68mschmitt/cleavboard/assets/README.md

# Shared assets

- [layout/](layout/README.md): original keyboard layout and plate inputs.
- [artwork/taviana/](artwork/taviana/README.md): supplied logo, board placement
  previews and recorded artwork checks.

Design-specific reference images, models and manufacturing outputs belong to
their design under [`designs/`](../designs/README.md).
