68mschmitt/cleavboard/assets/layout/README.md

# Original layout inputs

These supplied files retain their original contents with descriptive filenames:

| File | Original filename |
| --- | --- |
| [keyboard-layout.json](keyboard-layout.json) | `keyboard-layout(1).json` |
| [keyboard-layout.svg](keyboard-layout.svg) | `keyboard-layout(1).svg` |
| [original-plate.dxf](original-plate.dxf) | `plate-2026-11-07T22_24_25.197Z.dxf` |
| [original-plate.svg](original-plate.svg) | `plate-2026-11-07T22_24_27.294Z.svg` |

Originally supplied in `plate-2026-11-07T22_24_25.197Z/`.
The module design's generator reads `keyboard-layout.json`. Its generated plate,
stabilizer coupons and mounting references are in
[`designs/module-rp2040/mechanical/`](../../designs/module-rp2040/mechanical/README.md).
