68mschmitt/cleavboard/designs/module-rp2040/mechanical/mounting-holes.csv

reference | x_mm | y_mm | drill_mm | reserved_diameter_mm
H1 | 4 | 4 | 2.2 | 6
H2 | 110 | 23.8 | 2.2 | 6
H3 | 220 | 23.8 | 2.2 | 6
H4 | 330 | 23.8 | 2.2 | 6
H5 | 395 | 26 | 2.2 | 6
H6 | 313 | 70 | 2.2 | 6
H7 | 4 | 143 | 2.2 | 6
H8 | 90 | 138 | 2.2 | 6
H9 | 220 | 138 | 2.2 | 6
H10 | 365 | 138 | 2.2 | 6
H11 | 448 | 138 | 2.2 | 6
