68mschmitt/cleavboard/assets/artwork/taviana/embedded-top.png

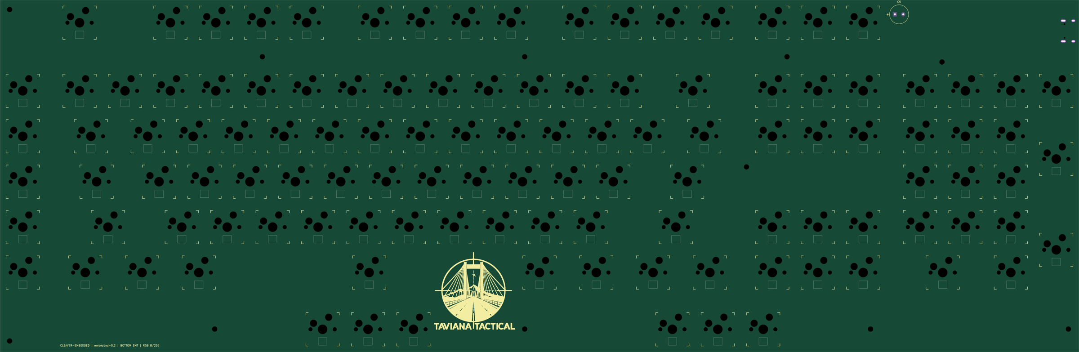
assets/artwork/taviana/embedded-top.png
