68mschmitt/cleavboard/assets/artwork/taviana/module-top.png

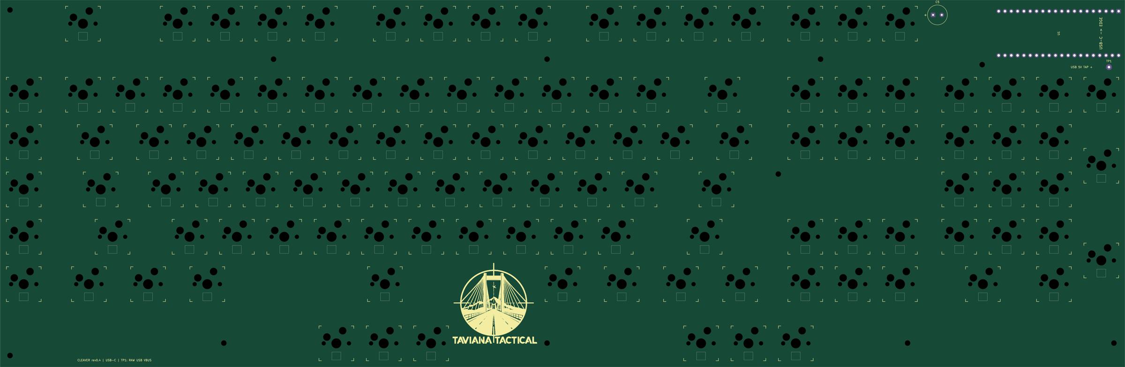
assets/artwork/taviana/module-top.png
