68mschmitt/cleavboard/assets/artwork/taviana/tavi-tac.png

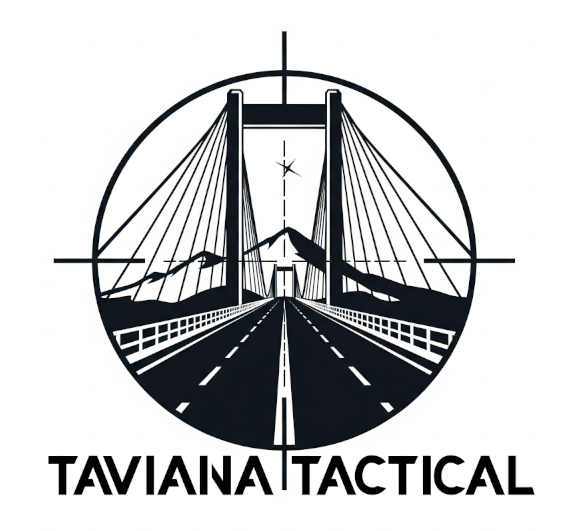
assets/artwork/taviana/tavi-tac.png
