68mschmitt/cleavboard/designs/embedded-rp2040/review/current-review/B.Cu-controller.png

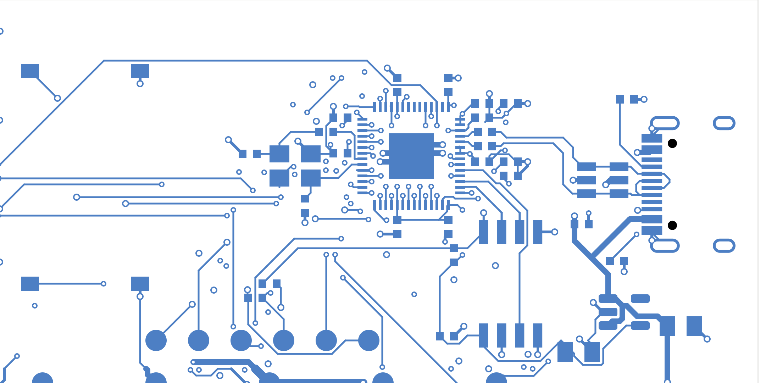
designs/embedded-rp2040/review/current-review/B.Cu-controller.png
