68mschmitt/cleavboard/designs/embedded-rp2040/review/current-review/B.Cu.png

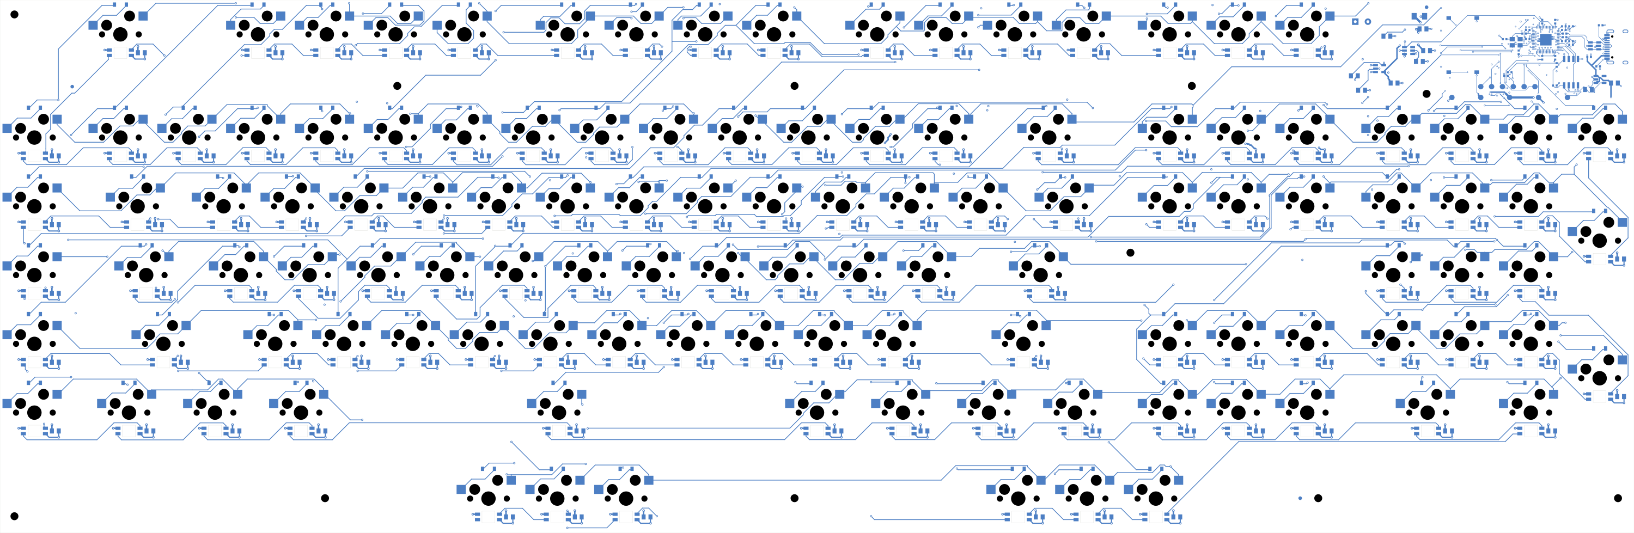
designs/embedded-rp2040/review/current-review/B.Cu.png
