68mschmitt/cleavboard/designs/embedded-rp2040/review/current-review/F.Cu-fan-in.png

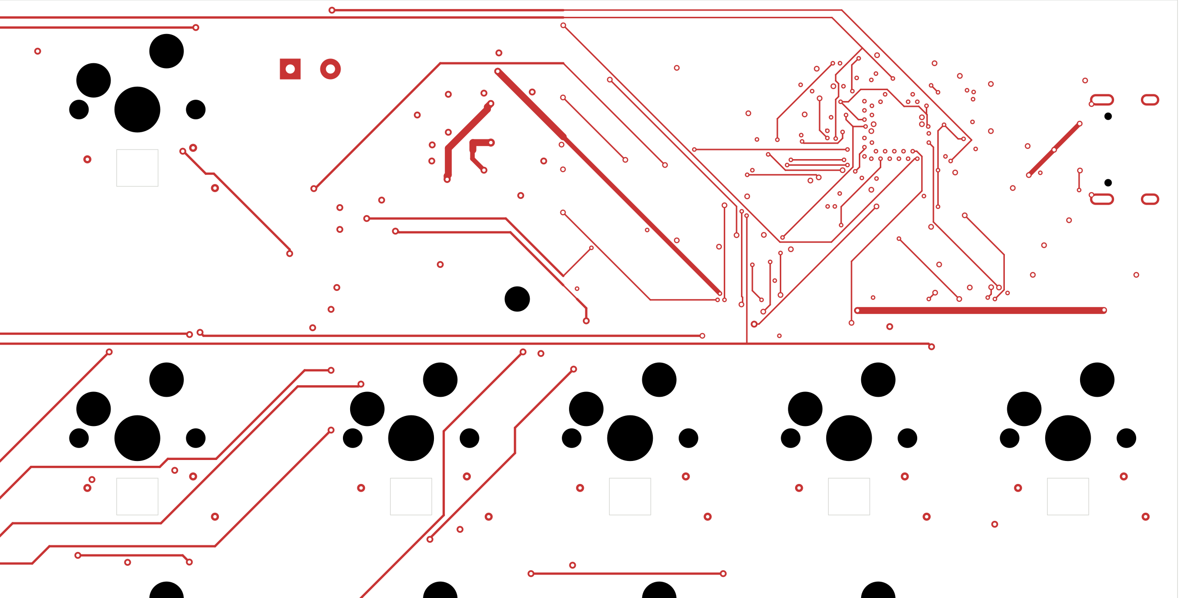
designs/embedded-rp2040/review/current-review/F.Cu-fan-in.png
