68mschmitt/cleavboard/designs/embedded-rp2040/review/current-review/F.Cu.png

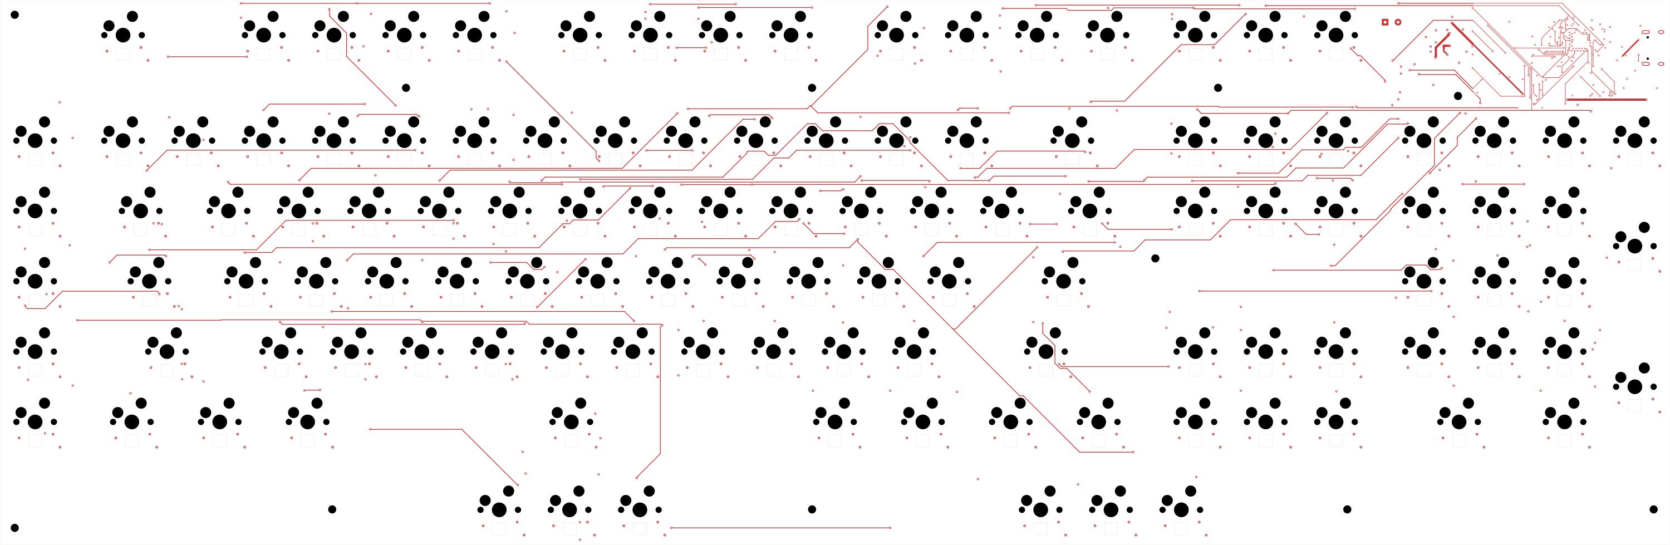
designs/embedded-rp2040/review/current-review/F.Cu.png
