68mschmitt/cleavboard/designs/embedded-rp2040/review/current-review/In1.Cu-fan-in.png

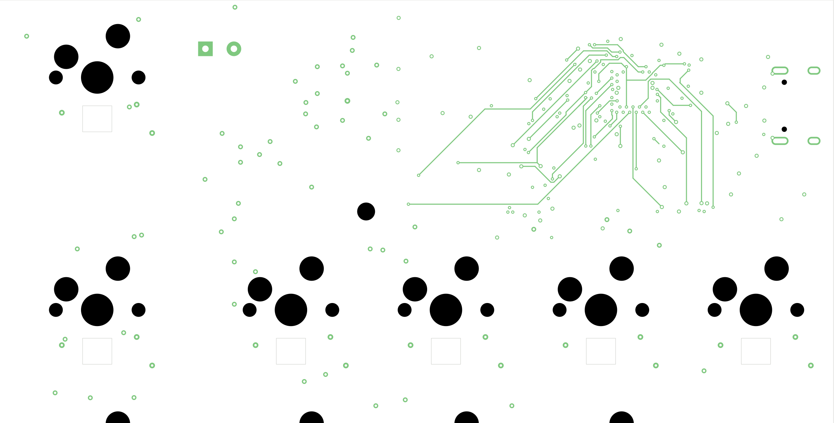
designs/embedded-rp2040/review/current-review/In1.Cu-fan-in.png
