68mschmitt/cleavboard/designs/embedded-rp2040/review/current-review/In1.Cu.png

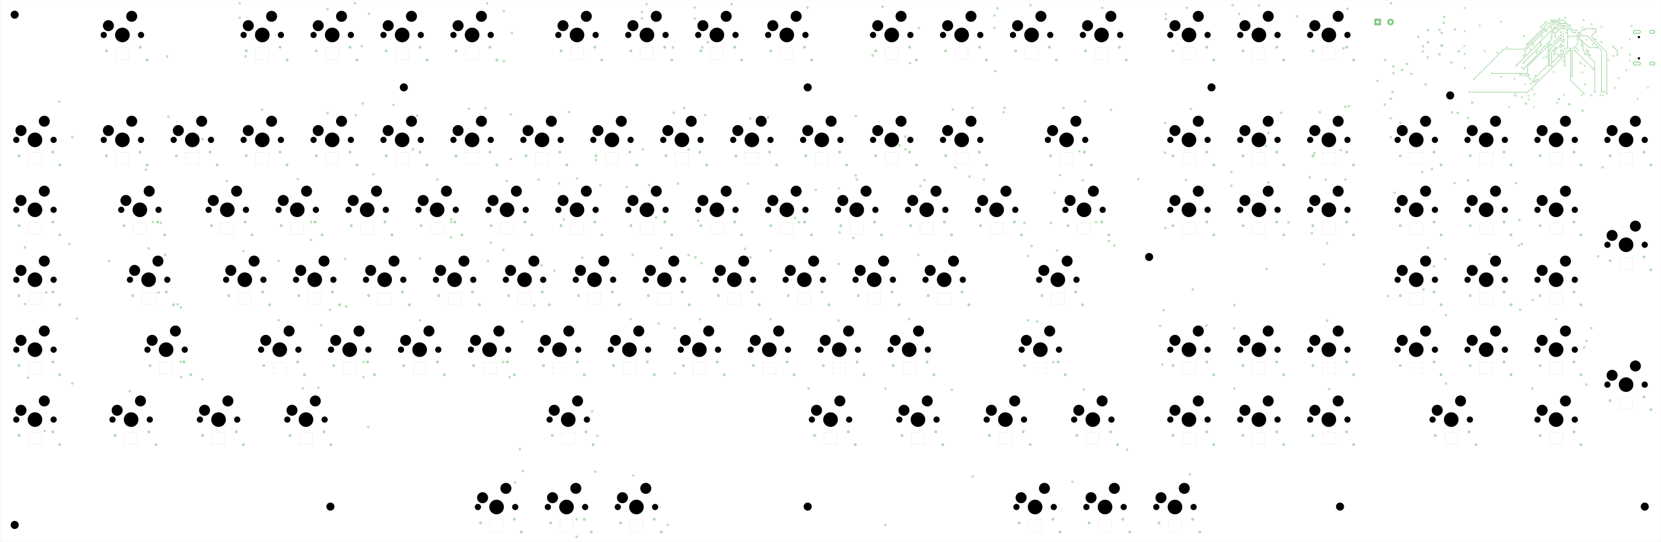
designs/embedded-rp2040/review/current-review/In1.Cu.png
