68mschmitt/cleavboard/designs/embedded-rp2040/review/current-review/In2.Cu-controller.png

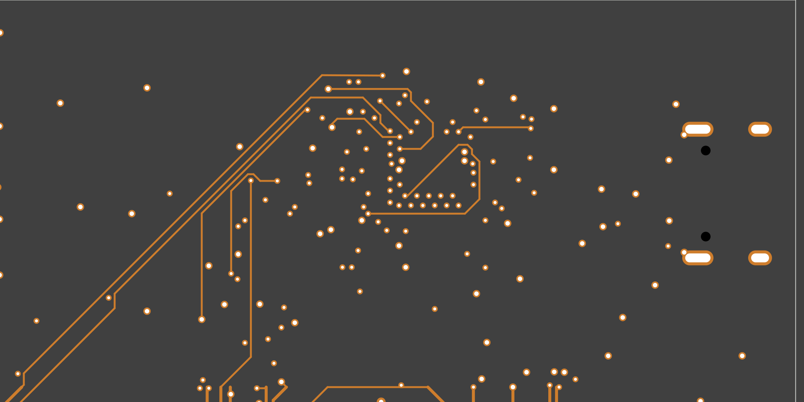
designs/embedded-rp2040/review/current-review/In2.Cu-controller.png
