68mschmitt/cleavboard/designs/embedded-rp2040/review/current-review/In2.Cu-fan-in.png

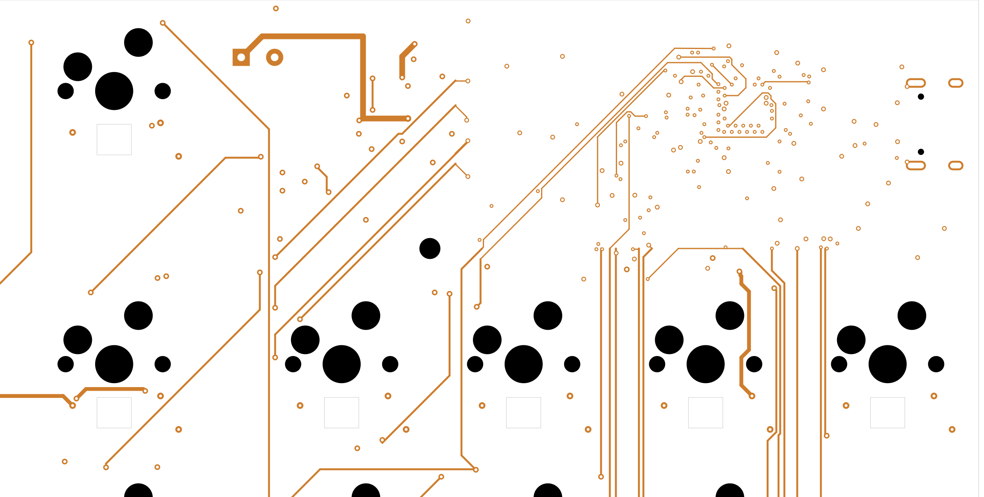
designs/embedded-rp2040/review/current-review/In2.Cu-fan-in.png
