68mschmitt/cleavboard/designs/module-rp2040/previews/Cleaver-bottom.png

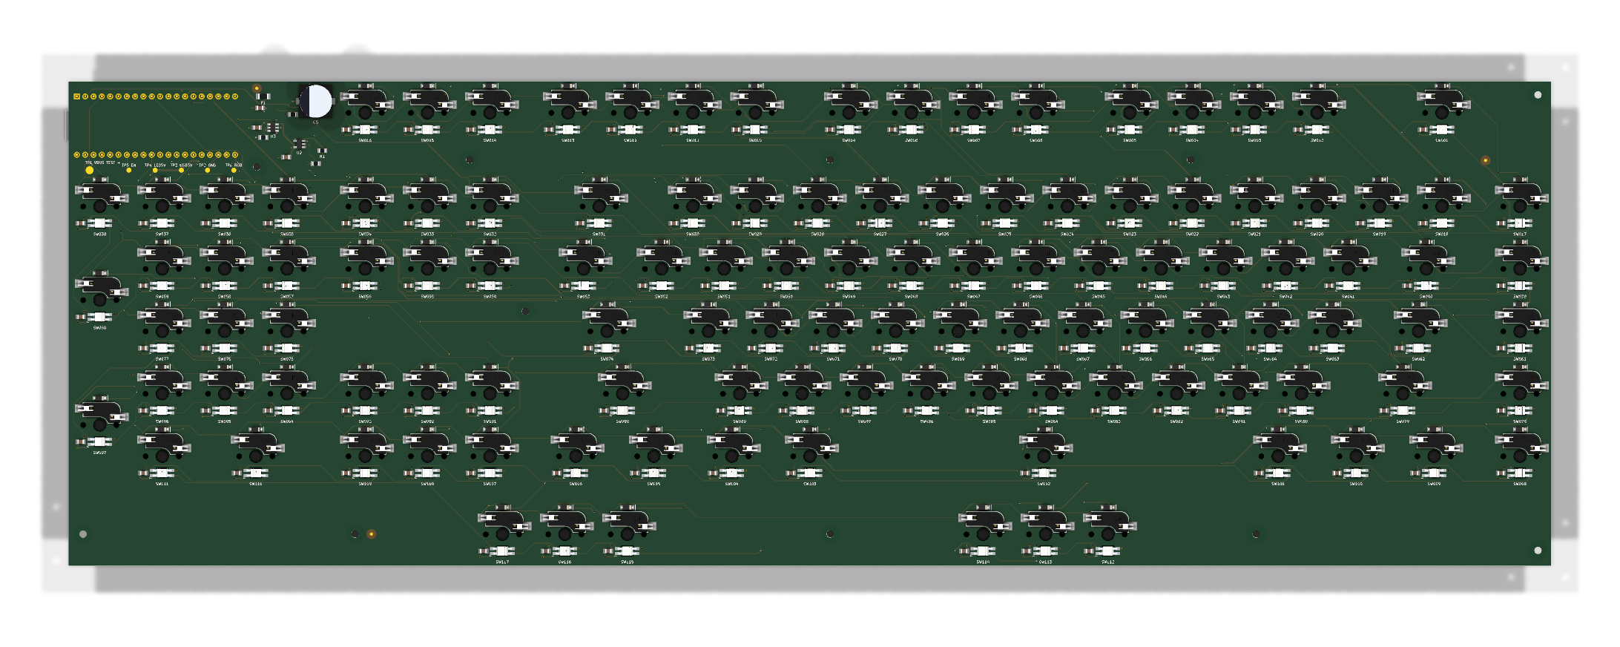
designs/module-rp2040/previews/Cleaver-bottom.png
