68mschmitt/cleavboard/designs/module-rp2040/previews/Cleaver-rev0.7-top.png

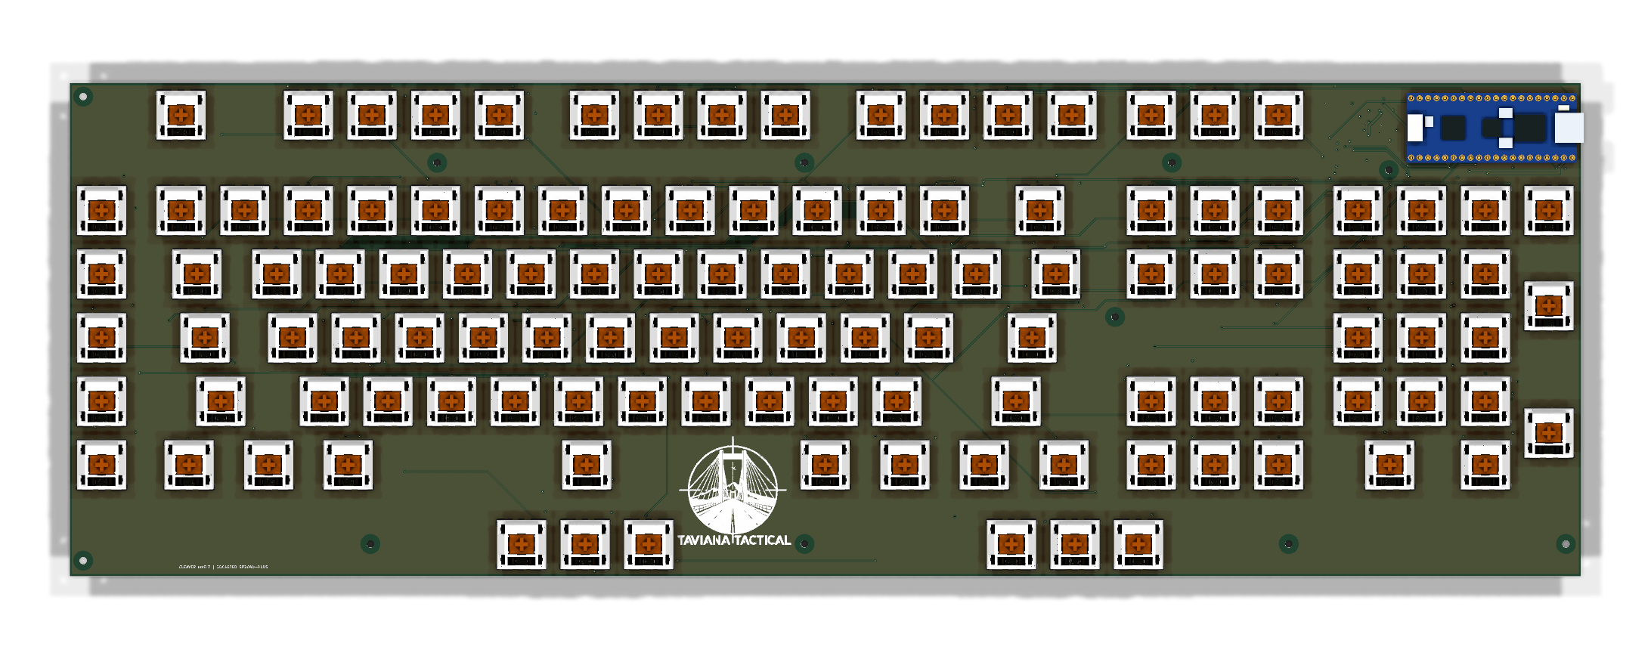
designs/module-rp2040/previews/Cleaver-rev0.7-top.png
