68mschmitt/cleavboard/designs/module-rp2040/references/usb-vbus-ref-pic.jpg

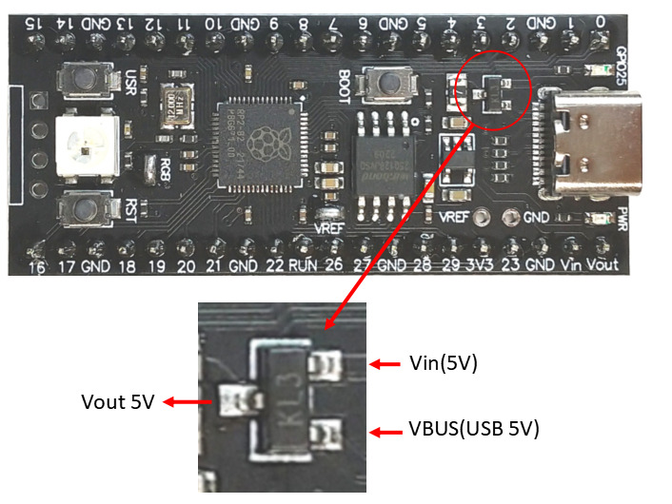
designs/module-rp2040/references/usb-vbus-ref-pic.jpg
