68mschmitt/cleavboard/designs/single-color-devboard/review/3d-bottom.png

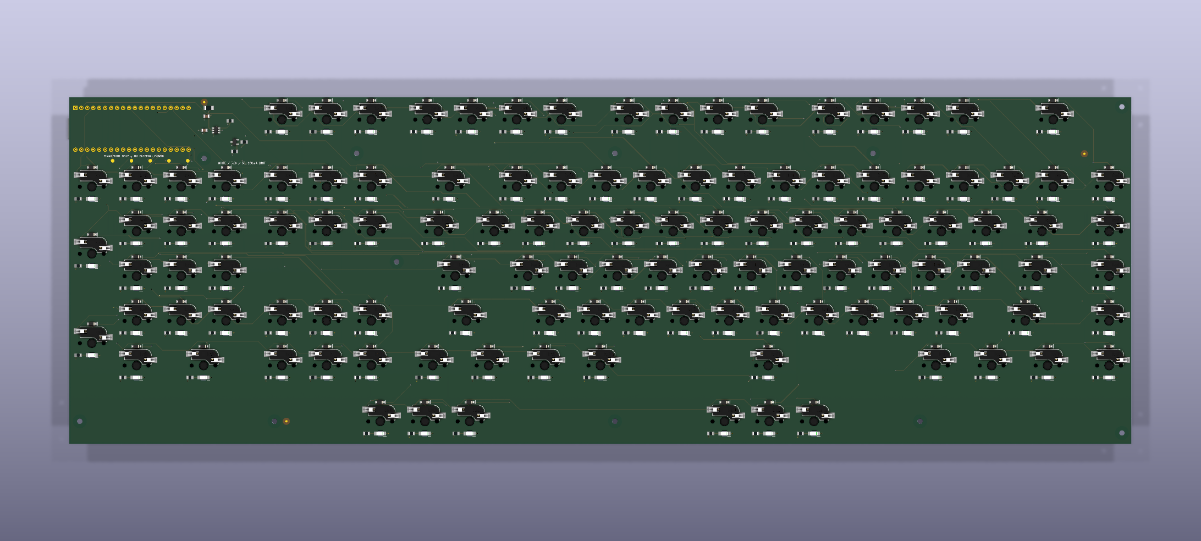
designs/single-color-devboard/review/3d-bottom.png
