68mschmitt/cleavboard/designs/single-color-devboard/review/3d-top.png

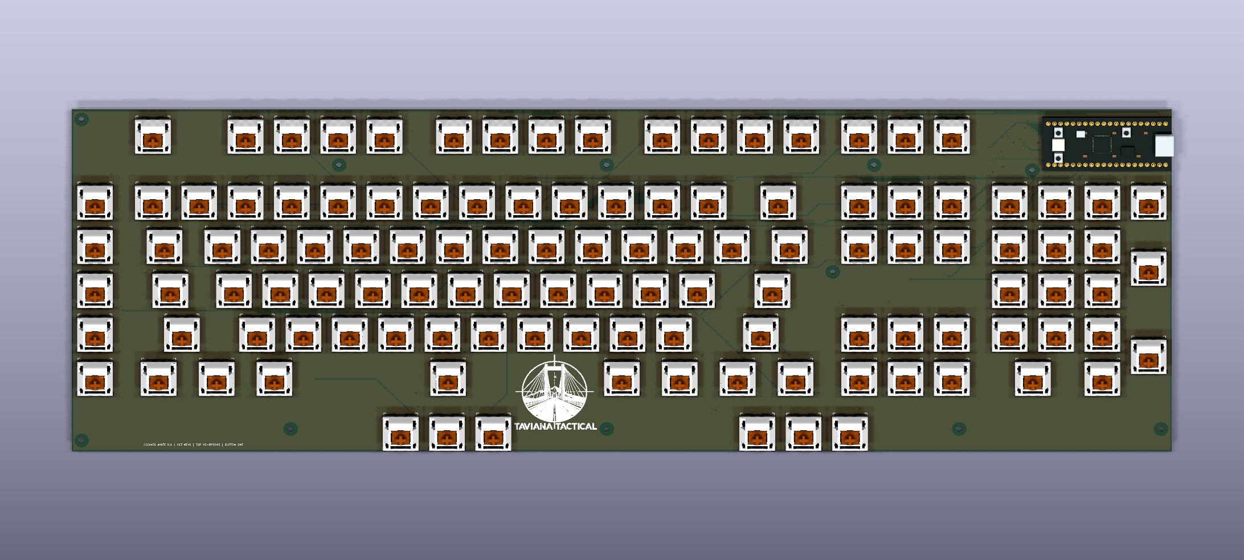
designs/single-color-devboard/review/3d-top.png
