68mschmitt/cleavboard/designs/single-color-devboard/review/bottom-copper.png

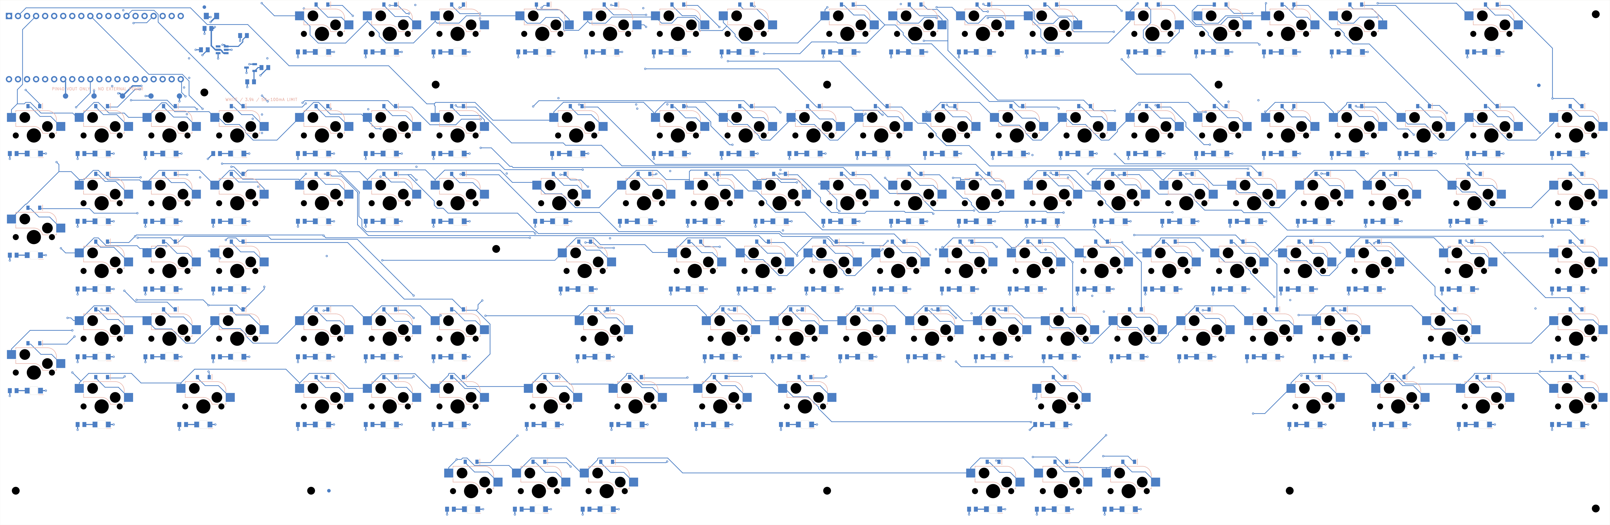
designs/single-color-devboard/review/bottom-copper.png
