68mschmitt/cleavboard/designs/single-color-devboard/review/controller-bottom-detail.png

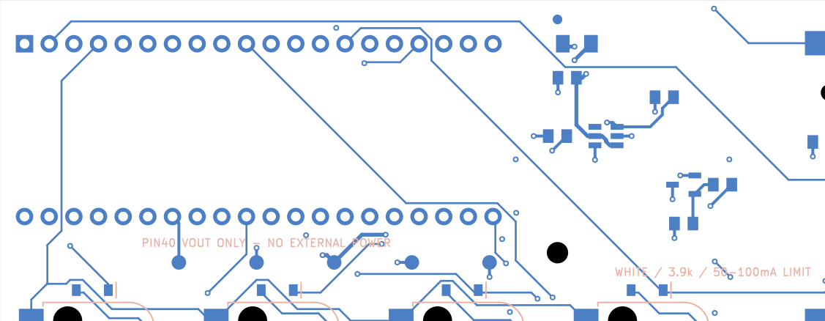
designs/single-color-devboard/review/controller-bottom-detail.png
