68mschmitt/cleavboard/designs/single-color-devboard/review/ground-plane.png

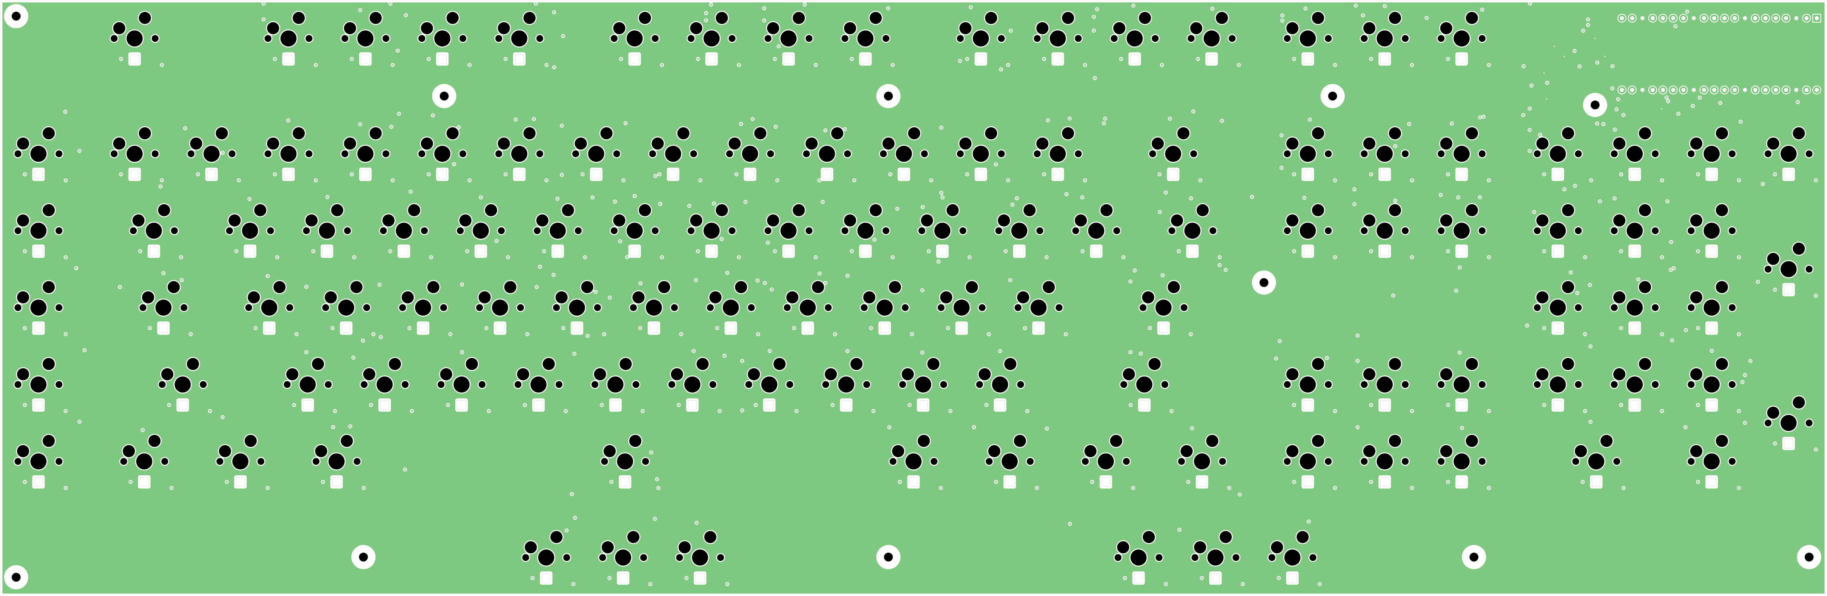
designs/single-color-devboard/review/ground-plane.png
