68mschmitt/cleavboard/designs/single-color-devboard/review/key-cells-bottom-detail.png

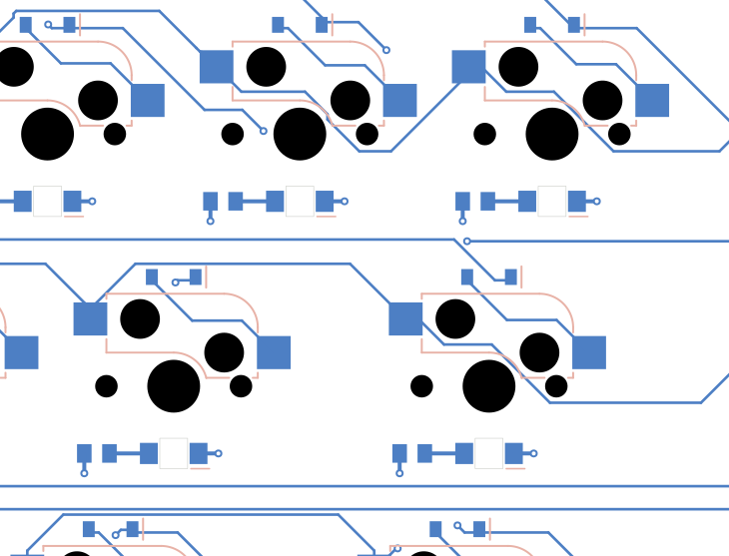
designs/single-color-devboard/review/key-cells-bottom-detail.png
