68mschmitt/cleavboard/designs/single-color-devboard/review/return-plane.png

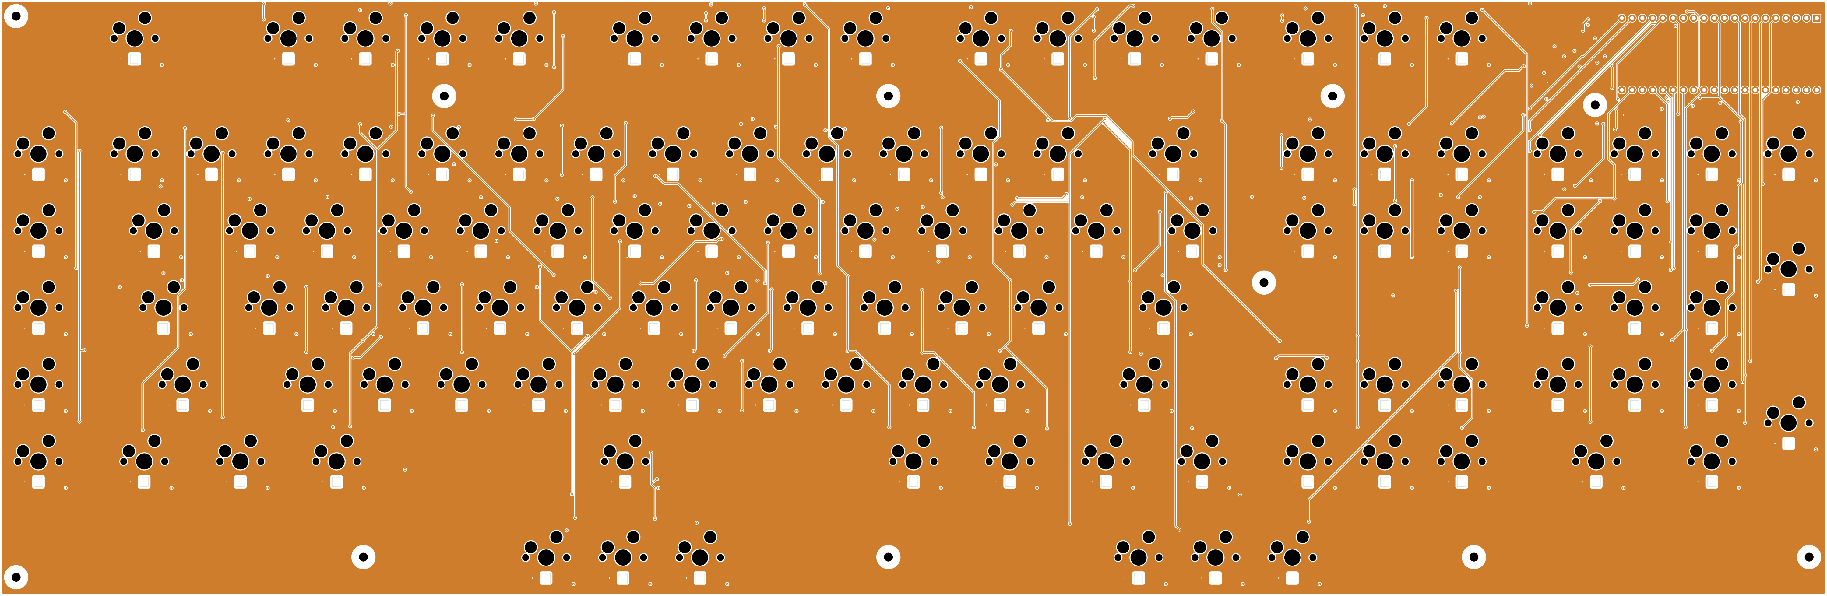
designs/single-color-devboard/review/return-plane.png
