68mschmitt/cleavboard/designs/single-color-devboard/review/top-copper.png

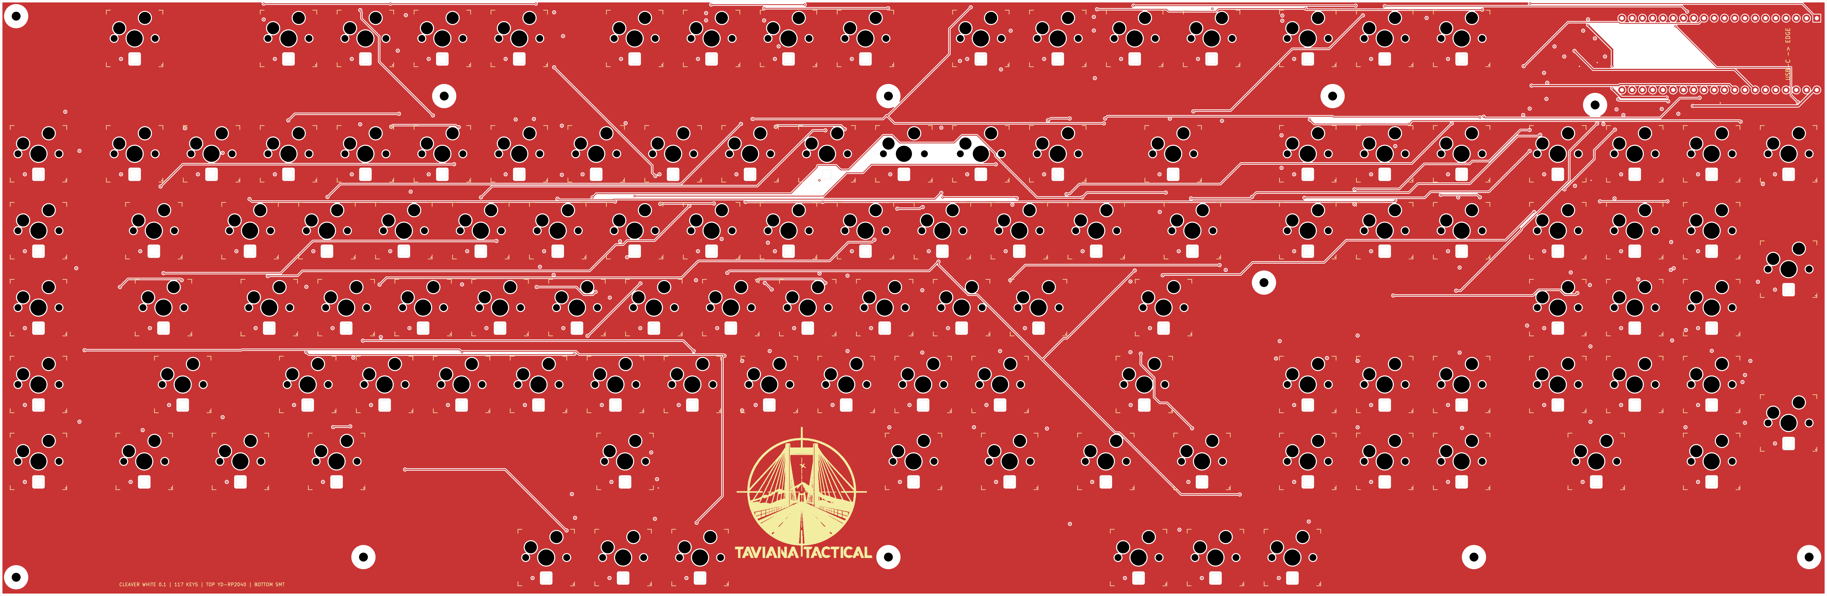
designs/single-color-devboard/review/top-copper.png
