68mschmitt/cleavboard/designs/module-rp2040/manufacturing/BOM.csv

reference | value | footprint | x_mm | y_mm | side | Manufacturer | MPN | LCSC | Key
U1 | Waveshare RP2040-Plus 4MB | Waveshare_RP2040_Plus | 425.7675 | 13.39 | F
J1 | M20-7862042 | Harwin_M20_7862042 | 425.7675 | 4.5 | B | Harwin | M20-7862042 | C5379059
J2 | M20-7862042 | Harwin_M20_7862042 | 425.7675 | 22.28 | B | Harwin | M20-7862042 | C5379059
SW001 | CPG151101S11-16 | HanElectricity_CPG151101S11-16 | 33.3375 | 9.525 | B | HanElectricity | CPG151101S11-16 | C41430893 | Esc
D001 | 1N4148W | D_SOD123 | 33.3375 | 1.2750000000000004 | B | Semtech | 1N4148W | C81598
LED001 | SK6812MINI-E C5149201 | MINI_E | 33.3375 | 14.605 | B | OPSCO Optoelectronics | SK6812MINI-E | C5149201
C101 | 100nF 50V X7R | C_0805 | 39.137499999999996 | 14.605 | B | YAGEO | CC0805KRX7R9BB104 | C49678
SW002 | CPG151101S11-16 | HanElectricity_CPG151101S11-16 | 71.4375 | 9.525 | B | HanElectricity | CPG151101S11-16 | C41430893 | F1
D002 | 1N4148W | D_SOD123 | 71.4375 | 1.2750000000000004 | B | Semtech | 1N4148W | C81598
LED002 | SK6812MINI-E C5149201 | MINI_E | 71.4375 | 14.605 | B | OPSCO Optoelectronics | SK6812MINI-E | C5149201
C102 | 100nF 50V X7R | C_0805 | 77.2375 | 14.605 | B | YAGEO | CC0805KRX7R9BB104 | C49678
SW003 | CPG151101S11-16 | HanElectricity_CPG151101S11-16 | 90.4875 | 9.525 | B | HanElectricity | CPG151101S11-16 | C41430893 | F2
D003 | 1N4148W | D_SOD123 | 90.4875 | 1.2750000000000004 | B | Semtech | 1N4148W | C81598
LED003 | SK6812MINI-E C5149201 | MINI_E | 90.4875 | 14.605 | B | OPSCO Optoelectronics | SK6812MINI-E | C5149201
C103 | 100nF 50V X7R | C_0805 | 96.2875 | 14.605 | B | YAGEO | CC0805KRX7R9BB104 | C49678
SW004 | CPG151101S11-16 | HanElectricity_CPG151101S11-16 | 109.53750000000001 | 9.525 | B | HanElectricity | CPG151101S11-16 | C41430893 | F3
D004 | 1N4148W | D_SOD123 | 109.53750000000001 | 1.2750000000000004 | B | Semtech | 1N4148W | C81598
LED004 | SK6812MINI-E C5149201 | MINI_E | 109.53750000000001 | 14.605 | B | OPSCO Optoelectronics | SK6812MINI-E | C5149201
C104 | 100nF 50V X7R | C_0805 | 115.3375 | 14.605 | B | YAGEO | CC0805KRX7R9BB104 | C49678
SW005 | CPG151101S11-16 | HanElectricity_CPG151101S11-16 | 128.5875 | 9.525 | B | HanElectricity | CPG151101S11-16 | C41430893 | F4
D005 | 1N4148W | D_SOD123 | 128.5875 | 1.2750000000000004 | B | Semtech | 1N4148W | C81598
LED005 | SK6812MINI-E C5149201 | MINI_E | 128.5875 | 14.605 | B | OPSCO Optoelectronics | SK6812MINI-E | C5149201
C105 | 100nF 50V X7R | C_0805 | 134.38750000000002 | 14.605 | B | YAGEO | CC0805KRX7R9BB104 | C49678
SW006 | CPG151101S11-16 | HanElectricity_CPG151101S11-16 | 157.1625 | 9.525 | B | HanElectricity | CPG151101S11-16 | C41430893 | F5
D006 | 1N4148W | D_SOD123 | 157.1625 | 1.2750000000000004 | B | Semtech | 1N4148W | C81598
LED006 | SK6812MINI-E C5149201 | MINI_E | 157.1625 | 14.605 | B | OPSCO Optoelectronics | SK6812MINI-E | C5149201
C106 | 100nF 50V X7R | C_0805 | 162.9625 | 14.605 | B | YAGEO | CC0805KRX7R9BB104 | C49678
SW007 | CPG151101S11-16 | HanElectricity_CPG151101S11-16 | 176.2125 | 9.525 | B | HanElectricity | CPG151101S11-16 | C41430893 | F6
D007 | 1N4148W | D_SOD123 | 176.2125 | 1.2750000000000004 | B | Semtech | 1N4148W | C81598
LED007 | SK6812MINI-E C5149201 | MINI_E | 176.2125 | 14.605 | B | OPSCO Optoelectronics | SK6812MINI-E | C5149201
C107 | 100nF 50V X7R | C_0805 | 182.01250000000002 | 14.605 | B | YAGEO | CC0805KRX7R9BB104 | C49678
SW008 | CPG151101S11-16 | HanElectricity_CPG151101S11-16 | 195.26250000000002 | 9.525 | B | HanElectricity | CPG151101S11-16 | C41430893 | F7
D008 | 1N4148W | D_SOD123 | 195.26250000000002 | 1.2750000000000004 | B | Semtech | 1N4148W | C81598
LED008 | SK6812MINI-E C5149201 | MINI_E | 195.26250000000002 | 14.605 | B | OPSCO Optoelectronics | SK6812MINI-E | C5149201
C108 | 100nF 50V X7R | C_0805 | 201.06250000000003 | 14.605 | B | YAGEO | CC0805KRX7R9BB104 | C49678
SW009 | CPG151101S11-16 | HanElectricity_CPG151101S11-16 | 214.3125 | 9.525 | B | HanElectricity | CPG151101S11-16 | C41430893 | F8
D009 | 1N4148W | D_SOD123 | 214.3125 | 1.2750000000000004 | B | Semtech | 1N4148W | C81598
LED009 | SK6812MINI-E C5149201 | MINI_E | 214.3125 | 14.605 | B | OPSCO Optoelectronics | SK6812MINI-E | C5149201
C109 | 100nF 50V X7R | C_0805 | 220.1125 | 14.605 | B | YAGEO | CC0805KRX7R9BB104 | C49678
SW010 | CPG151101S11-16 | HanElectricity_CPG151101S11-16 | 242.88750000000002 | 9.525 | B | HanElectricity | CPG151101S11-16 | C41430893 | F9
D010 | 1N4148W | D_SOD123 | 242.88750000000002 | 1.2750000000000004 | B | Semtech | 1N4148W | C81598
LED010 | SK6812MINI-E C5149201 | MINI_E | 242.88750000000002 | 14.605 | B | OPSCO Optoelectronics | SK6812MINI-E | C5149201
C110 | 100nF 50V X7R | C_0805 | 248.68750000000003 | 14.605 | B | YAGEO | CC0805KRX7R9BB104 | C49678
SW011 | CPG151101S11-16 | HanElectricity_CPG151101S11-16 | 261.9375 | 9.525 | B | HanElectricity | CPG151101S11-16 | C41430893 | F10
D011 | 1N4148W | D_SOD123 | 261.9375 | 1.2750000000000004 | B | Semtech | 1N4148W | C81598
LED011 | SK6812MINI-E C5149201 | MINI_E | 261.9375 | 14.605 | B | OPSCO Optoelectronics | SK6812MINI-E | C5149201
C111 | 100nF 50V X7R | C_0805 | 267.7375 | 14.605 | B | YAGEO | CC0805KRX7R9BB104 | C49678
SW012 | CPG151101S11-16 | HanElectricity_CPG151101S11-16 | 280.9875 | 9.525 | B | HanElectricity | CPG151101S11-16 | C41430893 | F11
D012 | 1N4148W | D_SOD123 | 280.9875 | 1.2750000000000004 | B | Semtech | 1N4148W | C81598
LED012 | SK6812MINI-E C5149201 | MINI_E | 280.9875 | 14.605 | B | OPSCO Optoelectronics | SK6812MINI-E | C5149201
C112 | 100nF 50V X7R | C_0805 | 286.7875 | 14.605 | B | YAGEO | CC0805KRX7R9BB104 | C49678
SW013 | CPG151101S11-16 | HanElectricity_CPG151101S11-16 | 300.0375 | 9.525 | B | HanElectricity | CPG151101S11-16 | C41430893 | F12
D013 | 1N4148W | D_SOD123 | 300.0375 | 1.2750000000000004 | B | Semtech | 1N4148W | C81598
LED013 | SK6812MINI-E C5149201 | MINI_E | 300.0375 | 14.605 | B | OPSCO Optoelectronics | SK6812MINI-E | C5149201
C113 | 100nF 50V X7R | C_0805 | 305.83750000000003 | 14.605 | B | YAGEO | CC0805KRX7R9BB104 | C49678
SW014 | CPG151101S11-16 | HanElectricity_CPG151101S11-16 | 323.85 | 9.525 | B | HanElectricity | CPG151101S11-16 | C41430893 | PrtSc
D014 | 1N4148W | D_SOD123 | 323.85 | 1.2750000000000004 | B | Semtech | 1N4148W | C81598
LED014 | SK6812MINI-E C5149201 | MINI_E | 323.85 | 14.605 | B | OPSCO Optoelectronics | SK6812MINI-E | C5149201
C114 | 100nF 50V X7R | C_0805 | 329.65000000000003 | 14.605 | B | YAGEO | CC0805KRX7R9BB104 | C49678
SW015 | CPG151101S11-16 | HanElectricity_CPG151101S11-16 | 342.90000000000003 | 9.525 | B | HanElectricity | CPG151101S11-16 | C41430893 | Scroll Lock
D015 | 1N4148W | D_SOD123 | 342.90000000000003 | 1.2750000000000004 | B | Semtech | 1N4148W | C81598
LED015 | SK6812MINI-E C5149201 | MINI_E | 342.90000000000003 | 14.605 | B | OPSCO Optoelectronics | SK6812MINI-E | C5149201
C115 | 100nF 50V X7R | C_0805 | 348.70000000000005 | 14.605 | B | YAGEO | CC0805KRX7R9BB104 | C49678
SW016 | CPG151101S11-16 | HanElectricity_CPG151101S11-16 | 361.95 | 9.525 | B | HanElectricity | CPG151101S11-16 | C41430893 | Pause/Break
D016 | 1N4148W | D_SOD123 | 361.95 | 1.2750000000000004 | B | Semtech | 1N4148W | C81598
LED016 | SK6812MINI-E C5149201 | MINI_E | 361.95 | 14.605 | B | OPSCO Optoelectronics | SK6812MINI-E | C5149201
C116 | 100nF 50V X7R | C_0805 | 367.75 | 14.605 | B | YAGEO | CC0805KRX7R9BB104 | C49678
SW017 | CPG151101S11-16 | HanElectricity_CPG151101S11-16 | 9.525 | 38.1 | B | HanElectricity | CPG151101S11-16 | C41430893 | M1
D017 | 1N4148W | D_SOD123 | 9.525 | 29.85 | B | Semtech | 1N4148W | C81598
LED017 | SK6812MINI-E C5149201 | MINI_E | 9.525 | 43.18 | B | OPSCO Optoelectronics | SK6812MINI-E | C5149201
C117 | 100nF 50V X7R | C_0805 | 15.325 | 43.18 | B | YAGEO | CC0805KRX7R9BB104 | C49678
SW018 | CPG151101S11-16 | HanElectricity_CPG151101S11-16 | 33.3375 | 38.1 | B | HanElectricity | CPG151101S11-16 | C41430893 | ~/`
D018 | 1N4148W | D_SOD123 | 33.3375 | 29.85 | B | Semtech | 1N4148W | C81598
LED018 | SK6812MINI-E C5149201 | MINI_E | 33.3375 | 43.18 | B | OPSCO Optoelectronics | SK6812MINI-E | C5149201
C118 | 100nF 50V X7R | C_0805 | 39.137499999999996 | 43.18 | B | YAGEO | CC0805KRX7R9BB104 | C49678
SW019 | CPG151101S11-16 | HanElectricity_CPG151101S11-16 | 52.3875 | 38.1 | B | HanElectricity | CPG151101S11-16 | C41430893 | !/1
D019 | 1N4148W | D_SOD123 | 52.3875 | 29.85 | B | Semtech | 1N4148W | C81598
LED019 | SK6812MINI-E C5149201 | MINI_E | 52.3875 | 43.18 | B | OPSCO Optoelectronics | SK6812MINI-E | C5149201
C119 | 100nF 50V X7R | C_0805 | 58.1875 | 43.18 | B | YAGEO | CC0805KRX7R9BB104 | C49678
SW020 | CPG151101S11-16 | HanElectricity_CPG151101S11-16 | 71.4375 | 38.1 | B | HanElectricity | CPG151101S11-16 | C41430893 | @/2
D020 | 1N4148W | D_SOD123 | 71.4375 | 29.85 | B | Semtech | 1N4148W | C81598
LED020 | SK6812MINI-E C5149201 | MINI_E | 71.4375 | 43.18 | B | OPSCO Optoelectronics | SK6812MINI-E | C5149201
C120 | 100nF 50V X7R | C_0805 | 77.2375 | 43.18 | B | YAGEO | CC0805KRX7R9BB104 | C49678
SW021 | CPG151101S11-16 | HanElectricity_CPG151101S11-16 | 90.4875 | 38.1 | B | HanElectricity | CPG151101S11-16 | C41430893 | #/3
D021 | 1N4148W | D_SOD123 | 90.4875 | 29.85 | B | Semtech | 1N4148W | C81598
LED021 | SK6812MINI-E C5149201 | MINI_E | 90.4875 | 43.18 | B | OPSCO Optoelectronics | SK6812MINI-E | C5149201
C121 | 100nF 50V X7R | C_0805 | 96.2875 | 43.18 | B | YAGEO | CC0805KRX7R9BB104 | C49678
SW022 | CPG151101S11-16 | HanElectricity_CPG151101S11-16 | 109.53750000000001 | 38.1 | B | HanElectricity | CPG151101S11-16 | C41430893 | $/4
D022 | 1N4148W | D_SOD123 | 109.53750000000001 | 29.85 | B | Semtech | 1N4148W | C81598
LED022 | SK6812MINI-E C5149201 | MINI_E | 109.53750000000001 | 43.18 | B | OPSCO Optoelectronics | SK6812MINI-E | C5149201
C122 | 100nF 50V X7R | C_0805 | 115.3375 | 43.18 | B | YAGEO | CC0805KRX7R9BB104 | C49678
SW023 | CPG151101S11-16 | HanElectricity_CPG151101S11-16 | 128.5875 | 38.1 | B | HanElectricity | CPG151101S11-16 | C41430893 | %/5
D023 | 1N4148W | D_SOD123 | 128.5875 | 29.85 | B | Semtech | 1N4148W | C81598
LED023 | SK6812MINI-E C5149201 | MINI_E | 128.5875 | 43.18 | B | OPSCO Optoelectronics | SK6812MINI-E | C5149201
C123 | 100nF 50V X7R | C_0805 | 134.38750000000002 | 43.18 | B | YAGEO | CC0805KRX7R9BB104 | C49678
SW024 | CPG151101S11-16 | HanElectricity_CPG151101S11-16 | 147.63750000000002 | 38.1 | B | HanElectricity | CPG151101S11-16 | C41430893 | ^/6
D024 | 1N4148W | D_SOD123 | 147.63750000000002 | 29.85 | B | Semtech | 1N4148W | C81598
LED024 | SK6812MINI-E C5149201 | MINI_E | 147.63750000000002 | 43.18 | B | OPSCO Optoelectronics | SK6812MINI-E | C5149201
C124 | 100nF 50V X7R | C_0805 | 153.43750000000003 | 43.18 | B | YAGEO | CC0805KRX7R9BB104 | C49678
SW025 | CPG151101S11-16 | HanElectricity_CPG151101S11-16 | 166.6875 | 38.1 | B | HanElectricity | CPG151101S11-16 | C41430893 | &/7
D025 | 1N4148W | D_SOD123 | 166.6875 | 29.85 | B | Semtech | 1N4148W | C81598
LED025 | SK6812MINI-E C5149201 | MINI_E | 166.6875 | 43.18 | B | OPSCO Optoelectronics | SK6812MINI-E | C5149201
C125 | 100nF 50V X7R | C_0805 | 172.4875 | 43.18 | B | YAGEO | CC0805KRX7R9BB104 | C49678
SW026 | CPG151101S11-16 | HanElectricity_CPG151101S11-16 | 185.7375 | 38.1 | B | HanElectricity | CPG151101S11-16 | C41430893 | */8
D026 | 1N4148W | D_SOD123 | 185.7375 | 29.85 | B | Semtech | 1N4148W | C81598
LED026 | SK6812MINI-E C5149201 | MINI_E | 185.7375 | 43.18 | B | OPSCO Optoelectronics | SK6812MINI-E | C5149201
C126 | 100nF 50V X7R | C_0805 | 191.53750000000002 | 43.18 | B | YAGEO | CC0805KRX7R9BB104 | C49678
SW027 | CPG151101S11-16 | HanElectricity_CPG151101S11-16 | 204.7875 | 38.1 | B | HanElectricity | CPG151101S11-16 | C41430893 | (/9
D027 | 1N4148W | D_SOD123 | 204.7875 | 29.85 | B | Semtech | 1N4148W | C81598
LED027 | SK6812MINI-E C5149201 | MINI_E | 204.7875 | 43.18 | B | OPSCO Optoelectronics | SK6812MINI-E | C5149201
C127 | 100nF 50V X7R | C_0805 | 210.5875 | 43.18 | B | YAGEO | CC0805KRX7R9BB104 | C49678
SW028 | CPG151101S11-16 | HanElectricity_CPG151101S11-16 | 223.8375 | 38.1 | B | HanElectricity | CPG151101S11-16 | C41430893 | )/0
D028 | 1N4148W | D_SOD123 | 223.8375 | 29.85 | B | Semtech | 1N4148W | C81598
LED028 | SK6812MINI-E C5149201 | MINI_E | 223.8375 | 43.18 | B | OPSCO Optoelectronics | SK6812MINI-E | C5149201
C128 | 100nF 50V X7R | C_0805 | 229.63750000000002 | 43.18 | B | YAGEO | CC0805KRX7R9BB104 | C49678
SW029 | CPG151101S11-16 | HanElectricity_CPG151101S11-16 | 242.88750000000002 | 38.1 | B | HanElectricity | CPG151101S11-16 | C41430893 | _/-
D029 | 1N4148W | D_SOD123 | 242.88750000000002 | 29.85 | B | Semtech | 1N4148W | C81598
LED029 | SK6812MINI-E C5149201 | MINI_E | 242.88750000000002 | 43.18 | B | OPSCO Optoelectronics | SK6812MINI-E | C5149201
C129 | 100nF 50V X7R | C_0805 | 248.68750000000003 | 43.18 | B | YAGEO | CC0805KRX7R9BB104 | C49678
SW030 | CPG151101S11-16 | HanElectricity_CPG151101S11-16 | 261.9375 | 38.1 | B | HanElectricity | CPG151101S11-16 | C41430893 | +/=
D030 | 1N4148W | D_SOD123 | 261.9375 | 29.85 | B | Semtech | 1N4148W | C81598
LED030 | SK6812MINI-E C5149201 | MINI_E | 261.9375 | 43.18 | B | OPSCO Optoelectronics | SK6812MINI-E | C5149201
C130 | 100nF 50V X7R | C_0805 | 267.7375 | 43.18 | B | YAGEO | CC0805KRX7R9BB104 | C49678
SW031 | CPG151101S11-16 | HanElectricity_CPG151101S11-16 | 290.5125 | 38.1 | B | HanElectricity | CPG151101S11-16 | C41430893 | Backspace
D031 | 1N4148W | D_SOD123 | 290.5125 | 29.85 | B | Semtech | 1N4148W | C81598
LED031 | SK6812MINI-E C5149201 | MINI_E | 290.5125 | 43.18 | B | OPSCO Optoelectronics | SK6812MINI-E | C5149201
C131 | 100nF 50V X7R | C_0805 | 296.3125 | 43.18 | B | YAGEO | CC0805KRX7R9BB104 | C49678
SW032 | CPG151101S11-16 | HanElectricity_CPG151101S11-16 | 323.85 | 38.1 | B | HanElectricity | CPG151101S11-16 | C41430893 | Insert
D032 | 1N4148W | D_SOD123 | 323.85 | 29.85 | B | Semtech | 1N4148W | C81598
LED032 | SK6812MINI-E C5149201 | MINI_E | 323.85 | 43.18 | B | OPSCO Optoelectronics | SK6812MINI-E | C5149201
C132 | 100nF 50V X7R | C_0805 | 329.65000000000003 | 43.18 | B | YAGEO | CC0805KRX7R9BB104 | C49678
SW033 | CPG151101S11-16 | HanElectricity_CPG151101S11-16 | 342.90000000000003 | 38.1 | B | HanElectricity | CPG151101S11-16 | C41430893 | Home
D033 | 1N4148W | D_SOD123 | 342.90000000000003 | 29.85 | B | Semtech | 1N4148W | C81598
LED033 | SK6812MINI-E C5149201 | MINI_E | 342.90000000000003 | 43.18 | B | OPSCO Optoelectronics | SK6812MINI-E | C5149201
C133 | 100nF 50V X7R | C_0805 | 348.70000000000005 | 43.18 | B | YAGEO | CC0805KRX7R9BB104 | C49678
SW034 | CPG151101S11-16 | HanElectricity_CPG151101S11-16 | 361.95 | 38.1 | B | HanElectricity | CPG151101S11-16 | C41430893 | PgUp
D034 | 1N4148W | D_SOD123 | 361.95 | 29.85 | B | Semtech | 1N4148W | C81598
LED034 | SK6812MINI-E C5149201 | MINI_E | 361.95 | 43.18 | B | OPSCO Optoelectronics | SK6812MINI-E | C5149201
C134 | 100nF 50V X7R | C_0805 | 367.75 | 43.18 | B | YAGEO | CC0805KRX7R9BB104 | C49678
SW035 | CPG151101S11-16 | HanElectricity_CPG151101S11-16 | 385.7625 | 38.1 | B | HanElectricity | CPG151101S11-16 | C41430893 | Num Lock
D035 | 1N4148W | D_SOD123 | 385.7625 | 29.85 | B | Semtech | 1N4148W | C81598
LED035 | SK6812MINI-E C5149201 | MINI_E | 385.7625 | 43.18 | B | OPSCO Optoelectronics | SK6812MINI-E | C5149201
C135 | 100nF 50V X7R | C_0805 | 391.5625 | 43.18 | B | YAGEO | CC0805KRX7R9BB104 | C49678
SW036 | CPG151101S11-16 | HanElectricity_CPG151101S11-16 | 404.8125 | 38.1 | B | HanElectricity | CPG151101S11-16 | C41430893 | /
D036 | 1N4148W | D_SOD123 | 404.8125 | 29.85 | B | Semtech | 1N4148W | C81598
LED036 | SK6812MINI-E C5149201 | MINI_E | 404.8125 | 43.18 | B | OPSCO Optoelectronics | SK6812MINI-E | C5149201
C136 | 100nF 50V X7R | C_0805 | 410.6125 | 43.18 | B | YAGEO | CC0805KRX7R9BB104 | C49678
SW037 | CPG151101S11-16 | HanElectricity_CPG151101S11-16 | 423.8625 | 38.1 | B | HanElectricity | CPG151101S11-16 | C41430893 | *
D037 | 1N4148W | D_SOD123 | 423.8625 | 29.85 | B | Semtech | 1N4148W | C81598
LED037 | SK6812MINI-E C5149201 | MINI_E | 423.8625 | 43.18 | B | OPSCO Optoelectronics | SK6812MINI-E | C5149201
C137 | 100nF 50V X7R | C_0805 | 429.6625 | 43.18 | B | YAGEO | CC0805KRX7R9BB104 | C49678
SW038 | CPG151101S11-16 | HanElectricity_CPG151101S11-16 | 442.9125 | 38.1 | B | HanElectricity | CPG151101S11-16 | C41430893 | -
D038 | 1N4148W | D_SOD123 | 442.9125 | 29.85 | B | Semtech | 1N4148W | C81598
LED038 | SK6812MINI-E C5149201 | MINI_E | 442.9125 | 43.18 | B | OPSCO Optoelectronics | SK6812MINI-E | C5149201
C138 | 100nF 50V X7R | C_0805 | 448.71250000000003 | 43.18 | B | YAGEO | CC0805KRX7R9BB104 | C49678
SW039 | CPG151101S11-16 | HanElectricity_CPG151101S11-16 | 9.525 | 57.150000000000006 | B | HanElectricity | CPG151101S11-16 | C41430893 | M2
D039 | 1N4148W | D_SOD123 | 9.525 | 48.900000000000006 | B | Semtech | 1N4148W | C81598
LED039 | SK6812MINI-E C5149201 | MINI_E | 9.525 | 62.230000000000004 | B | OPSCO Optoelectronics | SK6812MINI-E | C5149201
C139 | 100nF 50V X7R | C_0805 | 15.325 | 62.230000000000004 | B | YAGEO | CC0805KRX7R9BB104 | C49678
SW040 | CPG151101S11-16 | HanElectricity_CPG151101S11-16 | 38.1 | 57.150000000000006 | B | HanElectricity | CPG151101S11-16 | C41430893 | Tab
D040 | 1N4148W | D_SOD123 | 38.1 | 48.900000000000006 | B | Semtech | 1N4148W | C81598
LED040 | SK6812MINI-E C5149201 | MINI_E | 38.1 | 62.230000000000004 | B | OPSCO Optoelectronics | SK6812MINI-E | C5149201
C140 | 100nF 50V X7R | C_0805 | 43.9 | 62.230000000000004 | B | YAGEO | CC0805KRX7R9BB104 | C49678
SW041 | CPG151101S11-16 | HanElectricity_CPG151101S11-16 | 61.9125 | 57.150000000000006 | B | HanElectricity | CPG151101S11-16 | C41430893 | Q
D041 | 1N4148W | D_SOD123 | 61.9125 | 48.900000000000006 | B | Semtech | 1N4148W | C81598
LED041 | SK6812MINI-E C5149201 | MINI_E | 61.9125 | 62.230000000000004 | B | OPSCO Optoelectronics | SK6812MINI-E | C5149201
C141 | 100nF 50V X7R | C_0805 | 67.7125 | 62.230000000000004 | B | YAGEO | CC0805KRX7R9BB104 | C49678
SW042 | CPG151101S11-16 | HanElectricity_CPG151101S11-16 | 80.9625 | 57.150000000000006 | B | HanElectricity | CPG151101S11-16 | C41430893 | W
D042 | 1N4148W | D_SOD123 | 80.9625 | 48.900000000000006 | B | Semtech | 1N4148W | C81598
LED042 | SK6812MINI-E C5149201 | MINI_E | 80.9625 | 62.230000000000004 | B | OPSCO Optoelectronics | SK6812MINI-E | C5149201
C142 | 100nF 50V X7R | C_0805 | 86.7625 | 62.230000000000004 | B | YAGEO | CC0805KRX7R9BB104 | C49678
SW043 | CPG151101S11-16 | HanElectricity_CPG151101S11-16 | 100.0125 | 57.150000000000006 | B | HanElectricity | CPG151101S11-16 | C41430893 | E
D043 | 1N4148W | D_SOD123 | 100.0125 | 48.900000000000006 | B | Semtech | 1N4148W | C81598
LED043 | SK6812MINI-E C5149201 | MINI_E | 100.0125 | 62.230000000000004 | B | OPSCO Optoelectronics | SK6812MINI-E | C5149201
C143 | 100nF 50V X7R | C_0805 | 105.8125 | 62.230000000000004 | B | YAGEO | CC0805KRX7R9BB104 | C49678
SW044 | CPG151101S11-16 | HanElectricity_CPG151101S11-16 | 119.0625 | 57.150000000000006 | B | HanElectricity | CPG151101S11-16 | C41430893 | R
D044 | 1N4148W | D_SOD123 | 119.0625 | 48.900000000000006 | B | Semtech | 1N4148W | C81598
LED044 | SK6812MINI-E C5149201 | MINI_E | 119.0625 | 62.230000000000004 | B | OPSCO Optoelectronics | SK6812MINI-E | C5149201
C144 | 100nF 50V X7R | C_0805 | 124.8625 | 62.230000000000004 | B | YAGEO | CC0805KRX7R9BB104 | C49678
SW045 | CPG151101S11-16 | HanElectricity_CPG151101S11-16 | 138.1125 | 57.150000000000006 | B | HanElectricity | CPG151101S11-16 | C41430893 | T
D045 | 1N4148W | D_SOD123 | 138.1125 | 48.900000000000006 | B | Semtech | 1N4148W | C81598
LED045 | SK6812MINI-E C5149201 | MINI_E | 138.1125 | 62.230000000000004 | B | OPSCO Optoelectronics | SK6812MINI-E | C5149201
C145 | 100nF 50V X7R | C_0805 | 143.91250000000002 | 62.230000000000004 | B | YAGEO | CC0805KRX7R9BB104 | C49678
SW046 | CPG151101S11-16 | HanElectricity_CPG151101S11-16 | 157.1625 | 57.150000000000006 | B | HanElectricity | CPG151101S11-16 | C41430893 | Y
D046 | 1N4148W | D_SOD123 | 157.1625 | 48.900000000000006 | B | Semtech | 1N4148W | C81598
LED046 | SK6812MINI-E C5149201 | MINI_E | 157.1625 | 62.230000000000004 | B | OPSCO Optoelectronics | SK6812MINI-E | C5149201
C146 | 100nF 50V X7R | C_0805 | 162.9625 | 62.230000000000004 | B | YAGEO | CC0805KRX7R9BB104 | C49678
SW047 | CPG151101S11-16 | HanElectricity_CPG151101S11-16 | 176.2125 | 57.150000000000006 | B | HanElectricity | CPG151101S11-16 | C41430893 | U
D047 | 1N4148W | D_SOD123 | 176.2125 | 48.900000000000006 | B | Semtech | 1N4148W | C81598
LED047 | SK6812MINI-E C5149201 | MINI_E | 176.2125 | 62.230000000000004 | B | OPSCO Optoelectronics | SK6812MINI-E | C5149201
C147 | 100nF 50V X7R | C_0805 | 182.01250000000002 | 62.230000000000004 | B | YAGEO | CC0805KRX7R9BB104 | C49678
SW048 | CPG151101S11-16 | HanElectricity_CPG151101S11-16 | 195.26250000000002 | 57.150000000000006 | B | HanElectricity | CPG151101S11-16 | C41430893 | I
D048 | 1N4148W | D_SOD123 | 195.26250000000002 | 48.900000000000006 | B | Semtech | 1N4148W | C81598
LED048 | SK6812MINI-E C5149201 | MINI_E | 195.26250000000002 | 62.230000000000004 | B | OPSCO Optoelectronics | SK6812MINI-E | C5149201
C148 | 100nF 50V X7R | C_0805 | 201.06250000000003 | 62.230000000000004 | B | YAGEO | CC0805KRX7R9BB104 | C49678
SW049 | CPG151101S11-16 | HanElectricity_CPG151101S11-16 | 214.3125 | 57.150000000000006 | B | HanElectricity | CPG151101S11-16 | C41430893 | O
D049 | 1N4148W | D_SOD123 | 214.3125 | 48.900000000000006 | B | Semtech | 1N4148W | C81598
LED049 | SK6812MINI-E C5149201 | MINI_E | 214.3125 | 62.230000000000004 | B | OPSCO Optoelectronics | SK6812MINI-E | C5149201
C149 | 100nF 50V X7R | C_0805 | 220.1125 | 62.230000000000004 | B | YAGEO | CC0805KRX7R9BB104 | C49678
SW050 | CPG151101S11-16 | HanElectricity_CPG151101S11-16 | 233.3625 | 57.150000000000006 | B | HanElectricity | CPG151101S11-16 | C41430893 | P
D050 | 1N4148W | D_SOD123 | 233.3625 | 48.900000000000006 | B | Semtech | 1N4148W | C81598
LED050 | SK6812MINI-E C5149201 | MINI_E | 233.3625 | 62.230000000000004 | B | OPSCO Optoelectronics | SK6812MINI-E | C5149201
C150 | 100nF 50V X7R | C_0805 | 239.16250000000002 | 62.230000000000004 | B | YAGEO | CC0805KRX7R9BB104 | C49678
SW051 | CPG151101S11-16 | HanElectricity_CPG151101S11-16 | 252.41250000000002 | 57.150000000000006 | B | HanElectricity | CPG151101S11-16 | C41430893 | {/[
D051 | 1N4148W | D_SOD123 | 252.41250000000002 | 48.900000000000006 | B | Semtech | 1N4148W | C81598
LED051 | SK6812MINI-E C5149201 | MINI_E | 252.41250000000002 | 62.230000000000004 | B | OPSCO Optoelectronics | SK6812MINI-E | C5149201
C151 | 100nF 50V X7R | C_0805 | 258.21250000000003 | 62.230000000000004 | B | YAGEO | CC0805KRX7R9BB104 | C49678
SW052 | CPG151101S11-16 | HanElectricity_CPG151101S11-16 | 271.46250000000003 | 57.150000000000006 | B | HanElectricity | CPG151101S11-16 | C41430893 | }/]
D052 | 1N4148W | D_SOD123 | 271.46250000000003 | 48.900000000000006 | B | Semtech | 1N4148W | C81598
LED052 | SK6812MINI-E C5149201 | MINI_E | 271.46250000000003 | 62.230000000000004 | B | OPSCO Optoelectronics | SK6812MINI-E | C5149201
C152 | 100nF 50V X7R | C_0805 | 277.26250000000005 | 62.230000000000004 | B | YAGEO | CC0805KRX7R9BB104 | C49678
SW053 | CPG151101S11-16 | HanElectricity_CPG151101S11-16 | 295.27500000000003 | 57.150000000000006 | B | HanElectricity | CPG151101S11-16 | C41430893 | |/\
D053 | 1N4148W | D_SOD123 | 295.27500000000003 | 48.900000000000006 | B | Semtech | 1N4148W | C81598
LED053 | SK6812MINI-E C5149201 | MINI_E | 295.27500000000003 | 62.230000000000004 | B | OPSCO Optoelectronics | SK6812MINI-E | C5149201
C153 | 100nF 50V X7R | C_0805 | 301.07500000000005 | 62.230000000000004 | B | YAGEO | CC0805KRX7R9BB104 | C49678
SW054 | CPG151101S11-16 | HanElectricity_CPG151101S11-16 | 323.85 | 57.150000000000006 | B | HanElectricity | CPG151101S11-16 | C41430893 | Delete
D054 | 1N4148W | D_SOD123 | 323.85 | 48.900000000000006 | B | Semtech | 1N4148W | C81598
LED054 | SK6812MINI-E C5149201 | MINI_E | 323.85 | 62.230000000000004 | B | OPSCO Optoelectronics | SK6812MINI-E | C5149201
C154 | 100nF 50V X7R | C_0805 | 329.65000000000003 | 62.230000000000004 | B | YAGEO | CC0805KRX7R9BB104 | C49678
SW055 | CPG151101S11-16 | HanElectricity_CPG151101S11-16 | 342.90000000000003 | 57.150000000000006 | B | HanElectricity | CPG151101S11-16 | C41430893 | End
D055 | 1N4148W | D_SOD123 | 342.90000000000003 | 48.900000000000006 | B | Semtech | 1N4148W | C81598
LED055 | SK6812MINI-E C5149201 | MINI_E | 342.90000000000003 | 62.230000000000004 | B | OPSCO Optoelectronics | SK6812MINI-E | C5149201
C155 | 100nF 50V X7R | C_0805 | 348.70000000000005 | 62.230000000000004 | B | YAGEO | CC0805KRX7R9BB104 | C49678
SW056 | CPG151101S11-16 | HanElectricity_CPG151101S11-16 | 361.95 | 57.150000000000006 | B | HanElectricity | CPG151101S11-16 | C41430893 | PgDn
D056 | 1N4148W | D_SOD123 | 361.95 | 48.900000000000006 | B | Semtech | 1N4148W | C81598
LED056 | SK6812MINI-E C5149201 | MINI_E | 361.95 | 62.230000000000004 | B | OPSCO Optoelectronics | SK6812MINI-E | C5149201
C156 | 100nF 50V X7R | C_0805 | 367.75 | 62.230000000000004 | B | YAGEO | CC0805KRX7R9BB104 | C49678
SW057 | CPG151101S11-16 | HanElectricity_CPG151101S11-16 | 385.7625 | 57.150000000000006 | B | HanElectricity | CPG151101S11-16 | C41430893 | 7/Home
D057 | 1N4148W | D_SOD123 | 385.7625 | 48.900000000000006 | B | Semtech | 1N4148W | C81598
LED057 | SK6812MINI-E C5149201 | MINI_E | 385.7625 | 62.230000000000004 | B | OPSCO Optoelectronics | SK6812MINI-E | C5149201
C157 | 100nF 50V X7R | C_0805 | 391.5625 | 62.230000000000004 | B | YAGEO | CC0805KRX7R9BB104 | C49678
SW058 | CPG151101S11-16 | HanElectricity_CPG151101S11-16 | 404.8125 | 57.150000000000006 | B | HanElectricity | CPG151101S11-16 | C41430893 | 8/↑
D058 | 1N4148W | D_SOD123 | 404.8125 | 48.900000000000006 | B | Semtech | 1N4148W | C81598
LED058 | SK6812MINI-E C5149201 | MINI_E | 404.8125 | 62.230000000000004 | B | OPSCO Optoelectronics | SK6812MINI-E | C5149201
C158 | 100nF 50V X7R | C_0805 | 410.6125 | 62.230000000000004 | B | YAGEO | CC0805KRX7R9BB104 | C49678
SW059 | CPG151101S11-16 | HanElectricity_CPG151101S11-16 | 423.8625 | 57.150000000000006 | B | HanElectricity | CPG151101S11-16 | C41430893 | 9/PgUp
D059 | 1N4148W | D_SOD123 | 423.8625 | 48.900000000000006 | B | Semtech | 1N4148W | C81598
LED059 | SK6812MINI-E C5149201 | MINI_E | 423.8625 | 62.230000000000004 | B | OPSCO Optoelectronics | SK6812MINI-E | C5149201
C159 | 100nF 50V X7R | C_0805 | 429.6625 | 62.230000000000004 | B | YAGEO | CC0805KRX7R9BB104 | C49678
SW060 | CPG151101S11-16 | HanElectricity_CPG151101S11-16 | 442.9125 | 66.675 | B | HanElectricity | CPG151101S11-16 | C41430893 | +
D060 | 1N4148W | D_SOD123 | 442.9125 | 58.425 | B | Semtech | 1N4148W | C81598
LED060 | SK6812MINI-E C5149201 | MINI_E | 442.9125 | 71.755 | B | OPSCO Optoelectronics | SK6812MINI-E | C5149201
C160 | 100nF 50V X7R | C_0805 | 448.71250000000003 | 71.755 | B | YAGEO | CC0805KRX7R9BB104 | C49678
SW061 | CPG151101S11-16 | HanElectricity_CPG151101S11-16 | 9.525 | 76.2 | B | HanElectricity | CPG151101S11-16 | C41430893 | M3
D061 | 1N4148W | D_SOD123 | 9.525 | 67.95 | B | Semtech | 1N4148W | C81598
LED061 | SK6812MINI-E C5149201 | MINI_E | 9.525 | 81.28 | B | OPSCO Optoelectronics | SK6812MINI-E | C5149201
C161 | 100nF 50V X7R | C_0805 | 15.325 | 81.28 | B | YAGEO | CC0805KRX7R9BB104 | C49678
SW062 | CPG151101S11-16 | HanElectricity_CPG151101S11-16 | 40.48125 | 76.2 | B | HanElectricity | CPG151101S11-16 | C41430893 | Caps Lock
D062 | 1N4148W | D_SOD123 | 40.48125 | 67.95 | B | Semtech | 1N4148W | C81598
LED062 | SK6812MINI-E C5149201 | MINI_E | 40.48125 | 81.28 | B | OPSCO Optoelectronics | SK6812MINI-E | C5149201
C162 | 100nF 50V X7R | C_0805 | 46.28125 | 81.28 | B | YAGEO | CC0805KRX7R9BB104 | C49678
SW063 | CPG151101S11-16 | HanElectricity_CPG151101S11-16 | 66.675 | 76.2 | B | HanElectricity | CPG151101S11-16 | C41430893 | A
D063 | 1N4148W | D_SOD123 | 66.675 | 67.95 | B | Semtech | 1N4148W | C81598
LED063 | SK6812MINI-E C5149201 | MINI_E | 66.675 | 81.28 | B | OPSCO Optoelectronics | SK6812MINI-E | C5149201
C163 | 100nF 50V X7R | C_0805 | 72.475 | 81.28 | B | YAGEO | CC0805KRX7R9BB104 | C49678
SW064 | CPG151101S11-16 | HanElectricity_CPG151101S11-16 | 85.72500000000001 | 76.2 | B | HanElectricity | CPG151101S11-16 | C41430893 | S
D064 | 1N4148W | D_SOD123 | 85.72500000000001 | 67.95 | B | Semtech | 1N4148W | C81598
LED064 | SK6812MINI-E C5149201 | MINI_E | 85.72500000000001 | 81.28 | B | OPSCO Optoelectronics | SK6812MINI-E | C5149201
C164 | 100nF 50V X7R | C_0805 | 91.525 | 81.28 | B | YAGEO | CC0805KRX7R9BB104 | C49678
SW065 | CPG151101S11-16 | HanElectricity_CPG151101S11-16 | 104.775 | 76.2 | B | HanElectricity | CPG151101S11-16 | C41430893 | D
D065 | 1N4148W | D_SOD123 | 104.775 | 67.95 | B | Semtech | 1N4148W | C81598
LED065 | SK6812MINI-E C5149201 | MINI_E | 104.775 | 81.28 | B | OPSCO Optoelectronics | SK6812MINI-E | C5149201
C165 | 100nF 50V X7R | C_0805 | 110.575 | 81.28 | B | YAGEO | CC0805KRX7R9BB104 | C49678
SW066 | CPG151101S11-16 | HanElectricity_CPG151101S11-16 | 123.825 | 76.2 | B | HanElectricity | CPG151101S11-16 | C41430893 | F
D066 | 1N4148W | D_SOD123 | 123.825 | 67.95 | B | Semtech | 1N4148W | C81598
LED066 | SK6812MINI-E C5149201 | MINI_E | 123.825 | 81.28 | B | OPSCO Optoelectronics | SK6812MINI-E | C5149201
C166 | 100nF 50V X7R | C_0805 | 129.625 | 81.28 | B | YAGEO | CC0805KRX7R9BB104 | C49678
SW067 | CPG151101S11-16 | HanElectricity_CPG151101S11-16 | 142.875 | 76.2 | B | HanElectricity | CPG151101S11-16 | C41430893 | G
D067 | 1N4148W | D_SOD123 | 142.875 | 67.95 | B | Semtech | 1N4148W | C81598
LED067 | SK6812MINI-E C5149201 | MINI_E | 142.875 | 81.28 | B | OPSCO Optoelectronics | SK6812MINI-E | C5149201
C167 | 100nF 50V X7R | C_0805 | 148.675 | 81.28 | B | YAGEO | CC0805KRX7R9BB104 | C49678
SW068 | CPG151101S11-16 | HanElectricity_CPG151101S11-16 | 161.925 | 76.2 | B | HanElectricity | CPG151101S11-16 | C41430893 | H
D068 | 1N4148W | D_SOD123 | 161.925 | 67.95 | B | Semtech | 1N4148W | C81598
LED068 | SK6812MINI-E C5149201 | MINI_E | 161.925 | 81.28 | B | OPSCO Optoelectronics | SK6812MINI-E | C5149201
C168 | 100nF 50V X7R | C_0805 | 167.72500000000002 | 81.28 | B | YAGEO | CC0805KRX7R9BB104 | C49678
SW069 | CPG151101S11-16 | HanElectricity_CPG151101S11-16 | 180.975 | 76.2 | B | HanElectricity | CPG151101S11-16 | C41430893 | J
D069 | 1N4148W | D_SOD123 | 180.975 | 67.95 | B | Semtech | 1N4148W | C81598
LED069 | SK6812MINI-E C5149201 | MINI_E | 180.975 | 81.28 | B | OPSCO Optoelectronics | SK6812MINI-E | C5149201
C169 | 100nF 50V X7R | C_0805 | 186.775 | 81.28 | B | YAGEO | CC0805KRX7R9BB104 | C49678
SW070 | CPG151101S11-16 | HanElectricity_CPG151101S11-16 | 200.025 | 76.2 | B | HanElectricity | CPG151101S11-16 | C41430893 | K
D070 | 1N4148W | D_SOD123 | 200.025 | 67.95 | B | Semtech | 1N4148W | C81598
LED070 | SK6812MINI-E C5149201 | MINI_E | 200.025 | 81.28 | B | OPSCO Optoelectronics | SK6812MINI-E | C5149201
C170 | 100nF 50V X7R | C_0805 | 205.82500000000002 | 81.28 | B | YAGEO | CC0805KRX7R9BB104 | C49678
SW071 | CPG151101S11-16 | HanElectricity_CPG151101S11-16 | 219.07500000000002 | 76.2 | B | HanElectricity | CPG151101S11-16 | C41430893 | L
D071 | 1N4148W | D_SOD123 | 219.07500000000002 | 67.95 | B | Semtech | 1N4148W | C81598
LED071 | SK6812MINI-E C5149201 | MINI_E | 219.07500000000002 | 81.28 | B | OPSCO Optoelectronics | SK6812MINI-E | C5149201
C171 | 100nF 50V X7R | C_0805 | 224.87500000000003 | 81.28 | B | YAGEO | CC0805KRX7R9BB104 | C49678
SW072 | CPG151101S11-16 | HanElectricity_CPG151101S11-16 | 238.125 | 76.2 | B | HanElectricity | CPG151101S11-16 | C41430893 | :/;
D072 | 1N4148W | D_SOD123 | 238.125 | 67.95 | B | Semtech | 1N4148W | C81598
LED072 | SK6812MINI-E C5149201 | MINI_E | 238.125 | 81.28 | B | OPSCO Optoelectronics | SK6812MINI-E | C5149201
C172 | 100nF 50V X7R | C_0805 | 243.925 | 81.28 | B | YAGEO | CC0805KRX7R9BB104 | C49678
SW073 | CPG151101S11-16 | HanElectricity_CPG151101S11-16 | 257.175 | 76.2 | B | HanElectricity | CPG151101S11-16 | C41430893 | "/'
D073 | 1N4148W | D_SOD123 | 257.175 | 67.95 | B | Semtech | 1N4148W | C81598
LED073 | SK6812MINI-E C5149201 | MINI_E | 257.175 | 81.28 | B | OPSCO Optoelectronics | SK6812MINI-E | C5149201
C173 | 100nF 50V X7R | C_0805 | 262.975 | 81.28 | B | YAGEO | CC0805KRX7R9BB104 | C49678
SW074 | CPG151101S11-16 | HanElectricity_CPG151101S11-16 | 288.13125 | 76.2 | B | HanElectricity | CPG151101S11-16 | C41430893 | Enter
D074 | 1N4148W | D_SOD123 | 288.13125 | 67.95 | B | Semtech | 1N4148W | C81598
LED074 | SK6812MINI-E C5149201 | MINI_E | 288.13125 | 81.28 | B | OPSCO Optoelectronics | SK6812MINI-E | C5149201
C174 | 100nF 50V X7R | C_0805 | 293.93125000000003 | 81.28 | B | YAGEO | CC0805KRX7R9BB104 | C49678
SW075 | CPG151101S11-16 | HanElectricity_CPG151101S11-16 | 385.7625 | 76.2 | B | HanElectricity | CPG151101S11-16 | C41430893 | 4/←
D075 | 1N4148W | D_SOD123 | 385.7625 | 67.95 | B | Semtech | 1N4148W | C81598
LED075 | SK6812MINI-E C5149201 | MINI_E | 385.7625 | 81.28 | B | OPSCO Optoelectronics | SK6812MINI-E | C5149201
C175 | 100nF 50V X7R | C_0805 | 391.5625 | 81.28 | B | YAGEO | CC0805KRX7R9BB104 | C49678
SW076 | CPG151101S11-16 | HanElectricity_CPG151101S11-16 | 404.8125 | 76.2 | B | HanElectricity | CPG151101S11-16 | C41430893 | 5
D076 | 1N4148W | D_SOD123 | 404.8125 | 67.95 | B | Semtech | 1N4148W | C81598
LED076 | SK6812MINI-E C5149201 | MINI_E | 404.8125 | 81.28 | B | OPSCO Optoelectronics | SK6812MINI-E | C5149201
C176 | 100nF 50V X7R | C_0805 | 410.6125 | 81.28 | B | YAGEO | CC0805KRX7R9BB104 | C49678
SW077 | CPG151101S11-16 | HanElectricity_CPG151101S11-16 | 423.8625 | 76.2 | B | HanElectricity | CPG151101S11-16 | C41430893 | 6/→
D077 | 1N4148W | D_SOD123 | 423.8625 | 67.95 | B | Semtech | 1N4148W | C81598
LED077 | SK6812MINI-E C5149201 | MINI_E | 423.8625 | 81.28 | B | OPSCO Optoelectronics | SK6812MINI-E | C5149201
C177 | 100nF 50V X7R | C_0805 | 429.6625 | 81.28 | B | YAGEO | CC0805KRX7R9BB104 | C49678
SW078 | CPG151101S11-16 | HanElectricity_CPG151101S11-16 | 9.525 | 95.25 | B | HanElectricity | CPG151101S11-16 | C41430893 | M4
D078 | 1N4148W | D_SOD123 | 9.525 | 87.0 | B | Semtech | 1N4148W | C81598
LED078 | SK6812MINI-E C5149201 | MINI_E | 9.525 | 100.33 | B | OPSCO Optoelectronics | SK6812MINI-E | C5149201
C178 | 100nF 50V X7R | C_0805 | 15.325 | 100.33 | B | YAGEO | CC0805KRX7R9BB104 | C49678
SW079 | CPG151101S11-16 | HanElectricity_CPG151101S11-16 | 45.24375 | 95.25 | B | HanElectricity | CPG151101S11-16 | C41430893 | Shift
D079 | 1N4148W | D_SOD123 | 45.24375 | 87.0 | B | Semtech | 1N4148W | C81598
LED079 | SK6812MINI-E C5149201 | MINI_E | 45.24375 | 100.33 | B | OPSCO Optoelectronics | SK6812MINI-E | C5149201
C179 | 100nF 50V X7R | C_0805 | 51.043749999999996 | 100.33 | B | YAGEO | CC0805KRX7R9BB104 | C49678
SW080 | CPG151101S11-16 | HanElectricity_CPG151101S11-16 | 76.2 | 95.25 | B | HanElectricity | CPG151101S11-16 | C41430893 | Z
D080 | 1N4148W | D_SOD123 | 76.2 | 87.0 | B | Semtech | 1N4148W | C81598
LED080 | SK6812MINI-E C5149201 | MINI_E | 76.2 | 100.33 | B | OPSCO Optoelectronics | SK6812MINI-E | C5149201
C180 | 100nF 50V X7R | C_0805 | 82.0 | 100.33 | B | YAGEO | CC0805KRX7R9BB104 | C49678
SW081 | CPG151101S11-16 | HanElectricity_CPG151101S11-16 | 95.25 | 95.25 | B | HanElectricity | CPG151101S11-16 | C41430893 | X
D081 | 1N4148W | D_SOD123 | 95.25 | 87.0 | B | Semtech | 1N4148W | C81598
LED081 | SK6812MINI-E C5149201 | MINI_E | 95.25 | 100.33 | B | OPSCO Optoelectronics | SK6812MINI-E | C5149201
C181 | 100nF 50V X7R | C_0805 | 101.05 | 100.33 | B | YAGEO | CC0805KRX7R9BB104 | C49678
SW082 | CPG151101S11-16 | HanElectricity_CPG151101S11-16 | 114.30000000000001 | 95.25 | B | HanElectricity | CPG151101S11-16 | C41430893 | C
D082 | 1N4148W | D_SOD123 | 114.30000000000001 | 87.0 | B | Semtech | 1N4148W | C81598
LED082 | SK6812MINI-E C5149201 | MINI_E | 114.30000000000001 | 100.33 | B | OPSCO Optoelectronics | SK6812MINI-E | C5149201
C182 | 100nF 50V X7R | C_0805 | 120.10000000000001 | 100.33 | B | YAGEO | CC0805KRX7R9BB104 | C49678
SW083 | CPG151101S11-16 | HanElectricity_CPG151101S11-16 | 133.35 | 95.25 | B | HanElectricity | CPG151101S11-16 | C41430893 | V
D083 | 1N4148W | D_SOD123 | 133.35 | 87.0 | B | Semtech | 1N4148W | C81598
LED083 | SK6812MINI-E C5149201 | MINI_E | 133.35 | 100.33 | B | OPSCO Optoelectronics | SK6812MINI-E | C5149201
C183 | 100nF 50V X7R | C_0805 | 139.15 | 100.33 | B | YAGEO | CC0805KRX7R9BB104 | C49678
SW084 | CPG151101S11-16 | HanElectricity_CPG151101S11-16 | 152.4 | 95.25 | B | HanElectricity | CPG151101S11-16 | C41430893 | B
D084 | 1N4148W | D_SOD123 | 152.4 | 87.0 | B | Semtech | 1N4148W | C81598
LED084 | SK6812MINI-E C5149201 | MINI_E | 152.4 | 100.33 | B | OPSCO Optoelectronics | SK6812MINI-E | C5149201
C184 | 100nF 50V X7R | C_0805 | 158.20000000000002 | 100.33 | B | YAGEO | CC0805KRX7R9BB104 | C49678
SW085 | CPG151101S11-16 | HanElectricity_CPG151101S11-16 | 171.45000000000002 | 95.25 | B | HanElectricity | CPG151101S11-16 | C41430893 | N
D085 | 1N4148W | D_SOD123 | 171.45000000000002 | 87.0 | B | Semtech | 1N4148W | C81598
LED085 | SK6812MINI-E C5149201 | MINI_E | 171.45000000000002 | 100.33 | B | OPSCO Optoelectronics | SK6812MINI-E | C5149201
C185 | 100nF 50V X7R | C_0805 | 177.25000000000003 | 100.33 | B | YAGEO | CC0805KRX7R9BB104 | C49678
SW086 | CPG151101S11-16 | HanElectricity_CPG151101S11-16 | 190.5 | 95.25 | B | HanElectricity | CPG151101S11-16 | C41430893 | M
D086 | 1N4148W | D_SOD123 | 190.5 | 87.0 | B | Semtech | 1N4148W | C81598
LED086 | SK6812MINI-E C5149201 | MINI_E | 190.5 | 100.33 | B | OPSCO Optoelectronics | SK6812MINI-E | C5149201
C186 | 100nF 50V X7R | C_0805 | 196.3 | 100.33 | B | YAGEO | CC0805KRX7R9BB104 | C49678
SW087 | CPG151101S11-16 | HanElectricity_CPG151101S11-16 | 209.55 | 95.25 | B | HanElectricity | CPG151101S11-16 | C41430893 | </,
D087 | 1N4148W | D_SOD123 | 209.55 | 87.0 | B | Semtech | 1N4148W | C81598
LED087 | SK6812MINI-E C5149201 | MINI_E | 209.55 | 100.33 | B | OPSCO Optoelectronics | SK6812MINI-E | C5149201
C187 | 100nF 50V X7R | C_0805 | 215.35000000000002 | 100.33 | B | YAGEO | CC0805KRX7R9BB104 | C49678
SW088 | CPG151101S11-16 | HanElectricity_CPG151101S11-16 | 228.60000000000002 | 95.25 | B | HanElectricity | CPG151101S11-16 | C41430893 | >/.
D088 | 1N4148W | D_SOD123 | 228.60000000000002 | 87.0 | B | Semtech | 1N4148W | C81598
LED088 | SK6812MINI-E C5149201 | MINI_E | 228.60000000000002 | 100.33 | B | OPSCO Optoelectronics | SK6812MINI-E | C5149201
C188 | 100nF 50V X7R | C_0805 | 234.40000000000003 | 100.33 | B | YAGEO | CC0805KRX7R9BB104 | C49678
SW089 | CPG151101S11-16 | HanElectricity_CPG151101S11-16 | 247.65 | 95.25 | B | HanElectricity | CPG151101S11-16 | C41430893 | ?//
D089 | 1N4148W | D_SOD123 | 247.65 | 87.0 | B | Semtech | 1N4148W | C81598
LED089 | SK6812MINI-E C5149201 | MINI_E | 247.65 | 100.33 | B | OPSCO Optoelectronics | SK6812MINI-E | C5149201
C189 | 100nF 50V X7R | C_0805 | 253.45000000000002 | 100.33 | B | YAGEO | CC0805KRX7R9BB104 | C49678
SW090 | CPG151101S11-16 | HanElectricity_CPG151101S11-16 | 283.36875000000003 | 95.25 | B | HanElectricity | CPG151101S11-16 | C41430893 | Shift
D090 | 1N4148W | D_SOD123 | 283.36875000000003 | 87.0 | B | Semtech | 1N4148W | C81598
LED090 | SK6812MINI-E C5149201 | MINI_E | 283.36875000000003 | 100.33 | B | OPSCO Optoelectronics | SK6812MINI-E | C5149201
C190 | 100nF 50V X7R | C_0805 | 289.16875000000005 | 100.33 | B | YAGEO | CC0805KRX7R9BB104 | C49678
SW091 | CPG151101S11-16 | HanElectricity_CPG151101S11-16 | 323.85 | 95.25 | B | HanElectricity | CPG151101S11-16 | C41430893 | M12
D091 | 1N4148W | D_SOD123 | 323.85 | 87.0 | B | Semtech | 1N4148W | C81598
LED091 | SK6812MINI-E C5149201 | MINI_E | 323.85 | 100.33 | B | OPSCO Optoelectronics | SK6812MINI-E | C5149201
C191 | 100nF 50V X7R | C_0805 | 329.65000000000003 | 100.33 | B | YAGEO | CC0805KRX7R9BB104 | C49678
SW092 | CPG151101S11-16 | HanElectricity_CPG151101S11-16 | 342.90000000000003 | 95.25 | B | HanElectricity | CPG151101S11-16 | C41430893 | ↑
D092 | 1N4148W | D_SOD123 | 342.90000000000003 | 87.0 | B | Semtech | 1N4148W | C81598
LED092 | SK6812MINI-E C5149201 | MINI_E | 342.90000000000003 | 100.33 | B | OPSCO Optoelectronics | SK6812MINI-E | C5149201
C192 | 100nF 50V X7R | C_0805 | 348.70000000000005 | 100.33 | B | YAGEO | CC0805KRX7R9BB104 | C49678
SW093 | CPG151101S11-16 | HanElectricity_CPG151101S11-16 | 361.95 | 95.25 | B | HanElectricity | CPG151101S11-16 | C41430893 | M13
D093 | 1N4148W | D_SOD123 | 361.95 | 87.0 | B | Semtech | 1N4148W | C81598
LED093 | SK6812MINI-E C5149201 | MINI_E | 361.95 | 100.33 | B | OPSCO Optoelectronics | SK6812MINI-E | C5149201
C193 | 100nF 50V X7R | C_0805 | 367.75 | 100.33 | B | YAGEO | CC0805KRX7R9BB104 | C49678
SW094 | CPG151101S11-16 | HanElectricity_CPG151101S11-16 | 385.7625 | 95.25 | B | HanElectricity | CPG151101S11-16 | C41430893 | 1/End
D094 | 1N4148W | D_SOD123 | 385.7625 | 87.0 | B | Semtech | 1N4148W | C81598
LED094 | SK6812MINI-E C5149201 | MINI_E | 385.7625 | 100.33 | B | OPSCO Optoelectronics | SK6812MINI-E | C5149201
C194 | 100nF 50V X7R | C_0805 | 391.5625 | 100.33 | B | YAGEO | CC0805KRX7R9BB104 | C49678
SW095 | CPG151101S11-16 | HanElectricity_CPG151101S11-16 | 404.8125 | 95.25 | B | HanElectricity | CPG151101S11-16 | C41430893 | 2/↓
D095 | 1N4148W | D_SOD123 | 404.8125 | 87.0 | B | Semtech | 1N4148W | C81598
LED095 | SK6812MINI-E C5149201 | MINI_E | 404.8125 | 100.33 | B | OPSCO Optoelectronics | SK6812MINI-E | C5149201
C195 | 100nF 50V X7R | C_0805 | 410.6125 | 100.33 | B | YAGEO | CC0805KRX7R9BB104 | C49678
SW096 | CPG151101S11-16 | HanElectricity_CPG151101S11-16 | 423.8625 | 95.25 | B | HanElectricity | CPG151101S11-16 | C41430893 | 3/PgDn
D096 | 1N4148W | D_SOD123 | 423.8625 | 87.0 | B | Semtech | 1N4148W | C81598
LED096 | SK6812MINI-E C5149201 | MINI_E | 423.8625 | 100.33 | B | OPSCO Optoelectronics | SK6812MINI-E | C5149201
C196 | 100nF 50V X7R | C_0805 | 429.6625 | 100.33 | B | YAGEO | CC0805KRX7R9BB104 | C49678
SW097 | CPG151101S11-16 | HanElectricity_CPG151101S11-16 | 442.9125 | 104.775 | B | HanElectricity | CPG151101S11-16 | C41430893 | Enter
D097 | 1N4148W | D_SOD123 | 442.9125 | 96.525 | B | Semtech | 1N4148W | C81598
LED097 | SK6812MINI-E C5149201 | MINI_E | 442.9125 | 109.855 | B | OPSCO Optoelectronics | SK6812MINI-E | C5149201
C197 | 100nF 50V X7R | C_0805 | 448.71250000000003 | 109.855 | B | YAGEO | CC0805KRX7R9BB104 | C49678
SW098 | CPG151101S11-16 | HanElectricity_CPG151101S11-16 | 9.525 | 114.30000000000001 | B | HanElectricity | CPG151101S11-16 | C41430893 | M5
D098 | 1N4148W | D_SOD123 | 9.525 | 106.05000000000001 | B | Semtech | 1N4148W | C81598
LED098 | SK6812MINI-E C5149201 | MINI_E | 9.525 | 119.38000000000001 | B | OPSCO Optoelectronics | SK6812MINI-E | C5149201
C198 | 100nF 50V X7R | C_0805 | 15.325 | 119.38000000000001 | B | YAGEO | CC0805KRX7R9BB104 | C49678
SW099 | CPG151101S11-16 | HanElectricity_CPG151101S11-16 | 35.71875 | 114.30000000000001 | B | HanElectricity | CPG151101S11-16 | C41430893 | Ctrl
D099 | 1N4148W | D_SOD123 | 35.71875 | 106.05000000000001 | B | Semtech | 1N4148W | C81598
LED099 | SK6812MINI-E C5149201 | MINI_E | 35.71875 | 119.38000000000001 | B | OPSCO Optoelectronics | SK6812MINI-E | C5149201
C199 | 100nF 50V X7R | C_0805 | 41.51875 | 119.38000000000001 | B | YAGEO | CC0805KRX7R9BB104 | C49678
SW100 | CPG151101S11-16 | HanElectricity_CPG151101S11-16 | 59.53125 | 114.30000000000001 | B | HanElectricity | CPG151101S11-16 | C41430893 | Win
D100 | 1N4148W | D_SOD123 | 59.53125 | 106.05000000000001 | B | Semtech | 1N4148W | C81598
LED100 | SK6812MINI-E C5149201 | MINI_E | 59.53125 | 119.38000000000001 | B | OPSCO Optoelectronics | SK6812MINI-E | C5149201
C200 | 100nF 50V X7R | C_0805 | 65.33125 | 119.38000000000001 | B | YAGEO | CC0805KRX7R9BB104 | C49678
SW101 | CPG151101S11-16 | HanElectricity_CPG151101S11-16 | 83.34375 | 114.30000000000001 | B | HanElectricity | CPG151101S11-16 | C41430893 | Alt
D101 | 1N4148W | D_SOD123 | 83.34375 | 106.05000000000001 | B | Semtech | 1N4148W | C81598
LED101 | SK6812MINI-E C5149201 | MINI_E | 83.34375 | 119.38000000000001 | B | OPSCO Optoelectronics | SK6812MINI-E | C5149201
C201 | 100nF 50V X7R | C_0805 | 89.14375 | 119.38000000000001 | B | YAGEO | CC0805KRX7R9BB104 | C49678
SW102 | CPG151101S11-16 | HanElectricity_CPG151101S11-16 | 154.78125 | 114.30000000000001 | B | HanElectricity | CPG151101S11-16 | C41430893 | Space
D102 | 1N4148W | D_SOD123 | 154.78125 | 106.05000000000001 | B | Semtech | 1N4148W | C81598
LED102 | SK6812MINI-E C5149201 | MINI_E | 154.78125 | 119.38000000000001 | B | OPSCO Optoelectronics | SK6812MINI-E | C5149201
C202 | 100nF 50V X7R | C_0805 | 160.58125 | 119.38000000000001 | B | YAGEO | CC0805KRX7R9BB104 | C49678
SW103 | CPG151101S11-16 | HanElectricity_CPG151101S11-16 | 226.21875 | 114.30000000000001 | B | HanElectricity | CPG151101S11-16 | C41430893 | Alt
D103 | 1N4148W | D_SOD123 | 226.21875 | 106.05000000000001 | B | Semtech | 1N4148W | C81598
LED103 | SK6812MINI-E C5149201 | MINI_E | 226.21875 | 119.38000000000001 | B | OPSCO Optoelectronics | SK6812MINI-E | C5149201
C203 | 100nF 50V X7R | C_0805 | 232.01875 | 119.38000000000001 | B | YAGEO | CC0805KRX7R9BB104 | C49678
SW104 | CPG151101S11-16 | HanElectricity_CPG151101S11-16 | 250.03125 | 114.30000000000001 | B | HanElectricity | CPG151101S11-16 | C41430893 | Win
D104 | 1N4148W | D_SOD123 | 250.03125 | 106.05000000000001 | B | Semtech | 1N4148W | C81598
LED104 | SK6812MINI-E C5149201 | MINI_E | 250.03125 | 119.38000000000001 | B | OPSCO Optoelectronics | SK6812MINI-E | C5149201
C204 | 100nF 50V X7R | C_0805 | 255.83125 | 119.38000000000001 | B | YAGEO | CC0805KRX7R9BB104 | C49678
SW105 | CPG151101S11-16 | HanElectricity_CPG151101S11-16 | 273.84375 | 114.30000000000001 | B | HanElectricity | CPG151101S11-16 | C41430893 | Menu
D105 | 1N4148W | D_SOD123 | 273.84375 | 106.05000000000001 | B | Semtech | 1N4148W | C81598
LED105 | SK6812MINI-E C5149201 | MINI_E | 273.84375 | 119.38000000000001 | B | OPSCO Optoelectronics | SK6812MINI-E | C5149201
C205 | 100nF 50V X7R | C_0805 | 279.64375 | 119.38000000000001 | B | YAGEO | CC0805KRX7R9BB104 | C49678
SW106 | CPG151101S11-16 | HanElectricity_CPG151101S11-16 | 297.65625 | 114.30000000000001 | B | HanElectricity | CPG151101S11-16 | C41430893 | Ctrl
D106 | 1N4148W | D_SOD123 | 297.65625 | 106.05000000000001 | B | Semtech | 1N4148W | C81598
LED106 | SK6812MINI-E C5149201 | MINI_E | 297.65625 | 119.38000000000001 | B | OPSCO Optoelectronics | SK6812MINI-E | C5149201
C206 | 100nF 50V X7R | C_0805 | 303.45625 | 119.38000000000001 | B | YAGEO | CC0805KRX7R9BB104 | C49678
SW107 | CPG151101S11-16 | HanElectricity_CPG151101S11-16 | 323.85 | 114.30000000000001 | B | HanElectricity | CPG151101S11-16 | C41430893 | ←
D107 | 1N4148W | D_SOD123 | 323.85 | 106.05000000000001 | B | Semtech | 1N4148W | C81598
LED107 | SK6812MINI-E C5149201 | MINI_E | 323.85 | 119.38000000000001 | B | OPSCO Optoelectronics | SK6812MINI-E | C5149201
C207 | 100nF 50V X7R | C_0805 | 329.65000000000003 | 119.38000000000001 | B | YAGEO | CC0805KRX7R9BB104 | C49678
SW108 | CPG151101S11-16 | HanElectricity_CPG151101S11-16 | 342.90000000000003 | 114.30000000000001 | B | HanElectricity | CPG151101S11-16 | C41430893 | ↓
D108 | 1N4148W | D_SOD123 | 342.90000000000003 | 106.05000000000001 | B | Semtech | 1N4148W | C81598
LED108 | SK6812MINI-E C5149201 | MINI_E | 342.90000000000003 | 119.38000000000001 | B | OPSCO Optoelectronics | SK6812MINI-E | C5149201
C208 | 100nF 50V X7R | C_0805 | 348.70000000000005 | 119.38000000000001 | B | YAGEO | CC0805KRX7R9BB104 | C49678
SW109 | CPG151101S11-16 | HanElectricity_CPG151101S11-16 | 361.95 | 114.30000000000001 | B | HanElectricity | CPG151101S11-16 | C41430893 | →
D109 | 1N4148W | D_SOD123 | 361.95 | 106.05000000000001 | B | Semtech | 1N4148W | C81598
LED109 | SK6812MINI-E C5149201 | MINI_E | 361.95 | 119.38000000000001 | B | OPSCO Optoelectronics | SK6812MINI-E | C5149201
C209 | 100nF 50V X7R | C_0805 | 367.75 | 119.38000000000001 | B | YAGEO | CC0805KRX7R9BB104 | C49678
SW110 | CPG151101S11-16 | HanElectricity_CPG151101S11-16 | 395.2875 | 114.30000000000001 | B | HanElectricity | CPG151101S11-16 | C41430893 | 0/Ins
D110 | 1N4148W | D_SOD123 | 395.2875 | 106.05000000000001 | B | Semtech | 1N4148W | C81598
LED110 | SK6812MINI-E C5149201 | MINI_E | 395.2875 | 119.38000000000001 | B | OPSCO Optoelectronics | SK6812MINI-E | C5149201
C210 | 100nF 50V X7R | C_0805 | 401.08750000000003 | 119.38000000000001 | B | YAGEO | CC0805KRX7R9BB104 | C49678
SW111 | CPG151101S11-16 | HanElectricity_CPG151101S11-16 | 423.8625 | 114.30000000000001 | B | HanElectricity | CPG151101S11-16 | C41430893 | ./Del
D111 | 1N4148W | D_SOD123 | 423.8625 | 106.05000000000001 | B | Semtech | 1N4148W | C81598
LED111 | SK6812MINI-E C5149201 | MINI_E | 423.8625 | 119.38000000000001 | B | OPSCO Optoelectronics | SK6812MINI-E | C5149201
C211 | 100nF 50V X7R | C_0805 | 429.6625 | 119.38000000000001 | B | YAGEO | CC0805KRX7R9BB104 | C49678
SW112 | CPG151101S11-16 | HanElectricity_CPG151101S11-16 | 135.255 | 138.1125 | B | HanElectricity | CPG151101S11-16 | C41430893 | M6
D112 | 1N4148W | D_SOD123 | 135.255 | 129.8625 | B | Semtech | 1N4148W | C81598
LED112 | SK6812MINI-E C5149201 | MINI_E | 135.255 | 143.19250000000002 | B | OPSCO Optoelectronics | SK6812MINI-E | C5149201
C212 | 100nF 50V X7R | C_0805 | 141.055 | 143.19250000000002 | B | YAGEO | CC0805KRX7R9BB104 | C49678
SW113 | CPG151101S11-16 | HanElectricity_CPG151101S11-16 | 154.305 | 138.1125 | B | HanElectricity | CPG151101S11-16 | C41430893 | M7
D113 | 1N4148W | D_SOD123 | 154.305 | 129.8625 | B | Semtech | 1N4148W | C81598
LED113 | SK6812MINI-E C5149201 | MINI_E | 154.305 | 143.19250000000002 | B | OPSCO Optoelectronics | SK6812MINI-E | C5149201
C213 | 100nF 50V X7R | C_0805 | 160.10500000000002 | 143.19250000000002 | B | YAGEO | CC0805KRX7R9BB104 | C49678
SW114 | CPG151101S11-16 | HanElectricity_CPG151101S11-16 | 173.355 | 138.1125 | B | HanElectricity | CPG151101S11-16 | C41430893 | M8
D114 | 1N4148W | D_SOD123 | 173.355 | 129.8625 | B | Semtech | 1N4148W | C81598
LED114 | SK6812MINI-E C5149201 | MINI_E | 173.355 | 143.19250000000002 | B | OPSCO Optoelectronics | SK6812MINI-E | C5149201
C214 | 100nF 50V X7R | C_0805 | 179.155 | 143.19250000000002 | B | YAGEO | CC0805KRX7R9BB104 | C49678
SW115 | CPG151101S11-16 | HanElectricity_CPG151101S11-16 | 281.94 | 138.1125 | B | HanElectricity | CPG151101S11-16 | C41430893 | M9
D115 | 1N4148W | D_SOD123 | 281.94 | 129.8625 | B | Semtech | 1N4148W | C81598
LED115 | SK6812MINI-E C5149201 | MINI_E | 281.94 | 143.19250000000002 | B | OPSCO Optoelectronics | SK6812MINI-E | C5149201
C215 | 100nF 50V X7R | C_0805 | 287.74 | 143.19250000000002 | B | YAGEO | CC0805KRX7R9BB104 | C49678
SW116 | CPG151101S11-16 | HanElectricity_CPG151101S11-16 | 300.99 | 138.1125 | B | HanElectricity | CPG151101S11-16 | C41430893 | M10
D116 | 1N4148W | D_SOD123 | 300.99 | 129.8625 | B | Semtech | 1N4148W | C81598
LED116 | SK6812MINI-E C5149201 | MINI_E | 300.99 | 143.19250000000002 | B | OPSCO Optoelectronics | SK6812MINI-E | C5149201
C216 | 100nF 50V X7R | C_0805 | 306.79 | 143.19250000000002 | B | YAGEO | CC0805KRX7R9BB104 | C49678
SW117 | CPG151101S11-16 | HanElectricity_CPG151101S11-16 | 320.04 | 138.1125 | B | HanElectricity | CPG151101S11-16 | C41430893 | M11
D117 | 1N4148W | D_SOD123 | 320.04 | 129.8625 | B | Semtech | 1N4148W | C81598
LED117 | SK6812MINI-E C5149201 | MINI_E | 320.04 | 143.19250000000002 | B | OPSCO Optoelectronics | SK6812MINI-E | C5149201
C217 | 100nF 50V X7R | C_0805 | 325.84000000000003 | 143.19250000000002 | B | YAGEO | CC0805KRX7R9BB104 | C49678
LED118 | SK6812MINI-E C5149201 | MINI_E | 208.1475 | 140.6125 | B | OPSCO Optoelectronics | SK6812MINI-E | C5149201
C218 | 100nF 50V X7R | C_0805 | 208.1475 | 135.6125 | B | YAGEO | CC0805KRX7R9BB104 | C49678
LED119 | SK6812MINI-E C5149201 | MINI_E | 221.1475 | 140.6125 | B | OPSCO Optoelectronics | SK6812MINI-E | C5149201
C219 | 100nF 50V X7R | C_0805 | 221.1475 | 135.6125 | B | YAGEO | CC0805KRX7R9BB104 | C49678
LED120 | SK6812MINI-E C5149201 | MINI_E | 234.1475 | 140.6125 | B | OPSCO Optoelectronics | SK6812MINI-E | C5149201
C220 | 100nF 50V X7R | C_0805 | 234.1475 | 135.6125 | B | YAGEO | CC0805KRX7R9BB104 | C49678
LED121 | SK6812MINI-E C5149201 | MINI_E | 247.1475 | 140.6125 | B | OPSCO Optoelectronics | SK6812MINI-E | C5149201
C221 | 100nF 50V X7R | C_0805 | 247.1475 | 135.6125 | B | YAGEO | CC0805KRX7R9BB104 | C49678
TP1 | USB VBUS TEST +5V | WirePad | 446 | 27 | B
F1 | 1206L050YR 0.50A hold | PTC_1206 | 393 | 4.5 | B | Littelfuse | 1206L050YR | C163512
U3 | TPS2553DBVR | TPS2553 | 390 | 14 | B | Texas Instruments | TPS2553DBVR | C55266
U2 | SN74LV1T125DBVR | LV1T125 | 382 | 19 | B | Texas Instruments | SN74LV1T125DBVR | C473338
R1 | 330R | R_0805 | 375 | 21 | B | UNI-ROYAL | 0805W8F3300T5E | C17630
R2 | 100k | R_0805 | 384 | 10 | B | UNI-ROYAL | 0805W8F1003T5E | C149504
R3 | 100k | R_0805 | 377 | 25 | B | UNI-ROYAL | 0805W8F1003T5E | C149504
C1 | 1uF 50V X7R | C_0805 | 394 | 8 | B | Samsung Electro-Mechanics | CL21B105KBFNNNE | C28323
C2 | 22uF 10V X5R | C_0805 | 395 | 14 | B | Samsung Electro-Mechanics | CL21A226MPQNNNE | C29277
C3 | 100nF 50V X7R | C_0805 | 386 | 23 | B | YAGEO | CC0805KRX7R9BB104 | C49678
R4 | 75k 1% | R_0805 | 393 | 17 | B | UNI-ROYAL | 0805W8F7502T5E | C17819
C5 | 470uF 10V PCF1A471MCL1GS | C_PCF_D10 | 377 | 6 | B | Nichicon | PCF1A471MCL1GS | C3275369
TP2 | GND | TestPad | 410 | 27 | B
TP3 | RAW_USB_5V | TestPad | 418 | 27 | B
TP4 | LED_5V | TestPad | 426 | 27 | B
TP5 | LED_EN | TestPad | 434 | 27 | B
TP6 | RGB_BUFFERED | TestPad | 402 | 27 | B
