68mschmitt/cleavboard/designs/module-rp2040/mechanical/rev0.9/case/Cleaver-case-assembly-rev0.9.step

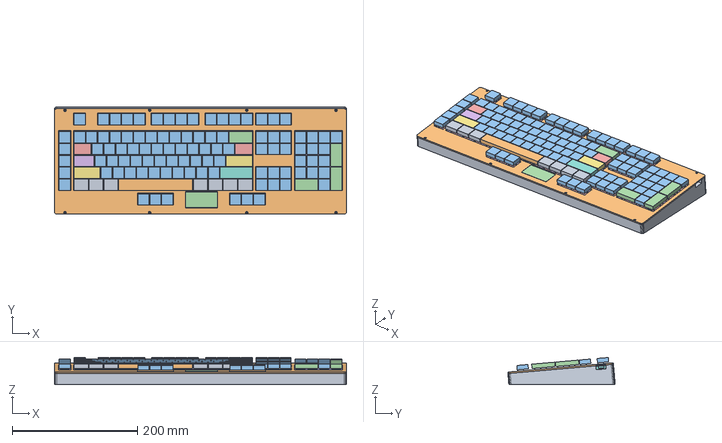
[picture p29: CAD file, 2026-11-13]
designs/module-rp2040/mechanical/rev0.9/case/Cleaver-case-assembly-rev0.9.step
465.9 x 171.5 x 43.1 mm
