68mschmitt/cleavboard/assets/layout/original-plate.dxf

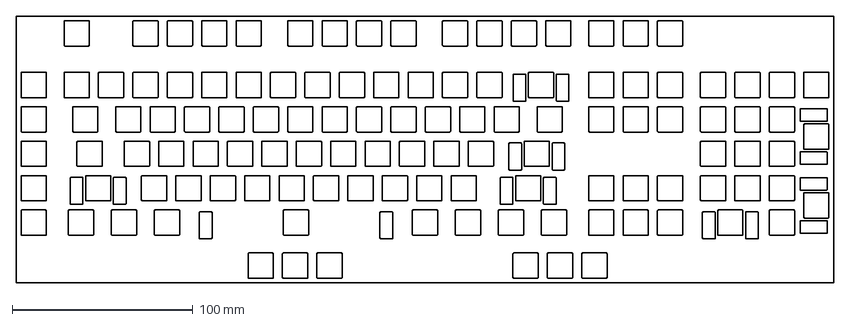
[picture p30: CAD file, 2026-11-08]
assets/layout/original-plate.dxf
452.4 x 147.6 mm
