68mschmitt/cleavboard/designs/module-rp2040/mechanical/Cleaver.stl

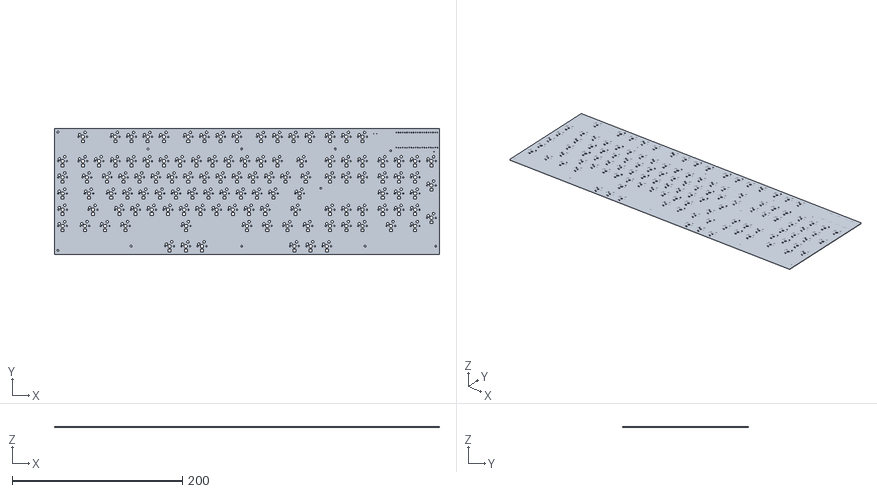
[picture p31: CAD file, 2026-11-09]
designs/module-rp2040/mechanical/Cleaver.stl
452.4 x 147.6 x 1.51
