68mschmitt/cleavboard/designs/module-rp2040/mechanical/pcb-fit-model/Cleaver-PCB-4-right.stl

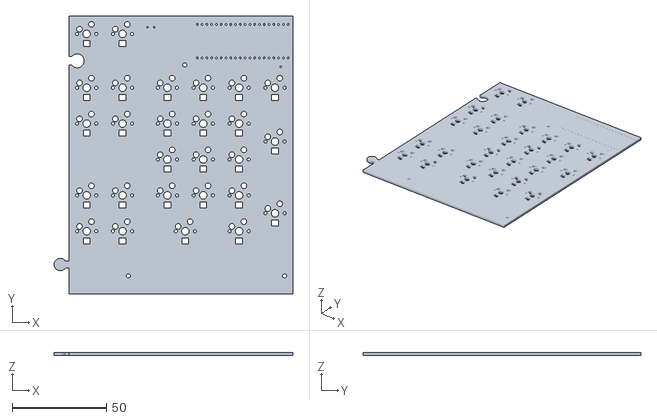
[picture p32: CAD file, 2026-11-09]
designs/module-rp2040/mechanical/pcb-fit-model/Cleaver-PCB-4-right.stl
126.9 x 147.6 x 1.60
