68mschmitt/cleavboard/designs/module-rp2040/mechanical/rev0.9/case/controller-socket-shim-0.4mm.step

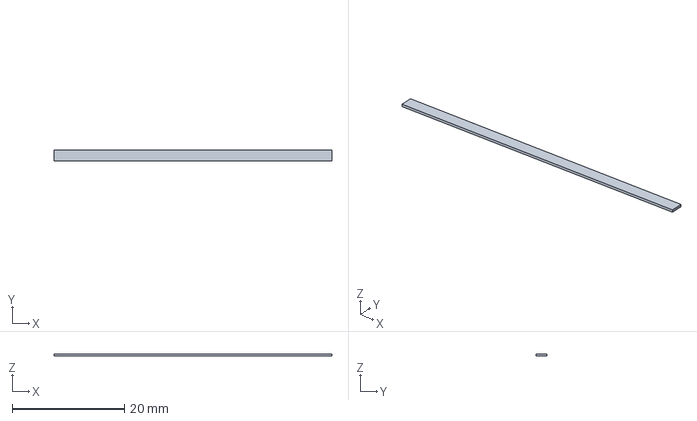
[picture p33: CAD file, 2026-11-13]
designs/module-rp2040/mechanical/rev0.9/case/controller-socket-shim-0.4mm.step
49.6 x 2.00 x 0.4 mm
