68mschmitt/cleavboard/designs/module-rp2040/mechanical/rev0.9/Cleaver-top-plate-rev0.9.stl

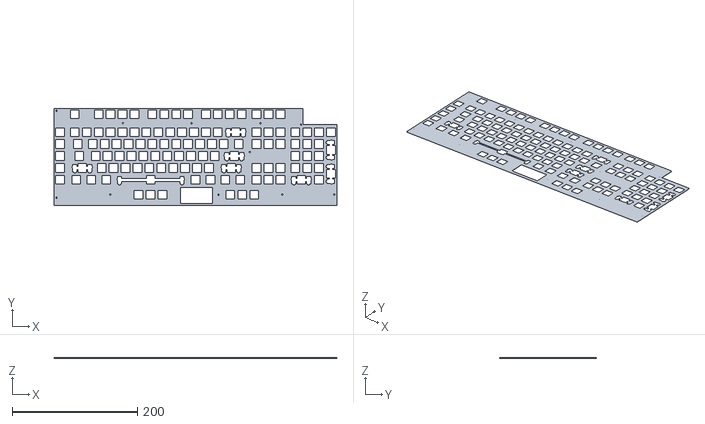
[picture p34: CAD file, 2026-11-13]
designs/module-rp2040/mechanical/rev0.9/Cleaver-top-plate-rev0.9.stl
452.4 x 155.6 x 1.50
