68mschmitt/cleavboard/designs/module-rp2040/mechanical/pcb-fit-model/Cleaver-PCB-3-middle-right.stl

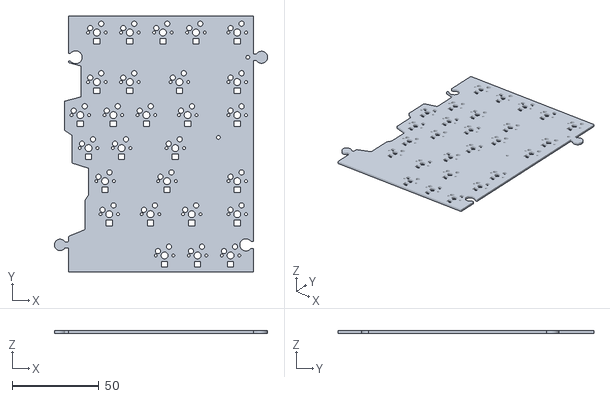
[picture p35: CAD file, 2026-11-09]
designs/module-rp2040/mechanical/pcb-fit-model/Cleaver-PCB-3-middle-right.stl
123.0 x 147.6 x 1.60
