68mschmitt/cleavboard/designs/module-rp2040/mechanical/rev0.9/case/controller-socket-shim-0.8mm.step

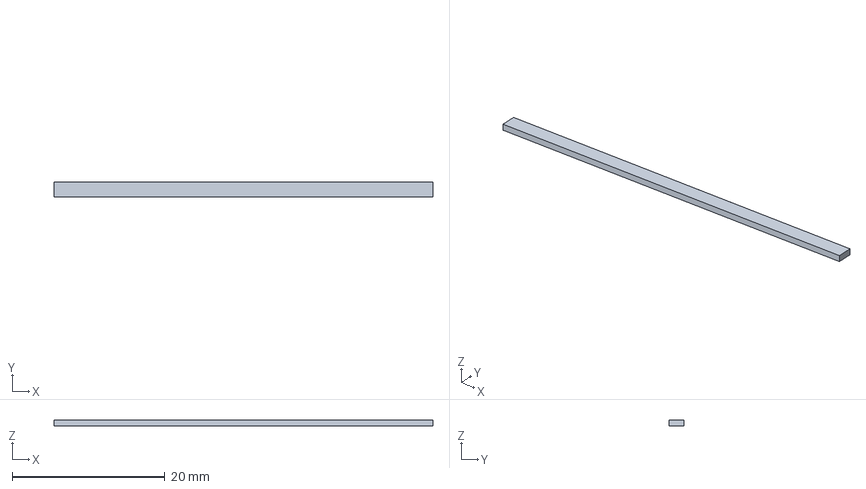
[picture p36: CAD file, 2026-11-13]
designs/module-rp2040/mechanical/rev0.9/case/controller-socket-shim-0.8mm.step
49.6 x 2.00 x 0.8 mm
