68mschmitt/cleavboard/designs/module-rp2040/mechanical/rev0.9/stabilizer-fit-coupon-2u.stl

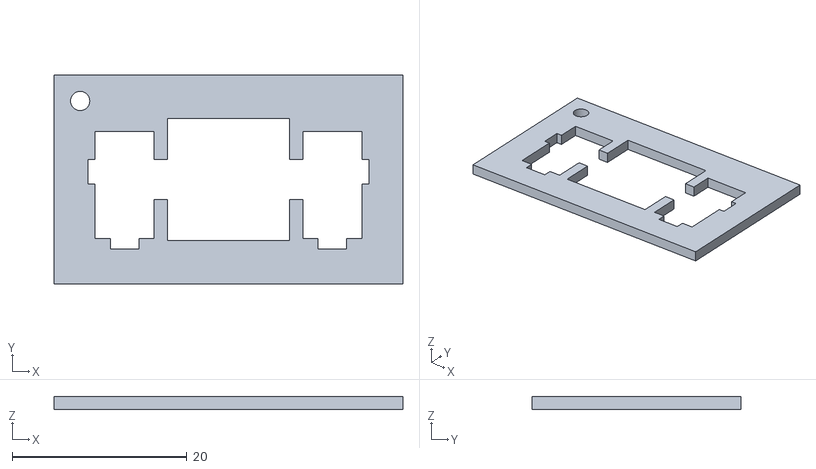
[picture p37: CAD file, 2026-11-12]
designs/module-rp2040/mechanical/rev0.9/stabilizer-fit-coupon-2u.stl
40.0 x 24.0 x 1.50
