68mschmitt/cleavboard/designs/module-rp2040/mechanical/stabilizer-fit-coupon.dxf

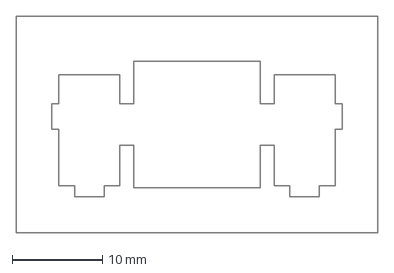
[picture p38: CAD file, 2026-11-09]
designs/module-rp2040/mechanical/stabilizer-fit-coupon.dxf
40.0 x 24.0 mm
