68mschmitt/cleavboard/designs/module-rp2040/mechanical/Cleaver-plate.dxf

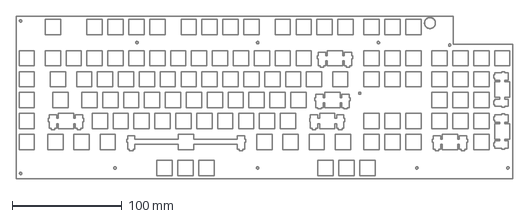
[picture p39: CAD file, 2026-11-09]
designs/module-rp2040/mechanical/Cleaver-plate.dxf
452.4 x 147.6 mm
