68mschmitt/cleavboard/designs/module-rp2040/mechanical/rev0.9/case/controller-socket-shim-1.0mm.step

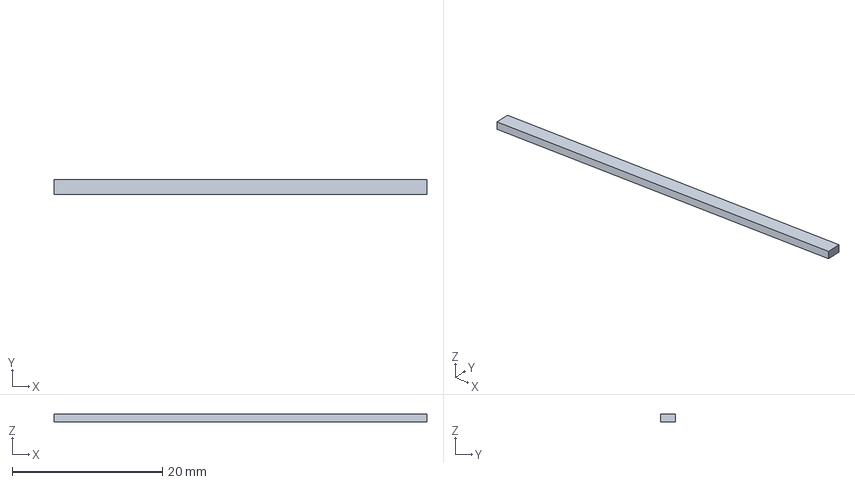
[picture p40: CAD file, 2026-11-13]
designs/module-rp2040/mechanical/rev0.9/case/controller-socket-shim-1.0mm.step
49.6 x 2.00 x 1.00 mm
