68mschmitt/cleavboard/designs/module-rp2040/mechanical/rev0.9/stabilizer-fit-coupon-6.25u.stl

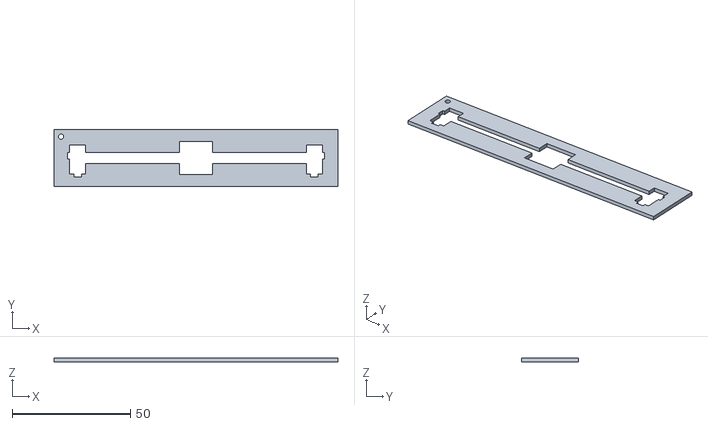
[picture p41: CAD file, 2026-11-12]
designs/module-rp2040/mechanical/rev0.9/stabilizer-fit-coupon-6.25u.stl
120.0 x 24.0 x 1.50
