68mschmitt/cleavboard/designs/module-rp2040/mechanical/pcb-fit-model/Cleaver-PCB-2-middle-left.stl

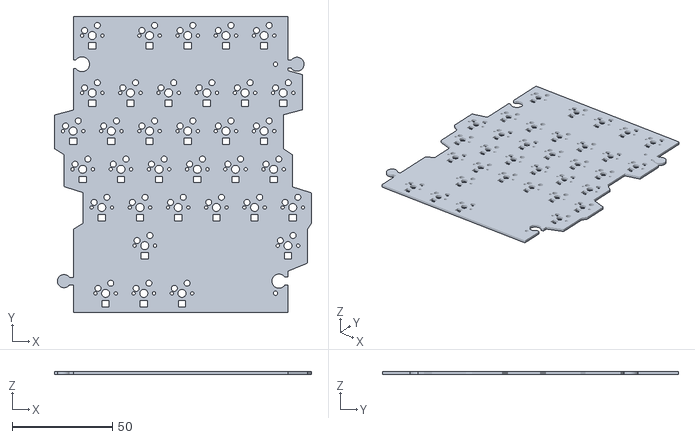
[picture p42: CAD file, 2026-11-09]
designs/module-rp2040/mechanical/pcb-fit-model/Cleaver-PCB-2-middle-left.stl
128.3 x 147.6 x 1.60
