68mschmitt/cleavboard/designs/module-rp2040/mechanical/rev0.9/case/PCB-to-plate-spacer-3.5mm.step

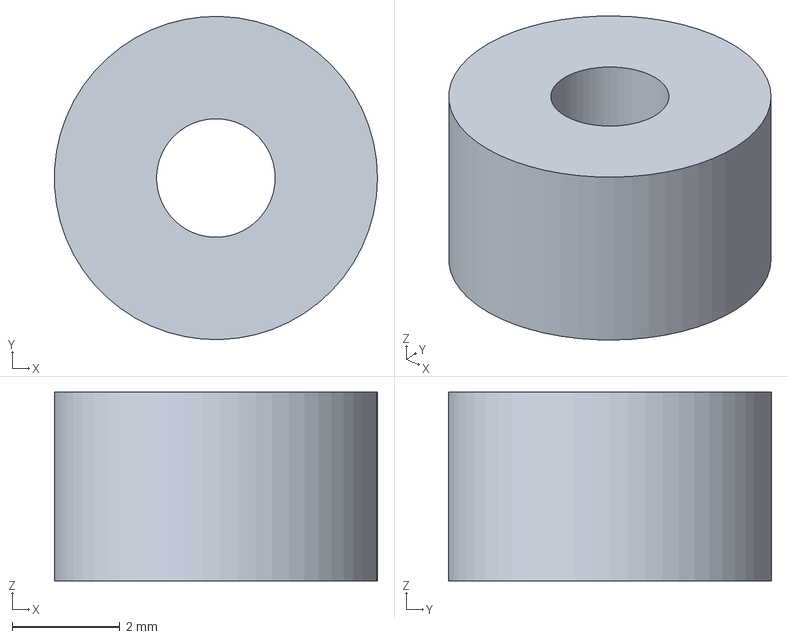
[picture p43: CAD file, 2026-11-13]
designs/module-rp2040/mechanical/rev0.9/case/PCB-to-plate-spacer-3.5mm.step
6.00 x 6.00 x 3.50 mm
