68mschmitt/cleavboard/designs/module-rp2040/mechanical/rev0.9/case/controller-socket-shim-0.6mm.step

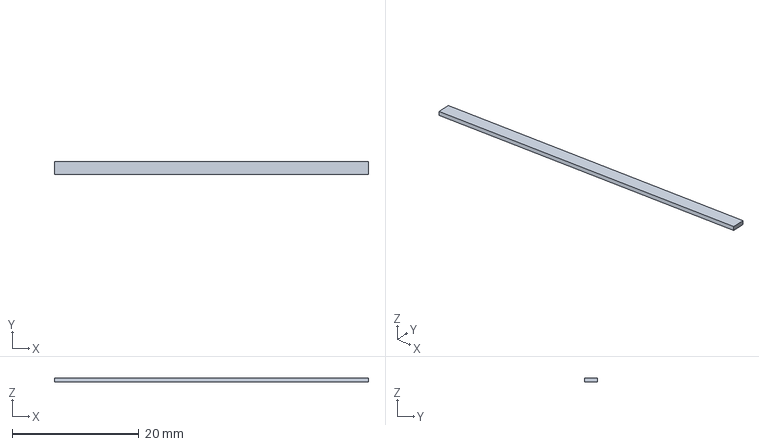
[picture p44: CAD file, 2026-11-13]
designs/module-rp2040/mechanical/rev0.9/case/controller-socket-shim-0.6mm.step
49.6 x 2.00 x 0.6 mm
