68mschmitt/cleavboard/designs/module-rp2040/mechanical/rev0.9/case/Logo-light-well.step

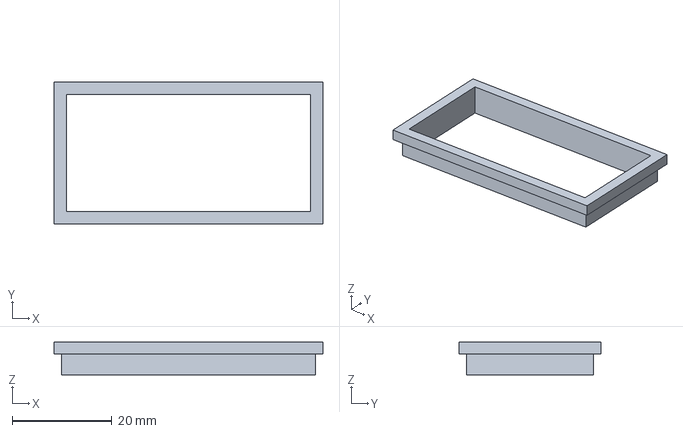
[picture p45: CAD file, 2026-11-13]
designs/module-rp2040/mechanical/rev0.9/case/Logo-light-well.step
53.8 x 28.4 x 6.60 mm
