68mschmitt/cleavboard/designs/module-rp2040/mechanical/rev0.9/case/Cleaver-case-top-cover-rev0.9.step

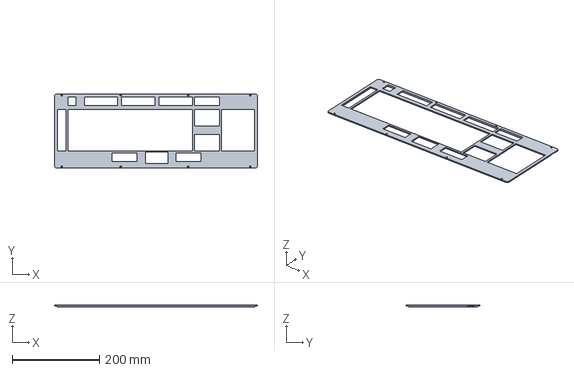
[picture p46: CAD file, 2026-11-13]
designs/module-rp2040/mechanical/rev0.9/case/Cleaver-case-top-cover-rev0.9.step
465.9 x 169.1 x 4.40 mm
