68mschmitt/cleavboard/designs/module-rp2040/mechanical/rev0.9/case/USB-and-seat-fit-coupon-base.step

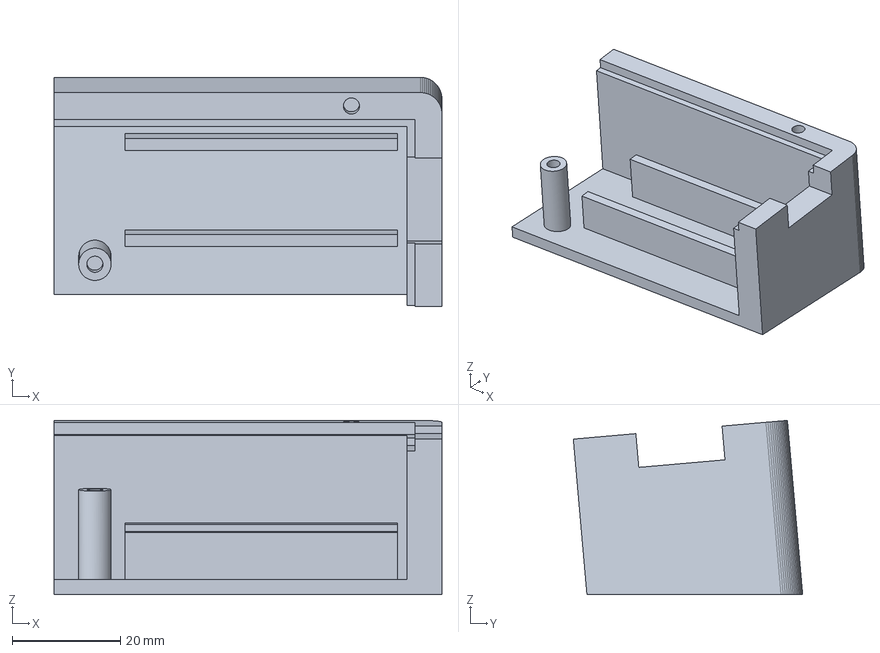
[picture p47: CAD file, 2026-11-13]
designs/module-rp2040/mechanical/rev0.9/case/USB-and-seat-fit-coupon-base.step
71.8 x 42.4 x 32.2 mm
