68mschmitt/cleavboard/designs/module-rp2040/mechanical/rev0.9/case/Logo-insert-blank.step

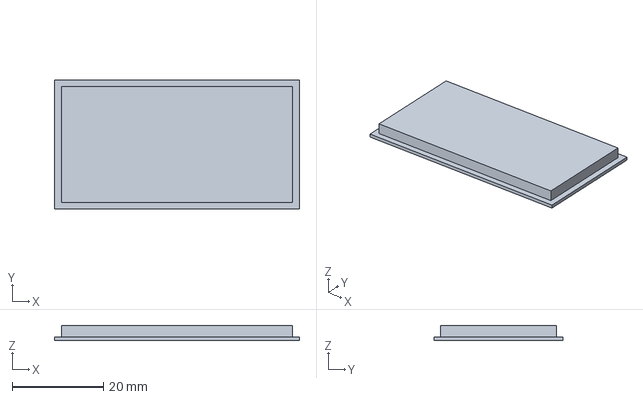
[picture p48: CAD file, 2026-11-13]
designs/module-rp2040/mechanical/rev0.9/case/Logo-insert-blank.step
53.8 x 28.4 x 3.40 mm
