68mschmitt/cleavboard/designs/module-rp2040/mechanical/rev0.9/case/controller-socket-shim-0.2mm.step

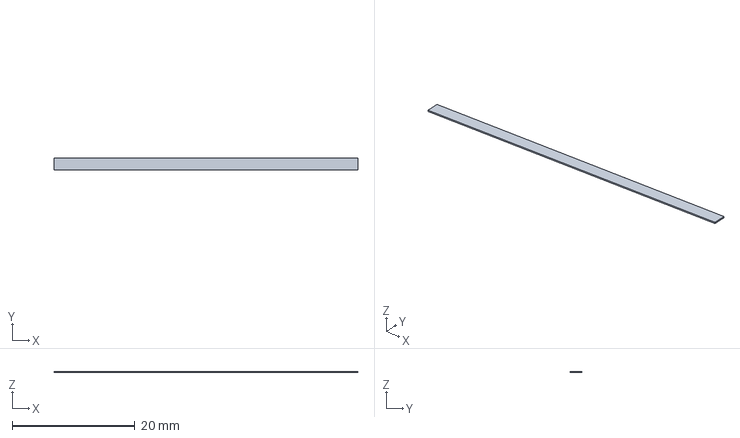
[picture p49: CAD file, 2026-11-13]
designs/module-rp2040/mechanical/rev0.9/case/controller-socket-shim-0.2mm.step
49.6 x 2.00 x 0.2 mm
