68mschmitt/cleavboard/designs/module-rp2040/mechanical/rev0.9/case/Logo-fit-coupon-cover.step

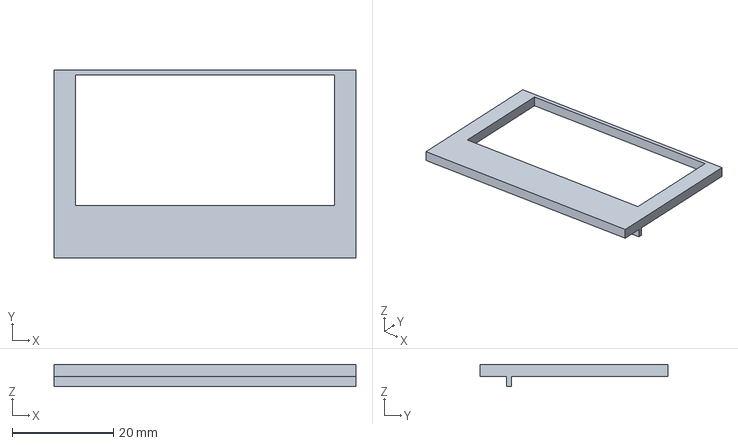
[picture p50: CAD file, 2026-11-13]
designs/module-rp2040/mechanical/rev0.9/case/Logo-fit-coupon-cover.step
59.8 x 37.2 x 4.40 mm
