68mschmitt/cleavboard/designs/module-rp2040/mechanical/rev0.9/case/Logo-fit-coupon-plate.step

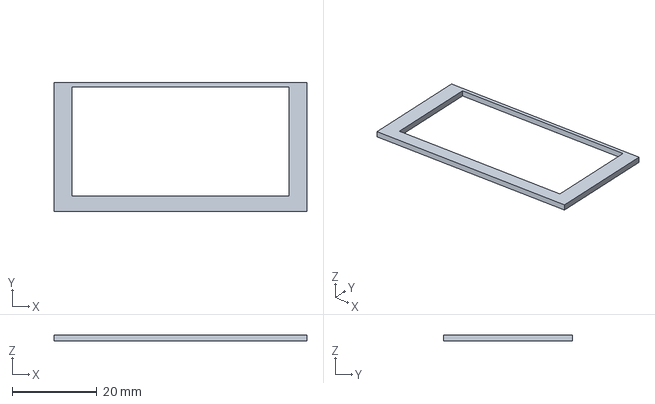
[picture p51: CAD file, 2026-11-13]
designs/module-rp2040/mechanical/rev0.9/case/Logo-fit-coupon-plate.step
59.8 x 30.4 x 1.50 mm
