68mschmitt/cleavboard/designs/module-rp2040/mechanical/rev0.9/case/USB-and-seat-fit-coupon-cover.step

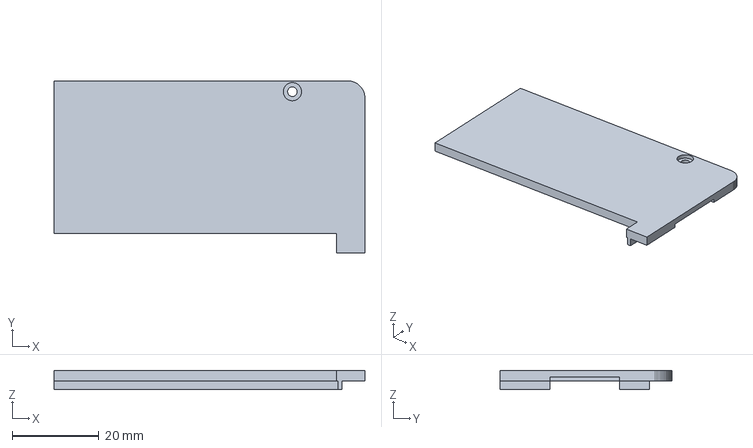
[picture p52: CAD file, 2026-11-13]
designs/module-rp2040/mechanical/rev0.9/case/USB-and-seat-fit-coupon-cover.step
71.8 x 39.7 x 4.40 mm
