68mschmitt/cleavboard/designs/module-rp2040/mechanical/rev0.9/case/Cleaver-case-base-rev0.9.step

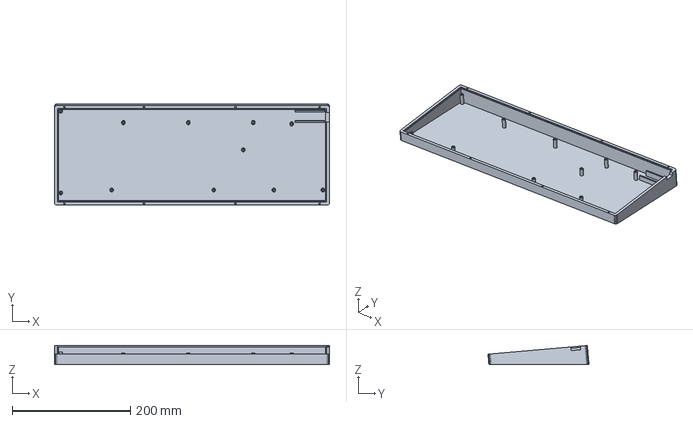
[picture p53: CAD file, 2026-11-13]
designs/module-rp2040/mechanical/rev0.9/case/Cleaver-case-base-rev0.9.step
465.9 x 171.3 x 32.2 mm
