68mschmitt/cleavboard/designs/module-rp2040/mechanical/stabilizer-fit-coupon.scad

linear_extrude(height=1.5) import("stabilizer-fit-coupon.svg");
