68mschmitt/cleavboard/(list of files, cad)

Other CAD files:
designs/module-rp2040/mechanical/pcb-fit-model/Cleaver-PCB-1-left.stl
designs/module-rp2040/mechanical/rev0.6/case/Cleaver-case-assembly-rev0.6.FCStd
designs/module-rp2040/mechanical/rev0.6/case/Cleaver-case-assembly-rev0.6.step
designs/module-rp2040/mechanical/rev0.6/case/Cleaver-case-base-rev0.6.step
designs/module-rp2040/mechanical/rev0.6/case/Cleaver-case-base-rev0.6.stl
designs/module-rp2040/mechanical/rev0.6/case/Cleaver-case-top-cover-rev0.6.step
designs/module-rp2040/mechanical/rev0.6/case/PCB-to-plate-spacer-3.5mm.step
designs/module-rp2040/mechanical/rev0.6/case/USB-and-seat-fit-coupon-base.step
designs/module-rp2040/mechanical/rev0.6/case/USB-and-seat-fit-coupon-base.stl
designs/module-rp2040/mechanical/rev0.6/case/USB-and-seat-fit-coupon-cover.step
designs/module-rp2040/mechanical/rev0.7/Cleaver-top-plate-rev0.7.stl
designs/module-rp2040/mechanical/rev0.7/case/Cleaver-case-assembly-rev0.7.FCStd
designs/module-rp2040/mechanical/rev0.7/case/Cleaver-case-assembly-rev0.7.step
designs/module-rp2040/mechanical/rev0.7/case/Cleaver-case-base-rev0.7.step
designs/module-rp2040/mechanical/rev0.7/case/Cleaver-case-base-rev0.7.stl
designs/module-rp2040/mechanical/rev0.7/case/Cleaver-case-top-cover-rev0.7.step
designs/module-rp2040/mechanical/rev0.7/case/Cleaver-case-top-cover-rev0.7.stl
designs/module-rp2040/mechanical/rev0.7/case/PCB-to-plate-spacer-3.5mm.step
designs/module-rp2040/mechanical/rev0.7/case/USB-and-seat-fit-coupon-base.step
designs/module-rp2040/mechanical/rev0.7/case/USB-and-seat-fit-coupon-cover.step
designs/module-rp2040/mechanical/rev0.7/case/USB-and-seat-fit-coupon-cover.stl
designs/module-rp2040/mechanical/rev0.7/case/controller-socket-shim-0.2mm.step
designs/module-rp2040/mechanical/rev0.7/case/controller-socket-shim-0.4mm.step
designs/module-rp2040/mechanical/rev0.7/case/controller-socket-shim-0.6mm.step
designs/module-rp2040/mechanical/rev0.7/case/controller-socket-shim-0.8mm.step
designs/module-rp2040/mechanical/rev0.7/case/controller-socket-shim-1.0mm.step
designs/module-rp2040/mechanical/rev0.8/Cleaver-top-plate-rev0.8.dxf
designs/module-rp2040/mechanical/rev0.8/Cleaver-top-plate-rev0.8.stl
designs/module-rp2040/mechanical/rev0.8/case/Cleaver-case-assembly-rev0.8.FCStd
designs/module-rp2040/mechanical/rev0.8/case/Cleaver-case-assembly-rev0.8.step
designs/module-rp2040/mechanical/rev0.8/case/Cleaver-case-base-rev0.8.step
designs/module-rp2040/mechanical/rev0.8/case/Cleaver-case-base-rev0.8.stl
designs/module-rp2040/mechanical/rev0.8/case/Cleaver-case-top-cover-rev0.8.step
designs/module-rp2040/mechanical/rev0.8/case/Cleaver-case-top-cover-rev0.8.stl
designs/module-rp2040/mechanical/rev0.8/case/Logo-fit-coupon-cover.step
designs/module-rp2040/mechanical/rev0.8/case/Logo-fit-coupon-cover.stl
designs/module-rp2040/mechanical/rev0.8/case/Logo-fit-coupon-plate.step
designs/module-rp2040/mechanical/rev0.8/case/Logo-fit-coupon-plate.stl
designs/module-rp2040/mechanical/rev0.8/case/Logo-insert-blank.step
designs/module-rp2040/mechanical/rev0.8/case/Logo-insert-blank.stl
designs/module-rp2040/mechanical/rev0.8/case/Logo-insert-template.scad
designs/module-rp2040/mechanical/rev0.8/case/Logo-light-well.step
designs/module-rp2040/mechanical/rev0.8/case/Logo-light-well.stl
designs/module-rp2040/mechanical/rev0.8/case/PCB-to-plate-spacer-3.5mm.step
designs/module-rp2040/mechanical/rev0.8/case/USB-and-seat-fit-coupon-base.step
designs/module-rp2040/mechanical/rev0.8/case/USB-and-seat-fit-coupon-base.stl
designs/module-rp2040/mechanical/rev0.8/case/USB-and-seat-fit-coupon-cover.step
designs/module-rp2040/mechanical/rev0.8/case/USB-and-seat-fit-coupon-cover.stl
designs/module-rp2040/mechanical/rev0.8/case/controller-socket-shim-0.2mm.step
designs/module-rp2040/mechanical/rev0.8/case/controller-socket-shim-0.4mm.step
designs/module-rp2040/mechanical/rev0.8/case/controller-socket-shim-0.6mm.step
designs/module-rp2040/mechanical/rev0.8/case/controller-socket-shim-0.8mm.step
designs/module-rp2040/mechanical/rev0.8/case/controller-socket-shim-1.0mm.step
designs/module-rp2040/mechanical/rev0.9/Cleaver-top-plate-rev0.9.dxf
designs/module-rp2040/mechanical/rev0.9/case/Cleaver-case-assembly-rev0.9.FCStd
designs/module-rp2040/mechanical/rev0.9/case/Cleaver-case-base-rev0.9.stl
designs/module-rp2040/mechanical/rev0.9/case/Cleaver-case-top-cover-rev0.9.stl
designs/module-rp2040/mechanical/rev0.9/case/Logo-fit-coupon-cover.stl
designs/module-rp2040/mechanical/rev0.9/case/Logo-fit-coupon-plate.stl
designs/module-rp2040/mechanical/rev0.9/case/Logo-insert-blank.stl
designs/module-rp2040/mechanical/rev0.9/case/Logo-light-well.stl
designs/module-rp2040/mechanical/rev0.9/case/PCB-to-plate-spacer-3.5mm.stl
designs/module-rp2040/mechanical/rev0.9/case/USB-and-seat-fit-coupon-base.stl
designs/module-rp2040/mechanical/rev0.9/case/USB-and-seat-fit-coupon-cover.stl
designs/module-rp2040/mechanical/rev0.9/case/controller-socket-shim-0.2mm.stl
designs/module-rp2040/mechanical/rev0.9/case/controller-socket-shim-0.4mm.stl
designs/module-rp2040/mechanical/rev0.9/case/controller-socket-shim-0.6mm.stl
designs/module-rp2040/mechanical/rev0.9/case/controller-socket-shim-0.8mm.stl
designs/module-rp2040/mechanical/rev0.9/case/controller-socket-shim-1.0mm.stl
