68mschmitt/cleavboard/designs/module-rp2040/manufacturing/README.md

# Module RP2040 manufacturing

| Location | Contents |
| --- | --- |
| [rev0.9/](rev0.9/README.md) | Current 50.8 × 25.4 mm badge, deeper front bezel, 489 bottom-SMT placements and 121 RGB pixels |
| [rev0.8/](rev0.8/README.md) | Historical 16 mm square illuminated badge |
| [rev0.7/](rev0.7/README.md) | Historical socketed RP2040-Plus: 481 bottom-SMT placements, pin map, prototype/engineering handoff |
| [rev0.6/](rev0.6/README.md) | Historical direct-soldered RP2040-Plus; firmware builds remain compatible with rev0.7 |
| [rev0.5/](rev0.5/README.md) | Historical YD-RP2040 revision, requiring an external USB tap wire |
| [BOM.csv](BOM.csv) | Full current design BOM; use revision-specific JLCPCB files for ordering |
| [rev0.4/](rev0.4/README.md) | Historical revision 0.4 package |
| [taviana/](taviana/) | Historical revision 0.4 logo-inclusive fabrication package |
| [archive/](archive/README.md) | Original unversioned Gerber ZIP |
| [ORDER-REVIEW.md](ORDER-REVIEW.md) | Recorded revision 0.4 ordering review |

Use the [design README](../README.md) and
[component review](../references/COMPONENT-REVIEW.md) for current assembly details.
Revision 0.6–0.9 `SHA256.json` paths are relative to the module design directory.
Older manifests retain their historical paths and hashes; see the
[repository migration guide](../../../docs/REPOSITORY.md#recorded-evidence).
