68mschmitt/cleavboard/designs/embedded-rp2040/manufacturing/README.md

# Embedded RP2040 manufacturing exports

- [BOM.csv](BOM.csv): complete design BOM emitted by `source/generate.py`.
- [rev0.2/](rev0.2/README.md): preserved revision 0.2 Gerber and placement exports.
- [taviana/](taviana/): logo-inclusive revision 0.2 fabrication ZIP and manifest.

See the [design README](../README.md), [handoff](../HANDOFF.md), and
[artwork documentation](../../../assets/artwork/taviana/README.md) for package
context and prototype status.
