68mschmitt/cleavboard/designs/embedded-rp2040/manufacturing/rev0.2/README.md

# Preserved revision 0.2 exports

These exports were previously loose at the embedded project's root:

- `Cleaver-Embedded-embedded-0.2-gerbers.zip`
- `Cleaver-Embedded-CPL.csv`
- `Cleaver-Embedded-JLCPCB-CPL.csv`
- `Cleaver-Embedded-JLCPCB-BOM-no-C5.csv`

The JLCPCB BOM explicitly excludes C5. Filenames and contents are retained to
preserve the export identities. The logo-inclusive fabrication archive and its
provenance are in [`../taviana/`](../taviana/).
