68mschmitt/cleavboard/designs/module-rp2040/manufacturing/archive/README.md

# Historical unversioned export

`Cleaver-gerbers.zip` was originally at the repository root. It is retained as
a historical artifact; the recorded ordering review notes that it lacks PTH/NPTH
drill files. The current module manufacturing handoff is
[`../rev0.5/`](../rev0.5/README.md).
