68mschmitt/cleavboard/designs/embedded-rp2040/review/current-review/B.Assembly-controller.png

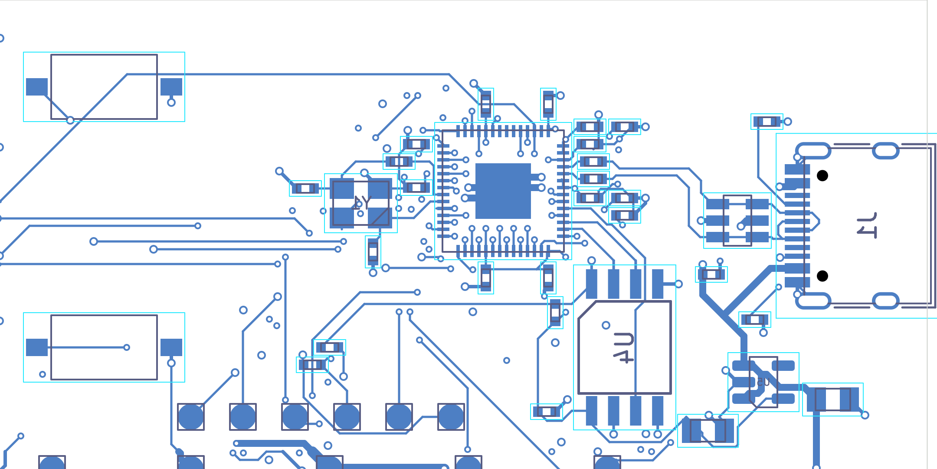
designs/embedded-rp2040/review/current-review/B.Assembly-controller.png
