68mschmitt/cleavboard/designs/module-rp2040/mechanical/rev0.9/case/assembly-preview.png

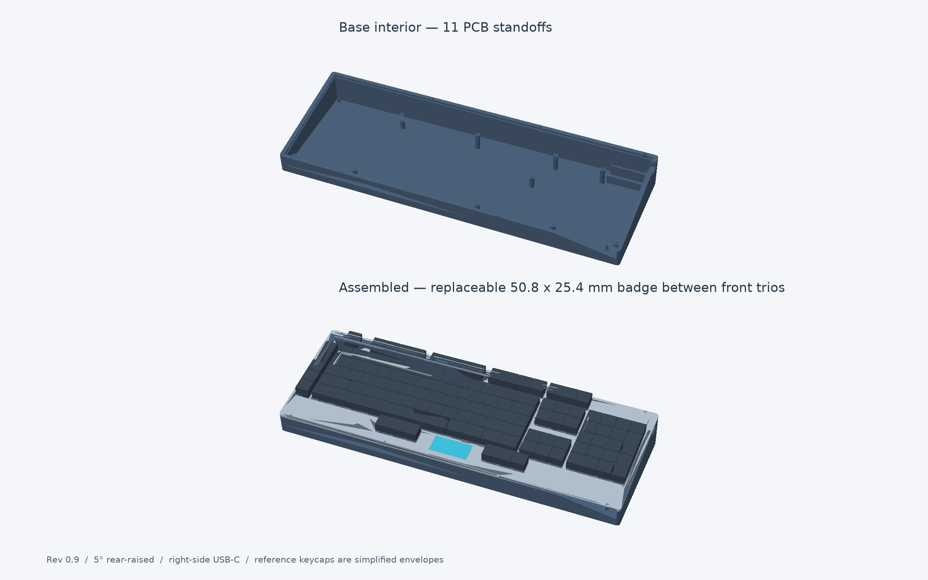
designs/module-rp2040/mechanical/rev0.9/case/assembly-preview.png
