68mschmitt/cleavboard/designs/single-color-devboard/review/bottom-assembly.png

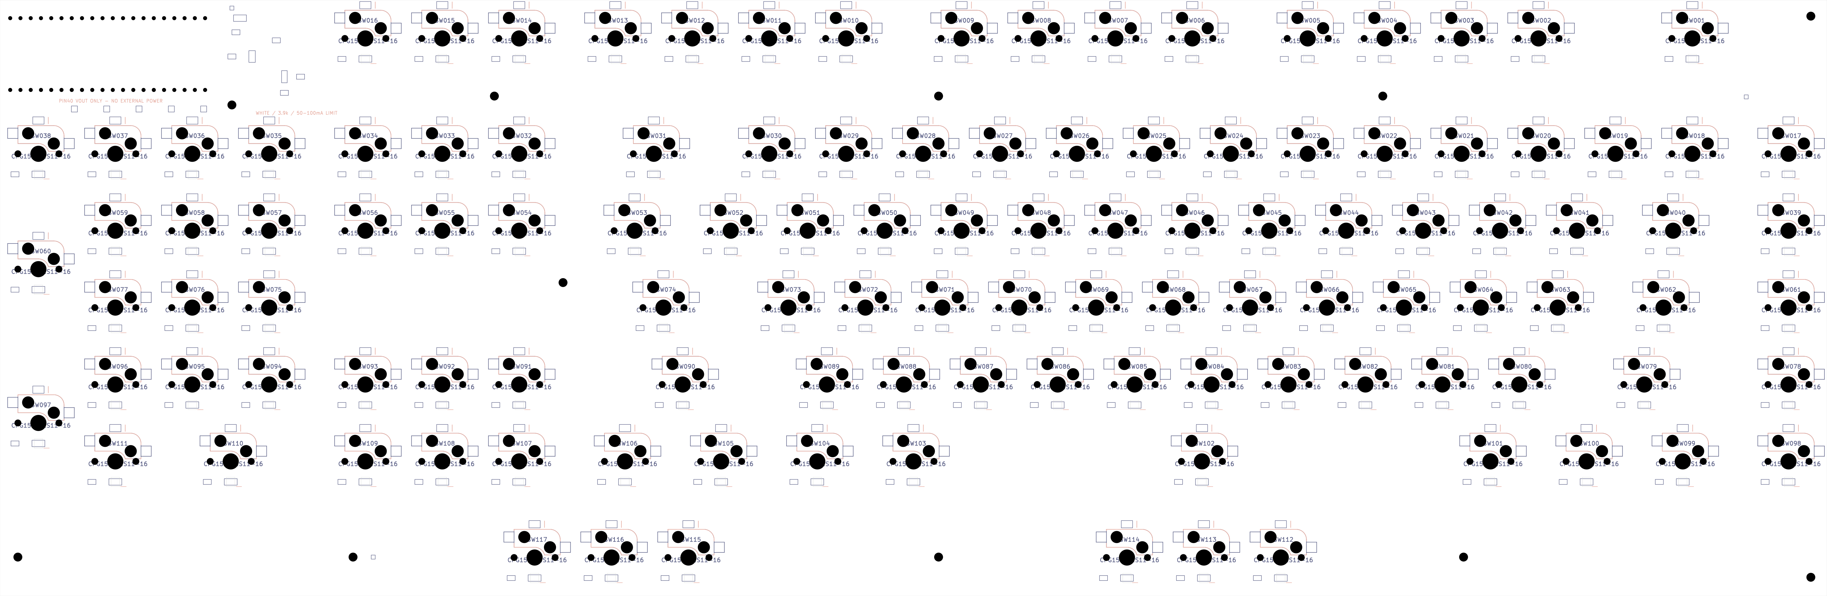
designs/single-color-devboard/review/bottom-assembly.png
