68mschmitt/cleavboard/designs/module-rp2040/validation/README.md

# Historical rev0.6 validation

The adjacent recorded reports and manifest belong to the **direct-soldered
revision 0.6** and are intentionally preserved. Current rev0.7 checks are in
[`manufacturing/rev0.7/checks/`](../manufacturing/rev0.7/checks/); see
[`VALIDATION.md`](../VALIDATION.md) for the current results and open release gates.
