68mschmitt/cleavboard/designs/module-rp2040/manufacturing/rev0.9/checks/unit-tests.txt

test_all_populated_smd_bottom_with_socket_centroids (test_assembly.AssemblyTests.test_all_populated_smd_bottom_with_socket_centroids) ... ok
test_capacitor_land_pattern_polarity_and_body_clearance (test_assembly.AssemblyTests.test_capacitor_land_pattern_polarity_and_body_clearance) ... ok
test_every_purchasing_group_has_matching_live_smt_evidence (test_assembly.AssemblyTests.test_every_purchasing_group_has_matching_live_smt_evidence) ... ok
test_jlc_catalog_rotations_only_correct_u2_and_switch_sockets (test_assembly.AssemblyTests.test_jlc_catalog_rotations_only_correct_u2_and_switch_sockets) ... ok
test_mounting_holes_and_reserved_copper (test_assembly.AssemblyTests.test_mounting_holes_and_reserved_copper) ... ok
test_no_plated_through_hole_component_connections (test_assembly.AssemblyTests.test_no_plated_through_hole_component_connections) ... ok
test_probe_pads_are_connected_bare_copper (test_assembly.AssemblyTests.test_probe_pads_are_connected_bare_copper) ... ok
test_socket_replacement_preserves_vendor_holes_and_lands (test_assembly.AssemblyTests.test_socket_replacement_preserves_vendor_holes_and_lands) ... ok
test_all_exported_stls_are_single_watertight_parts (test_case.CaseTests.test_all_exported_stls_are_single_watertight_parts) ... ok
test_back_is_higher_and_bores_follow_pcb_normal (test_case.CaseTests.test_back_is_higher_and_bores_follow_pcb_normal) ... ok
test_cad_no_interference_and_usb_opening (test_case.CaseTests.test_cad_no_interference_and_usb_opening) ... ok
test_case_floor_is_flat_and_unpierced (test_case.CaseTests.test_case_floor_is_flat_and_unpierced) ... ok
test_cover_serialized_material_and_all_keycap_apertures (test_case.CaseTests.test_cover_serialized_material_and_all_keycap_apertures) ... ok
test_parameters_source_and_matching_plate (test_case.CaseTests.test_parameters_source_and_matching_plate) ... ok
test_rejects_changed_capacitor_location (test_case.CaseTests.test_rejects_changed_capacitor_location) ... ok
test_serialized_standoffs_match_all_pcb_holes (test_case.CaseTests.test_serialized_standoffs_match_all_pcb_holes) ... ok
test_socket_backstops_and_clearance_recorded (test_case.CaseTests.test_socket_backstops_and_clearance_recorded) ... ok
test_diode_direction_and_module_connections (test_design.DesignTests.test_diode_direction_and_module_connections) ... ok
test_duplicate_is_rejected (test_design.DesignTests.test_duplicate_is_rejected) ... ok
test_firmware_gpio_to_waveshare_header_mapping (test_design.DesignTests.test_firmware_gpio_to_waveshare_header_mapping) ... ok
test_generated_firmware_and_csv (test_design.DesignTests.test_generated_firmware_and_csv) ... ok
test_rgb_chain (test_design.DesignTests.test_rgb_chain) ... ok
test_unique_matrix (test_design.DesignTests.test_unique_matrix) ... ok
test_vbus_header_feeds_protected_led_branch (test_design.DesignTests.test_vbus_header_feeds_protected_led_branch) ... ok
test_vial_identity_and_secure_unlock_retained (test_design.DesignTests.test_vial_identity_and_secure_unlock_retained) ... ok
test_waveshare_pico_compatible_pinout (test_design.DesignTests.test_waveshare_pico_compatible_pinout) ... ok
test_dsn_fresh_board_rules (test_generation.GenerationTests.test_dsn_fresh_board_rules) ... ok
test_dsn_rejects_missing_opening (test_generation.GenerationTests.test_dsn_rejects_missing_opening) ... ok
test_dsn_saved_board_netclasses (test_generation.GenerationTests.test_dsn_saved_board_netclasses) ... ok
test_reverse_mount_led_geometry (test_generation.GenerationTests.test_reverse_mount_led_geometry) ... ok
test_actual_firmware_callbacks_brightness_direct_mode_and_usb_gating (test_logo.LogoTests.test_actual_firmware_callbacks_brightness_direct_mode_and_usb_gating) ... ok
test_chain_starts_after_last_key_and_uses_protected_supply (test_logo.LogoTests.test_chain_starts_after_last_key_and_uses_protected_supply) ... ok
test_insert_cannot_escape_up_or_down_with_cover_installed (test_logo.LogoTests.test_insert_cannot_escape_up_or_down_with_cover_installed) ... ok
test_printed_face_is_two_by_one_inches_and_clears_keys (test_logo.LogoTests.test_printed_face_is_two_by_one_inches_and_clears_keys) ... ok
test_serialized_aperture_is_centered_between_the_two_trios (test_logo.LogoTests.test_serialized_aperture_is_centered_between_the_two_trios) ... ok
test_assignment_is_model_only_and_idempotent (test_models_3d.ModelTests.test_assignment_is_model_only_and_idempotent) ... ok
test_bare_wire_pad_has_no_invented_connector (test_models_3d.ModelTests.test_bare_wire_pad_has_no_invented_connector) ... ok
test_board_model_coverage (test_models_3d.ModelTests.test_board_model_coverage) ... ok
test_generated_model_envelopes (test_models_3d.ModelTests.test_generated_model_envelopes) ... ok
test_library_model_coverage_and_mounting (test_models_3d.ModelTests.test_library_model_coverage_and_mounting) ... ok
test_model_file_headers_and_step_counterparts (test_models_3d.ModelTests.test_model_file_headers_and_step_counterparts) ... ok
test_socketed_models_have_long_posts_and_bottom_entry_body (test_models_3d.ModelTests.test_socketed_models_have_long_posts_and_bottom_entry_body) ... ok
test_unfamiliar_assignment_is_preserved (test_models_3d.ModelTests.test_unfamiliar_assignment_is_preserved) ... ok
test_blocked_shortcut_keeps_detour (test_routing_cleanup.RoutingCleanupTests.test_blocked_shortcut_keeps_detour) ... ok
test_mid_segment_branch_is_preserved (test_routing_cleanup.RoutingCleanupTests.test_mid_segment_branch_is_preserved) ... ok
test_only_octilinear_shortcuts (test_routing_cleanup.RoutingCleanupTests.test_only_octilinear_shortcuts) ... ok
test_via_landing_inside_track_is_preserved (test_routing_cleanup.RoutingCleanupTests.test_via_landing_inside_track_is_preserved) ... ok
test_all_module_pins_reach_correct_socket_contact (test_socket_interface.SocketInterfaceTests.test_all_module_pins_reach_correct_socket_contact) ... ok
test_geometry_and_mating_depth (test_socket_interface.SocketInterfaceTests.test_geometry_and_mating_depth) ... ok
test_rejects_plated_entry_hole (test_socket_interface.SocketInterfaceTests.test_rejects_plated_entry_hole) ... ok
test_rejects_wrong_stagger (test_socket_interface.SocketInterfaceTests.test_rejects_wrong_stagger) ... ok
test_all_stls_and_report_agree (test_top_plate.TopPlateTests.test_all_stls_and_report_agree) ... ok
test_controller_notch_and_no_obsolete_capacitor_hole (test_top_plate.TopPlateTests.test_controller_notch_and_no_obsolete_capacitor_hole) ... ok
test_legacy_plate_geometry_preserved (test_top_plate.TopPlateTests.test_legacy_plate_geometry_preserved) ... ok
test_rejects_moved_switch (test_top_plate.TopPlateTests.test_rejects_moved_switch) ... ok
test_rejects_wrong_mounting_drill (test_top_plate.TopPlateTests.test_rejects_wrong_mounting_drill) ... ok
test_saved_pcb_alignment_and_revision (test_top_plate.TopPlateTests.test_saved_pcb_alignment_and_revision) ... ok
test_serialized_mounts_are_2_2mm_through_holes (test_top_plate.TopPlateTests.test_serialized_mounts_are_2_2mm_through_holes) ... ok
test_serialized_switch_openings_match_all_pcb_centres (test_top_plate.TopPlateTests.test_serialized_switch_openings_match_all_pcb_centres) ... ok
test_stabilizer_stems_latches_and_wire_clearance (test_top_plate.TopPlateTests.test_stabilizer_stems_latches_and_wire_clearance) ... ok

----------------------------------------------------------------------
Ran 60 tests in 9.495s

OK
