68mschmitt/cleavboard/designs/single-color-devboard/docs/Cleaver-White-schematic-details.pdf

## FGH

# TP3 MODULE_VOUT 1 2 C2

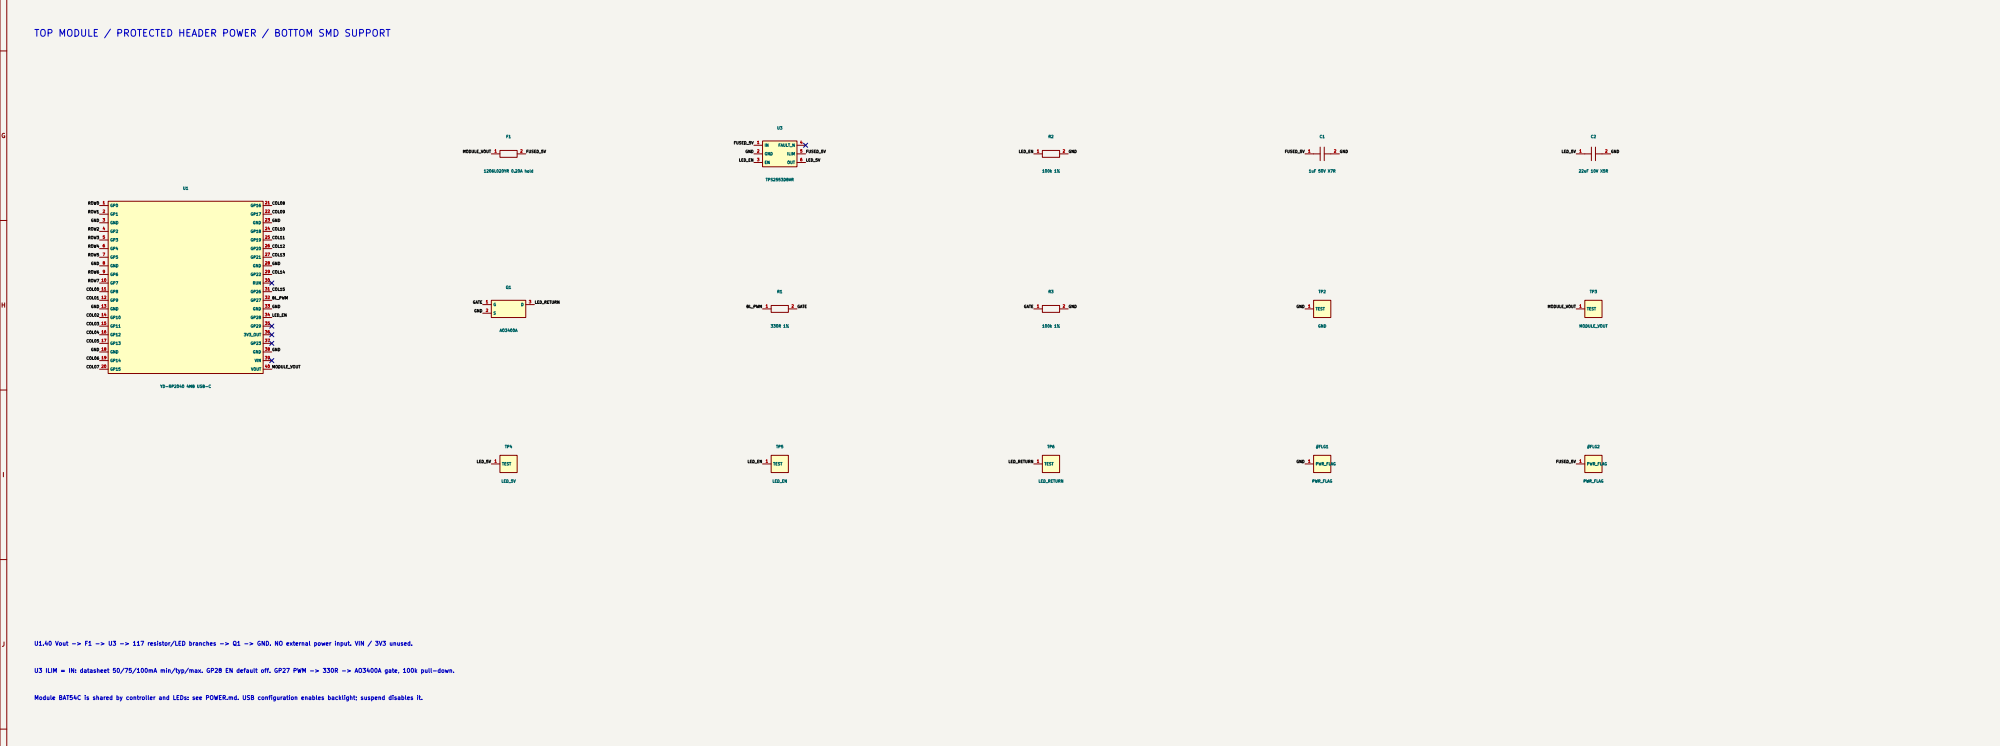
[picture p57: page 1]

TOP MODULE / PROTECTED HEADER POWER / BOTTOM SMD SUPPORT

U3 ILIM = IN: datasheet 50/75/100mA min/typ/max. GP28 EN default off. GP27 PWM -> 330R -> AO3400A gate, 100k pull-down. U1.40 Vout -> F1 -> U3 -> 117 resistor/LED branches -> Q1 -> GND. NO external power input. VIN / 3V3 unused.

Module BAT54C is shared by controller and LEDs: see POWER.md. USB configuration enables backlight; suspend disables it.

1 | 2 | 3 | 4 | 5 | 6 | 7 | 8 | 9 | 10 | 11 | 12 | 13 | 14 | 15 | 16 | 17 | 18 | 19 | 20 | 21 | 22 | 23

AB

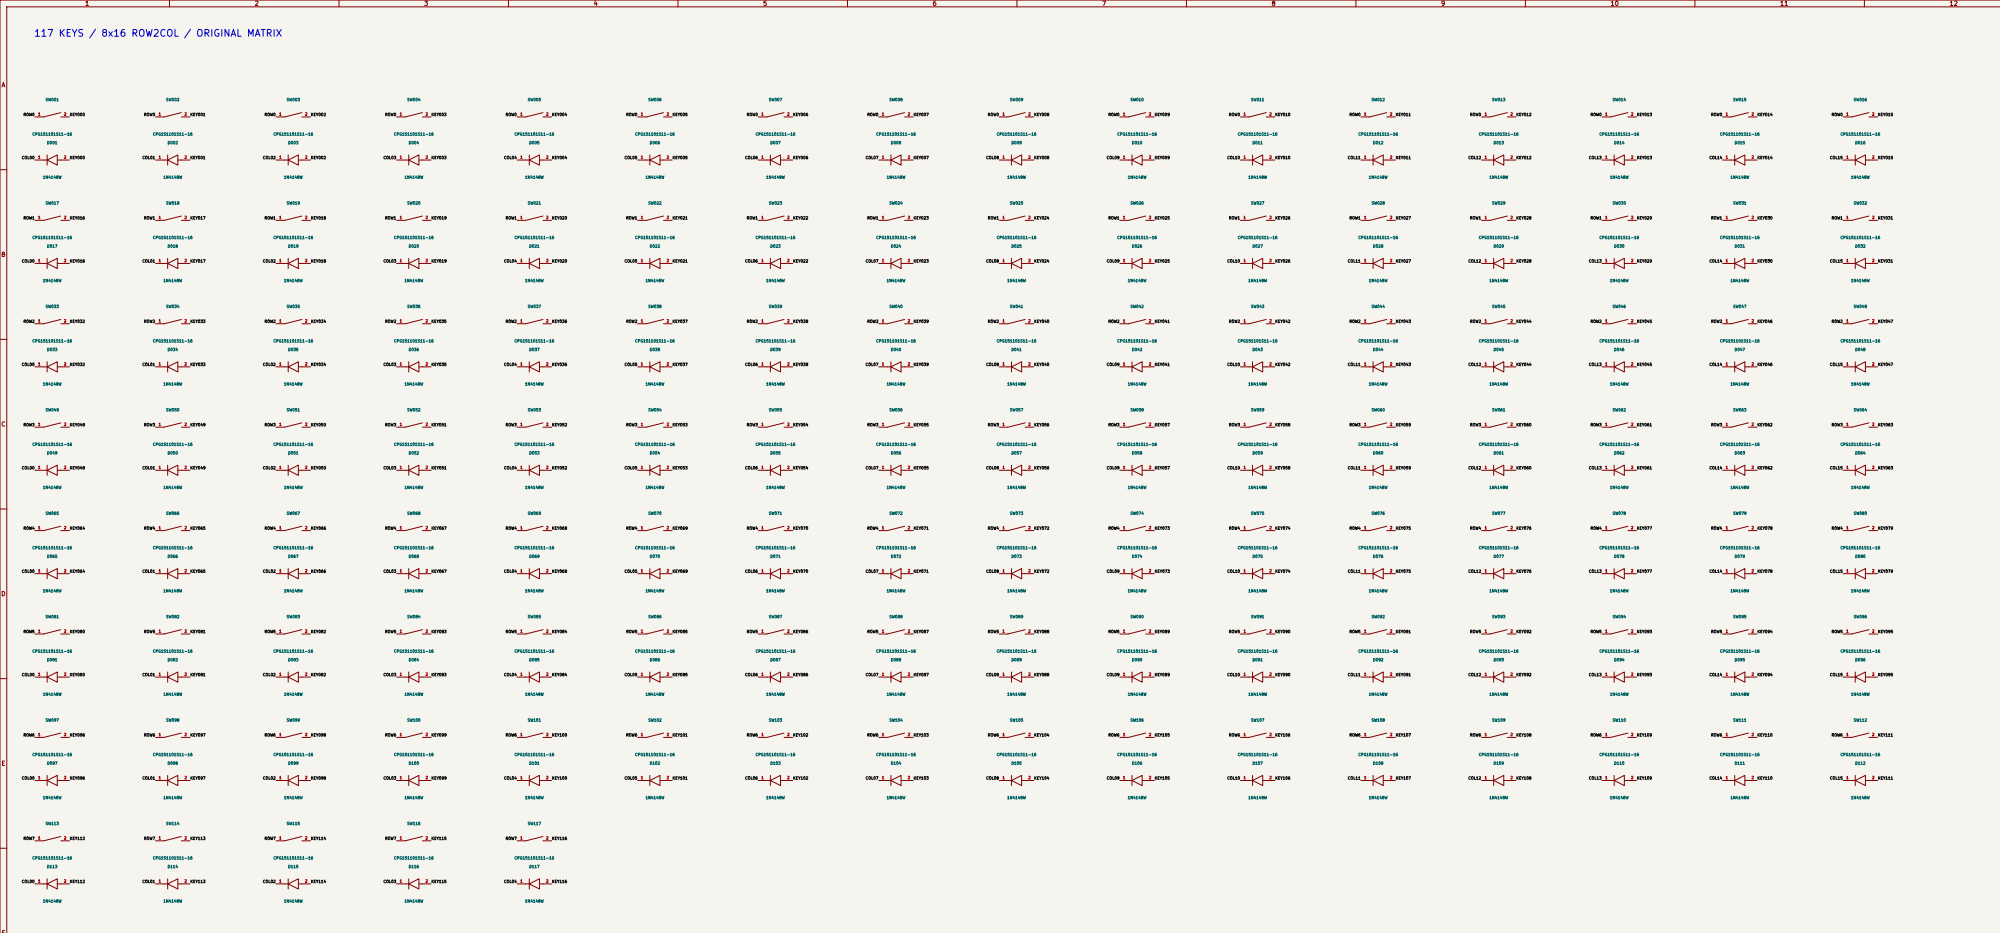
[picture p58: page 2]
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

AB

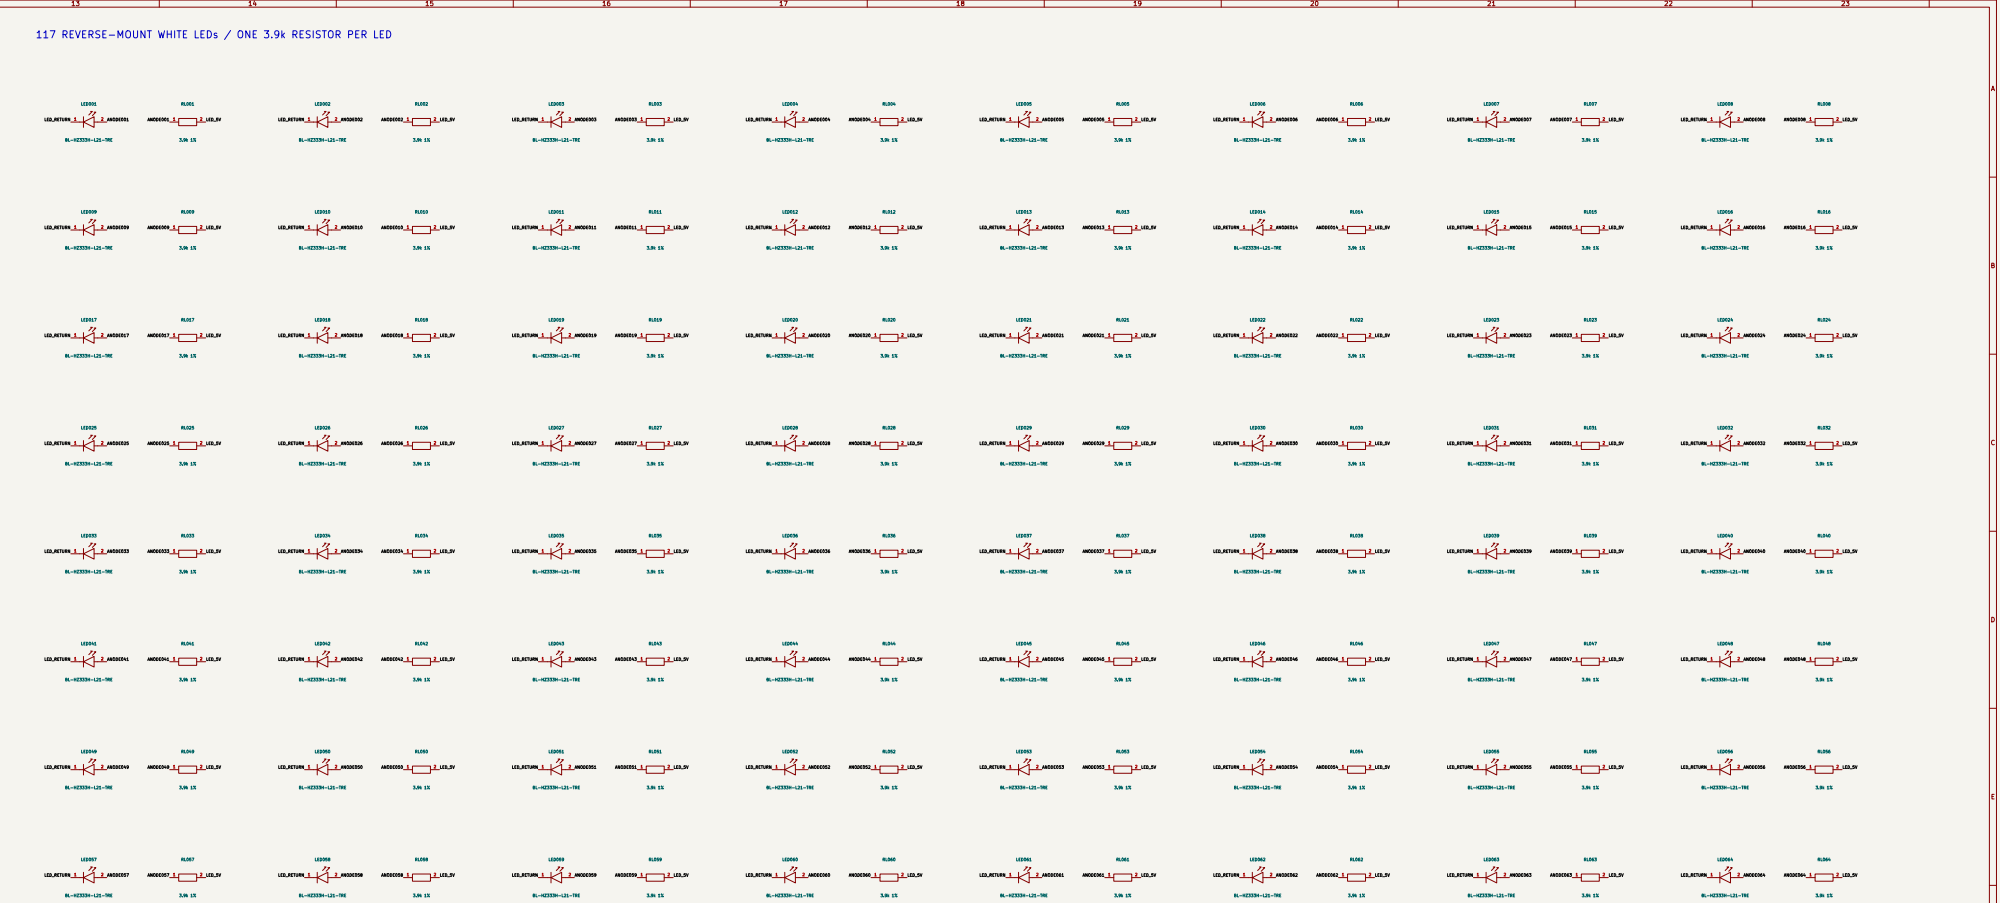
[picture p59: page 3]

## FGH

# LED065 BL-HZ333H-L21-TRE 1 2

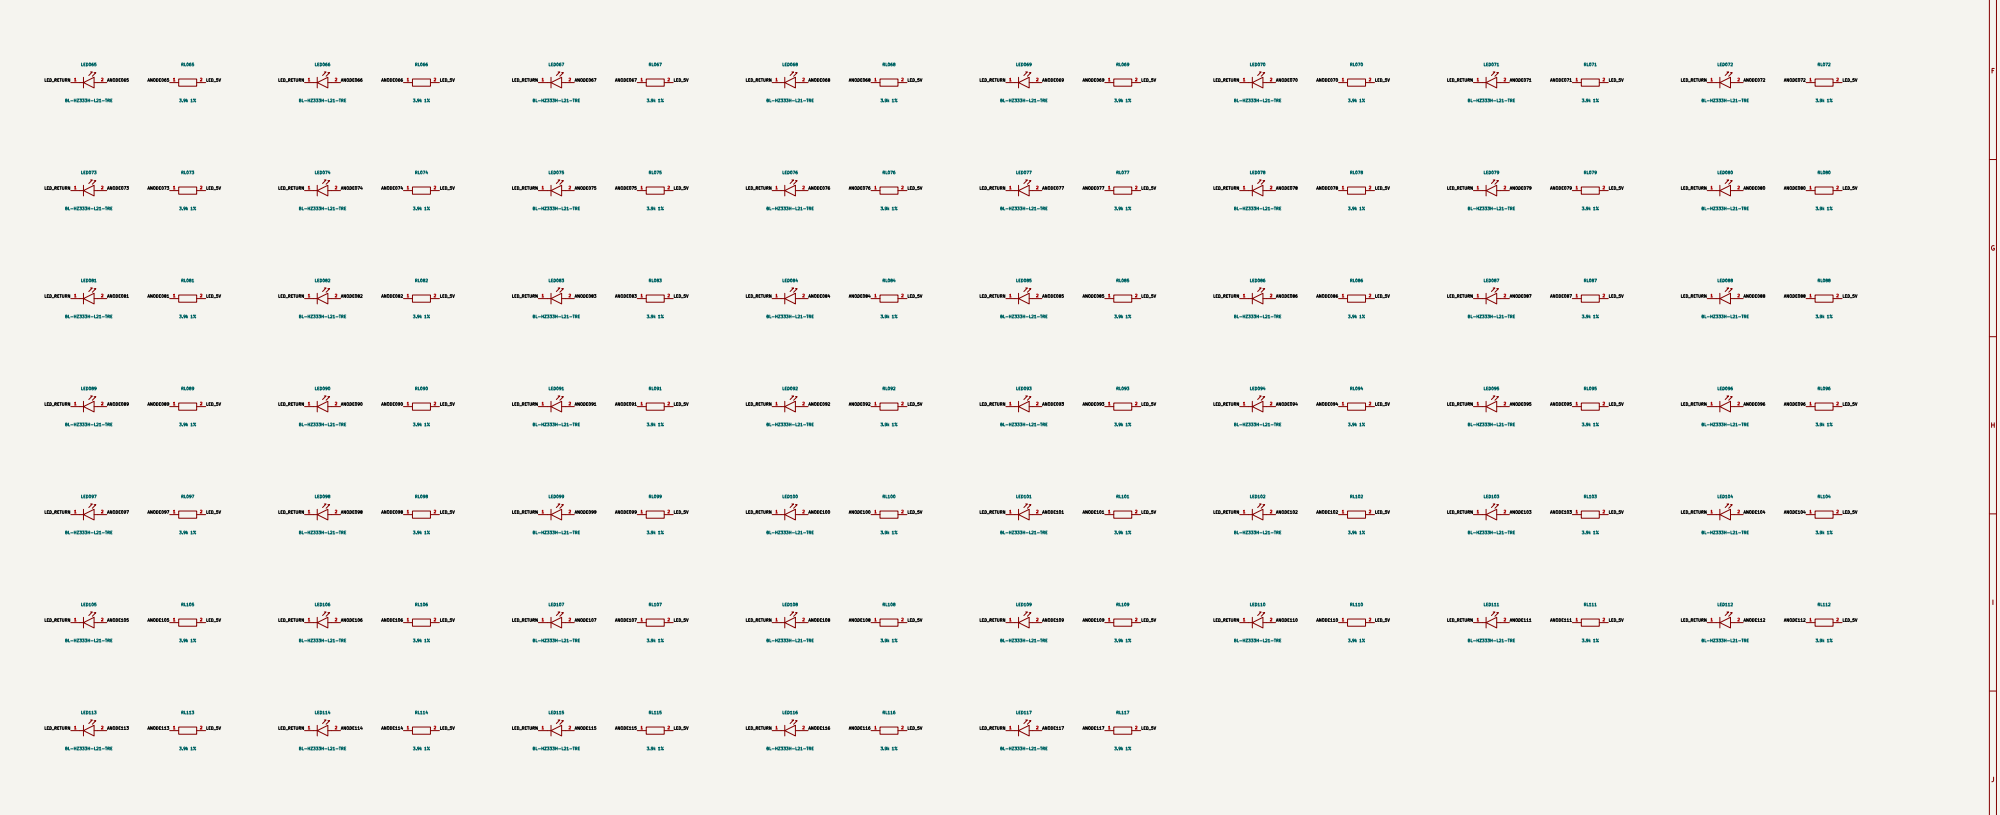
[picture p60: page 4]
