68mschmitt/cleavboard/designs/single-color-devboard/docs/Cleaver-White-schematic.pdf

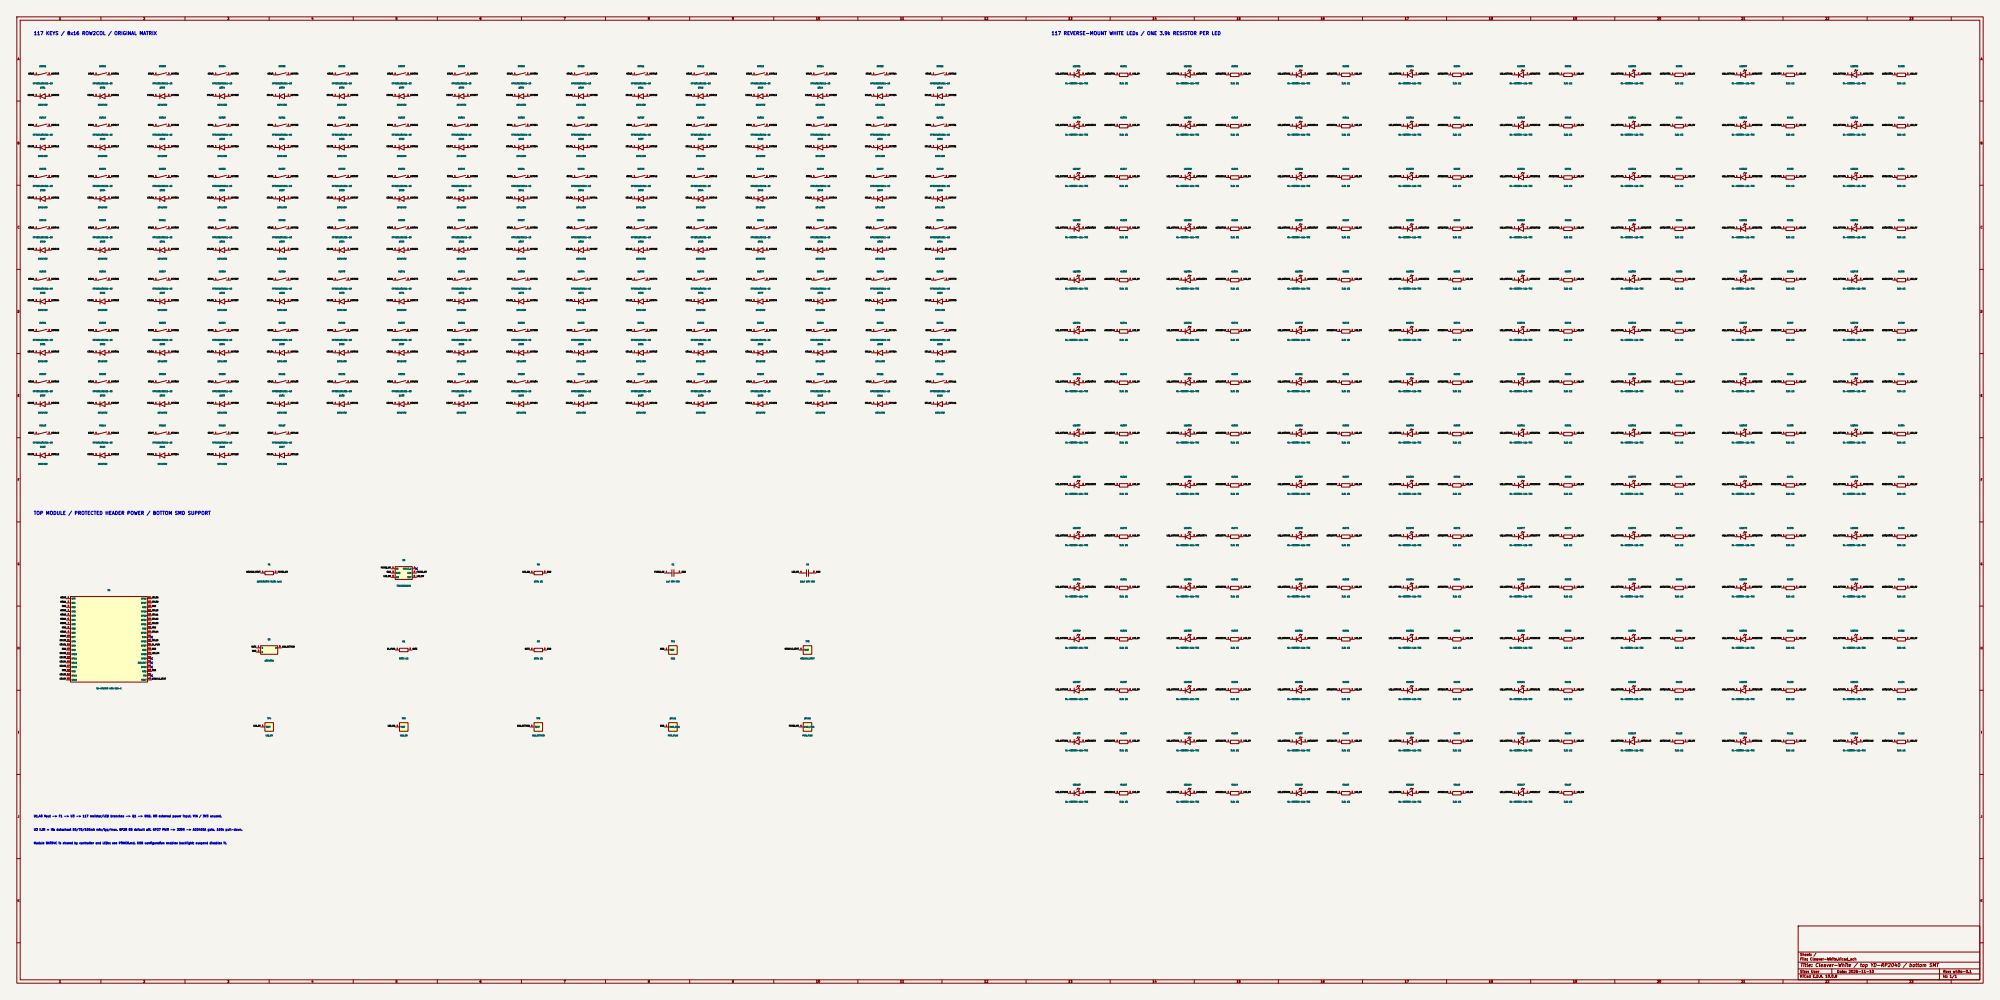
[picture p61: page 1]

TOP MODULE / PROTECTED HEADER POWER / BOTTOM SMD SUPPORT

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

Sheet: /
File: Cleaver-White.kicad_sch
Title: Cleaver-White / top YD-RP2040 / bottom SMT

Size: User | Rev: white-0.1
KiCad E.D.A. 10.0.8 | Id: 1/1
