68mschmitt/cleavboard/designs/embedded-rp2040/docs/Cleaver-Embedded-controller.pdf

1 | 2 | 3 | 4 | 5 | 6 | 7 | 8 | 9 | 10 | 11 | 12 | 13 | 14 | 15 | 16 | 17 | 18 | 19 | 20 | 21 | 22 | 23 1 | 2 | 3 | 4 | 5 | 6 | 7 | 8 | 9 | 10 | 11 | 12 | 13 | 14 | 15 | 16 | 17 | 18 | 19 | 20 | 21 | 22 | 23 ABCDEFGHIJKLMNOPQRSTUVW | ABCDEFGHIJKLMNOPQRSTUVW Date: 2026-11-09

# IOVDD 1 GP0 2 GP1 3 GP2 4 GP3 5 GP4 6 GP5 7 GP6 8 GP7 9

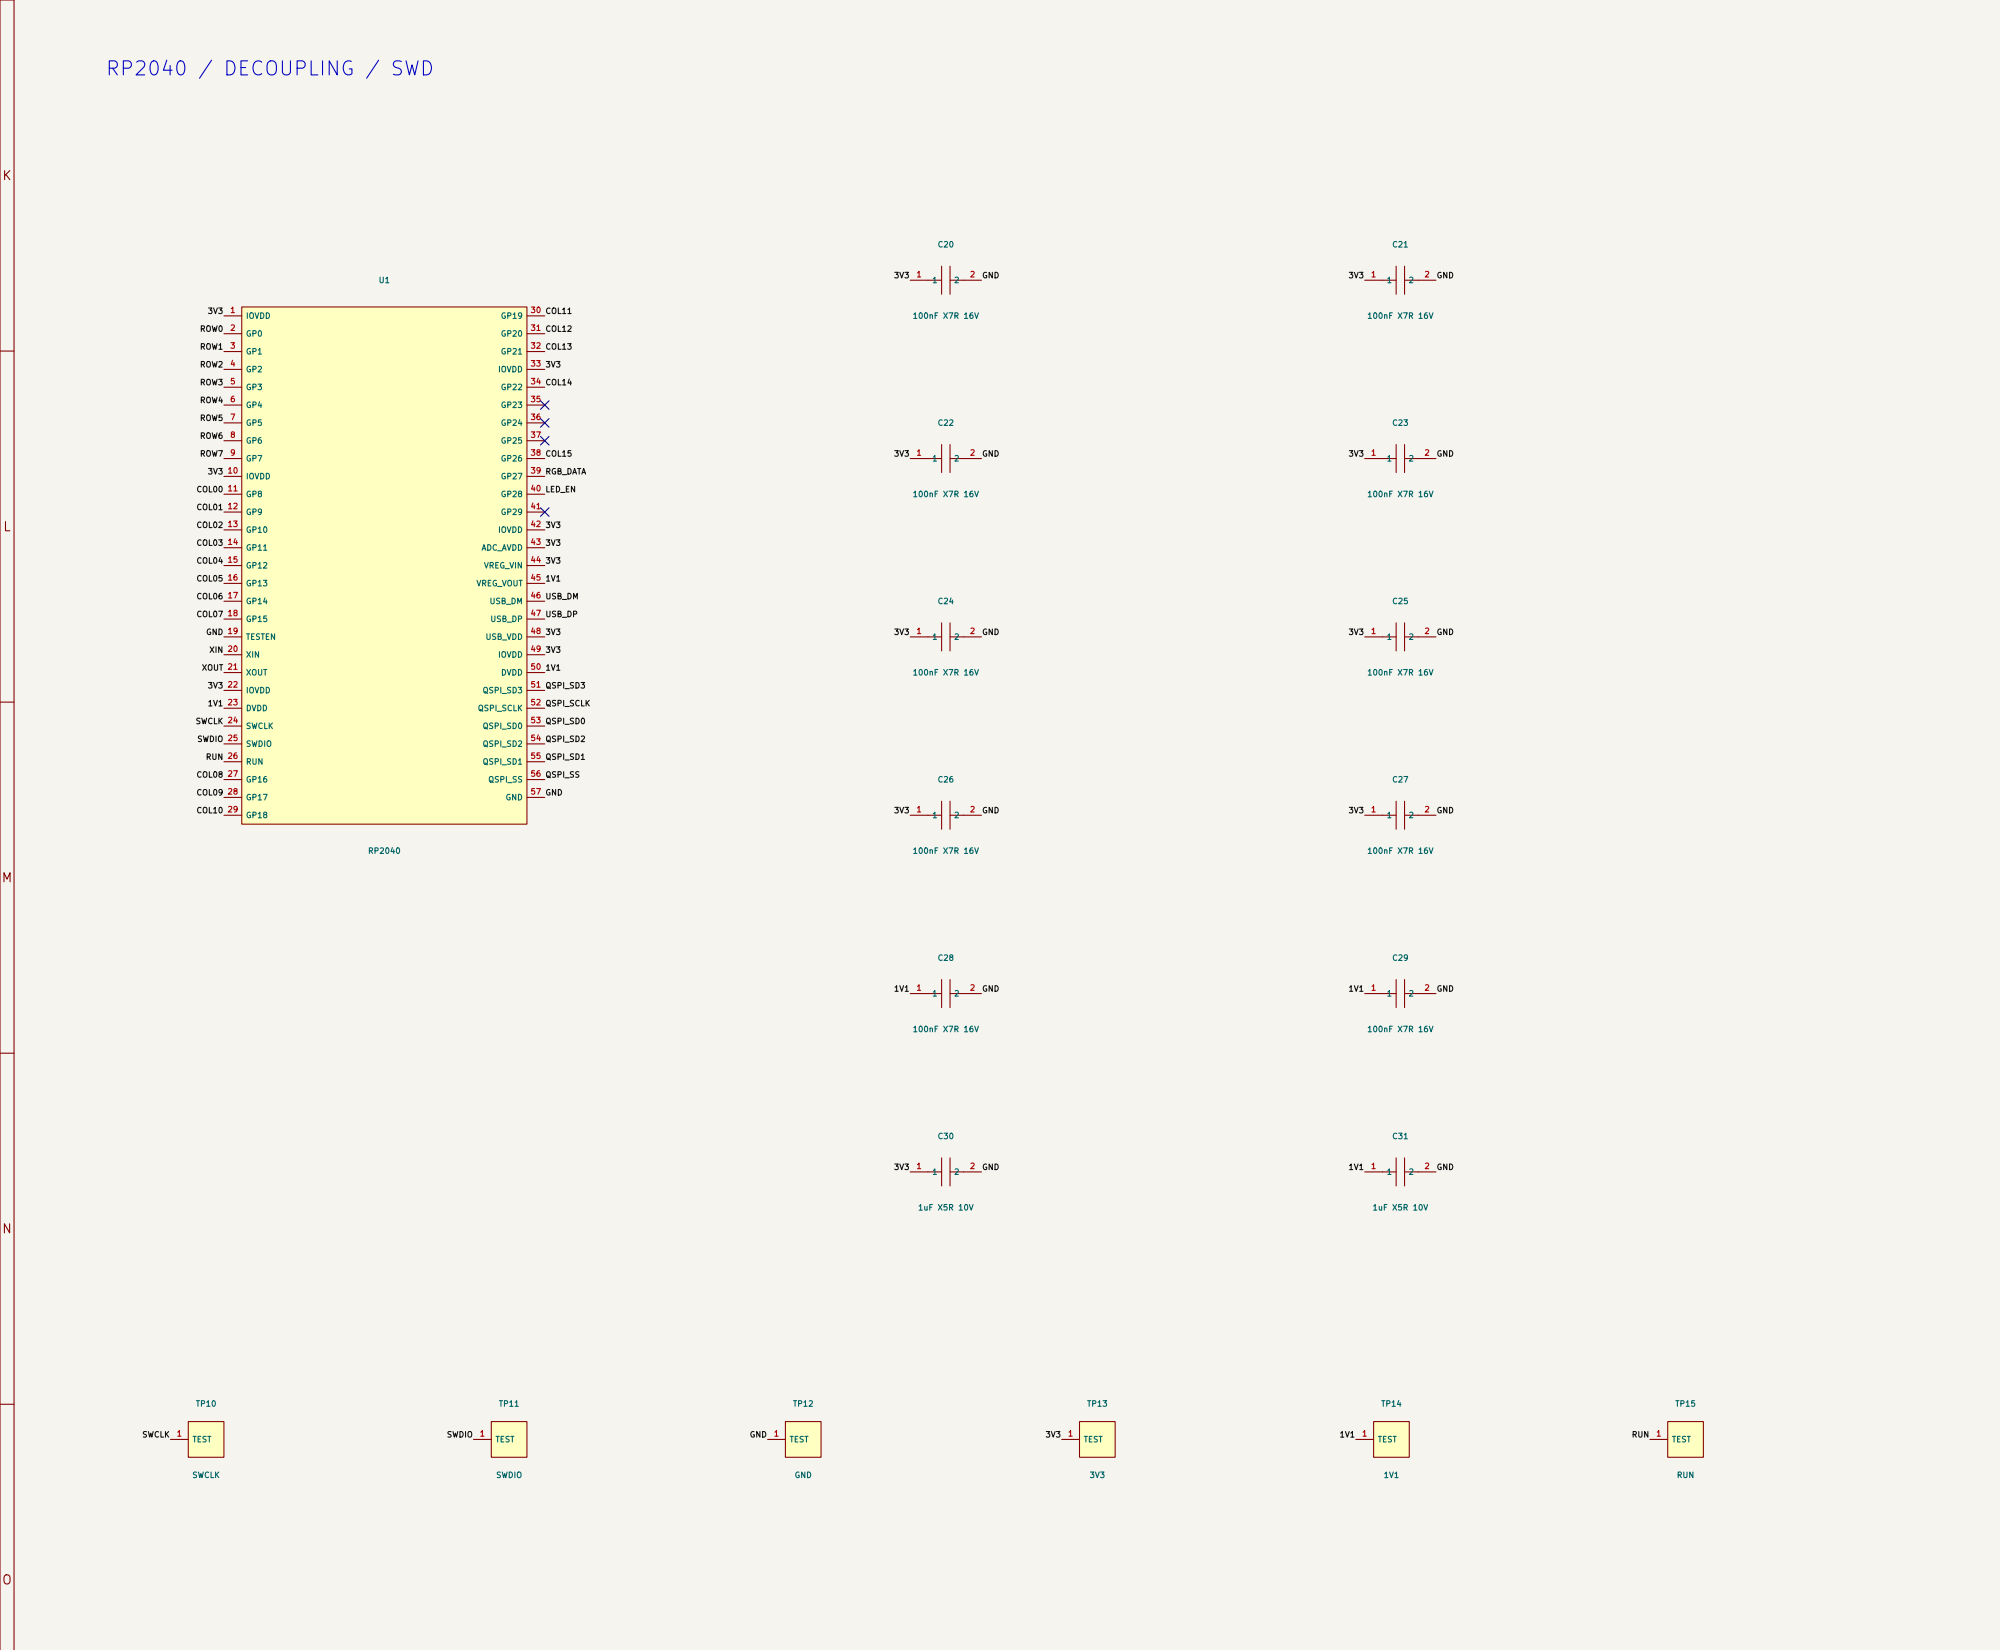
[picture p62: page 1]

1 | 2 | 3 | 4 | 5 | 6 | 7 | 8 | 9 | 10 | 11 | 12 | 13 | 14 | 15 | 16 | 17 | 18 | 19 | 20 | 21 | 22 | 23 1 | 2 | 3 | 4 | 5 | 6 | 7 | 8 | 9 | 10 | 11 | 12 | 13 | 14 | 15 | 16 | 17 | 18 | 19 | 20 | 21 | 22 | 23 ABCDEFGHIJKLMNOPQRSTUVW | ABCDEFGHIJKLMNOPQRSTUVW Date: 2026-11-09
TP3 RAW_USB_5V K 1 | A 2 D071
1N4148W | 1 1 | 2 2 C2
End | 1 1 | 2 2 C1
75k 1% K 1 | A 2 D055
1N4148W | 1 1 | 2 2 C3
SW048 I | 1 1 | 2 2 R1
LED_EN K 1 | A 2 D085
TP2 GND K 1 | A 2 D102
Alt | 1 1 | 2 2 R3
100k K 1 | A 2 D103

XTAL1 1 GND 2

XTAL2 3 GND 4

Y1

ABM8-272-T3 12MHz

TP12 GND | 1 1 | 2 2 C132
SK6812MINI-E C5149201 1 1 | 2 2 R15
1k 1% | 1 1 | 2 2 C175
1V1 | 1 1 | 2 2 C184
3V3 | 1 1 | 2 2 C192
100nF 50V X7R 1 1 | 2 2 C31
1uF X5R 10V | 1 1 | 2 2 BTN2 PTS636 SK25 SMTR LFS RESET | 1 1 | 2 2 C10
15pF C0G 50V 1 1 | 2 2 C30
100nF X7R 16V | 1 1 | 2 2 C124
100nF 50V X7R 1 1 | 2 2 BTN1 PTS636 SK25 SMTR LFS BOOTSEL
100nF 50V X7R 1 1 | 2 2 C23
100nF X7R 16V | 1 1 | 2 2 R14
1k 1% 1 1 | 2 2 C21
100nF X7R 16V | 1 1 | 2 2 C160

CS_N 1

IO1 2

IO2 3 GND 4

IO0 5 CLK 6

IO3 7

VCC 8 U4 W25Q32JVSSIQ 4MB | 1 1 | 2 2 C108
SK6812MINI-E C5149201 1 1 | 2 2 C24
100nF X7R 16V | 1 1 | 2 2 C135
100nF 50V X7R 1 1 | 2 2 C20
100nF X7R 16V | 1 1 | 2 2 C127
100nF 50V X7R 1 1 | 2 2 C22
100nF 50V X7R 1 1 | 2 2 R17
10k 1% | 1 1 | 2 2 C214
100nF 50V X7R 1 1 | 2 2 C11

15pF C0G 50V

100nF 50V X7R 1 1 | 2 2 C29
100nF X7R 16V | 1 1 | 2 2 R16

10k 1%

SK6812MINI-E C5149201 1 1 | 2 2 C27
1uF X7R 50V K 1 | A 2 D021
27R 1% K 1 | A 2 D037
100nF 50V X7R 1 1 | 2 2 C14
100nF X7R 16V | 1 1 | 2 2 C216

3V3

ROW5 ROW4 ROW3 ROW2 | QSPI_SS | BOOT_SW
XOUT | XTAL_OUT QSPI_SS | 3V3

3V3

XTAL_OUT ROW6 | RUN
GND | BOOT_SW | GND
RUN | GND

XTAL_OUT GND

XIN

GND

GND QSPI_SD2

GND QSPI_SD2 QSPI_SD1 QSPI_SS | QSPI_SD3 QSPI_SCLK QSPI_SD0

3V3 QSPI_SD0 QSPI_SCLK QSPI_SD3

XIN | GND
GND | 3V3 | RAW_USB_5V | USB_N

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

# J1 HRO TYPE-C-31-M-12

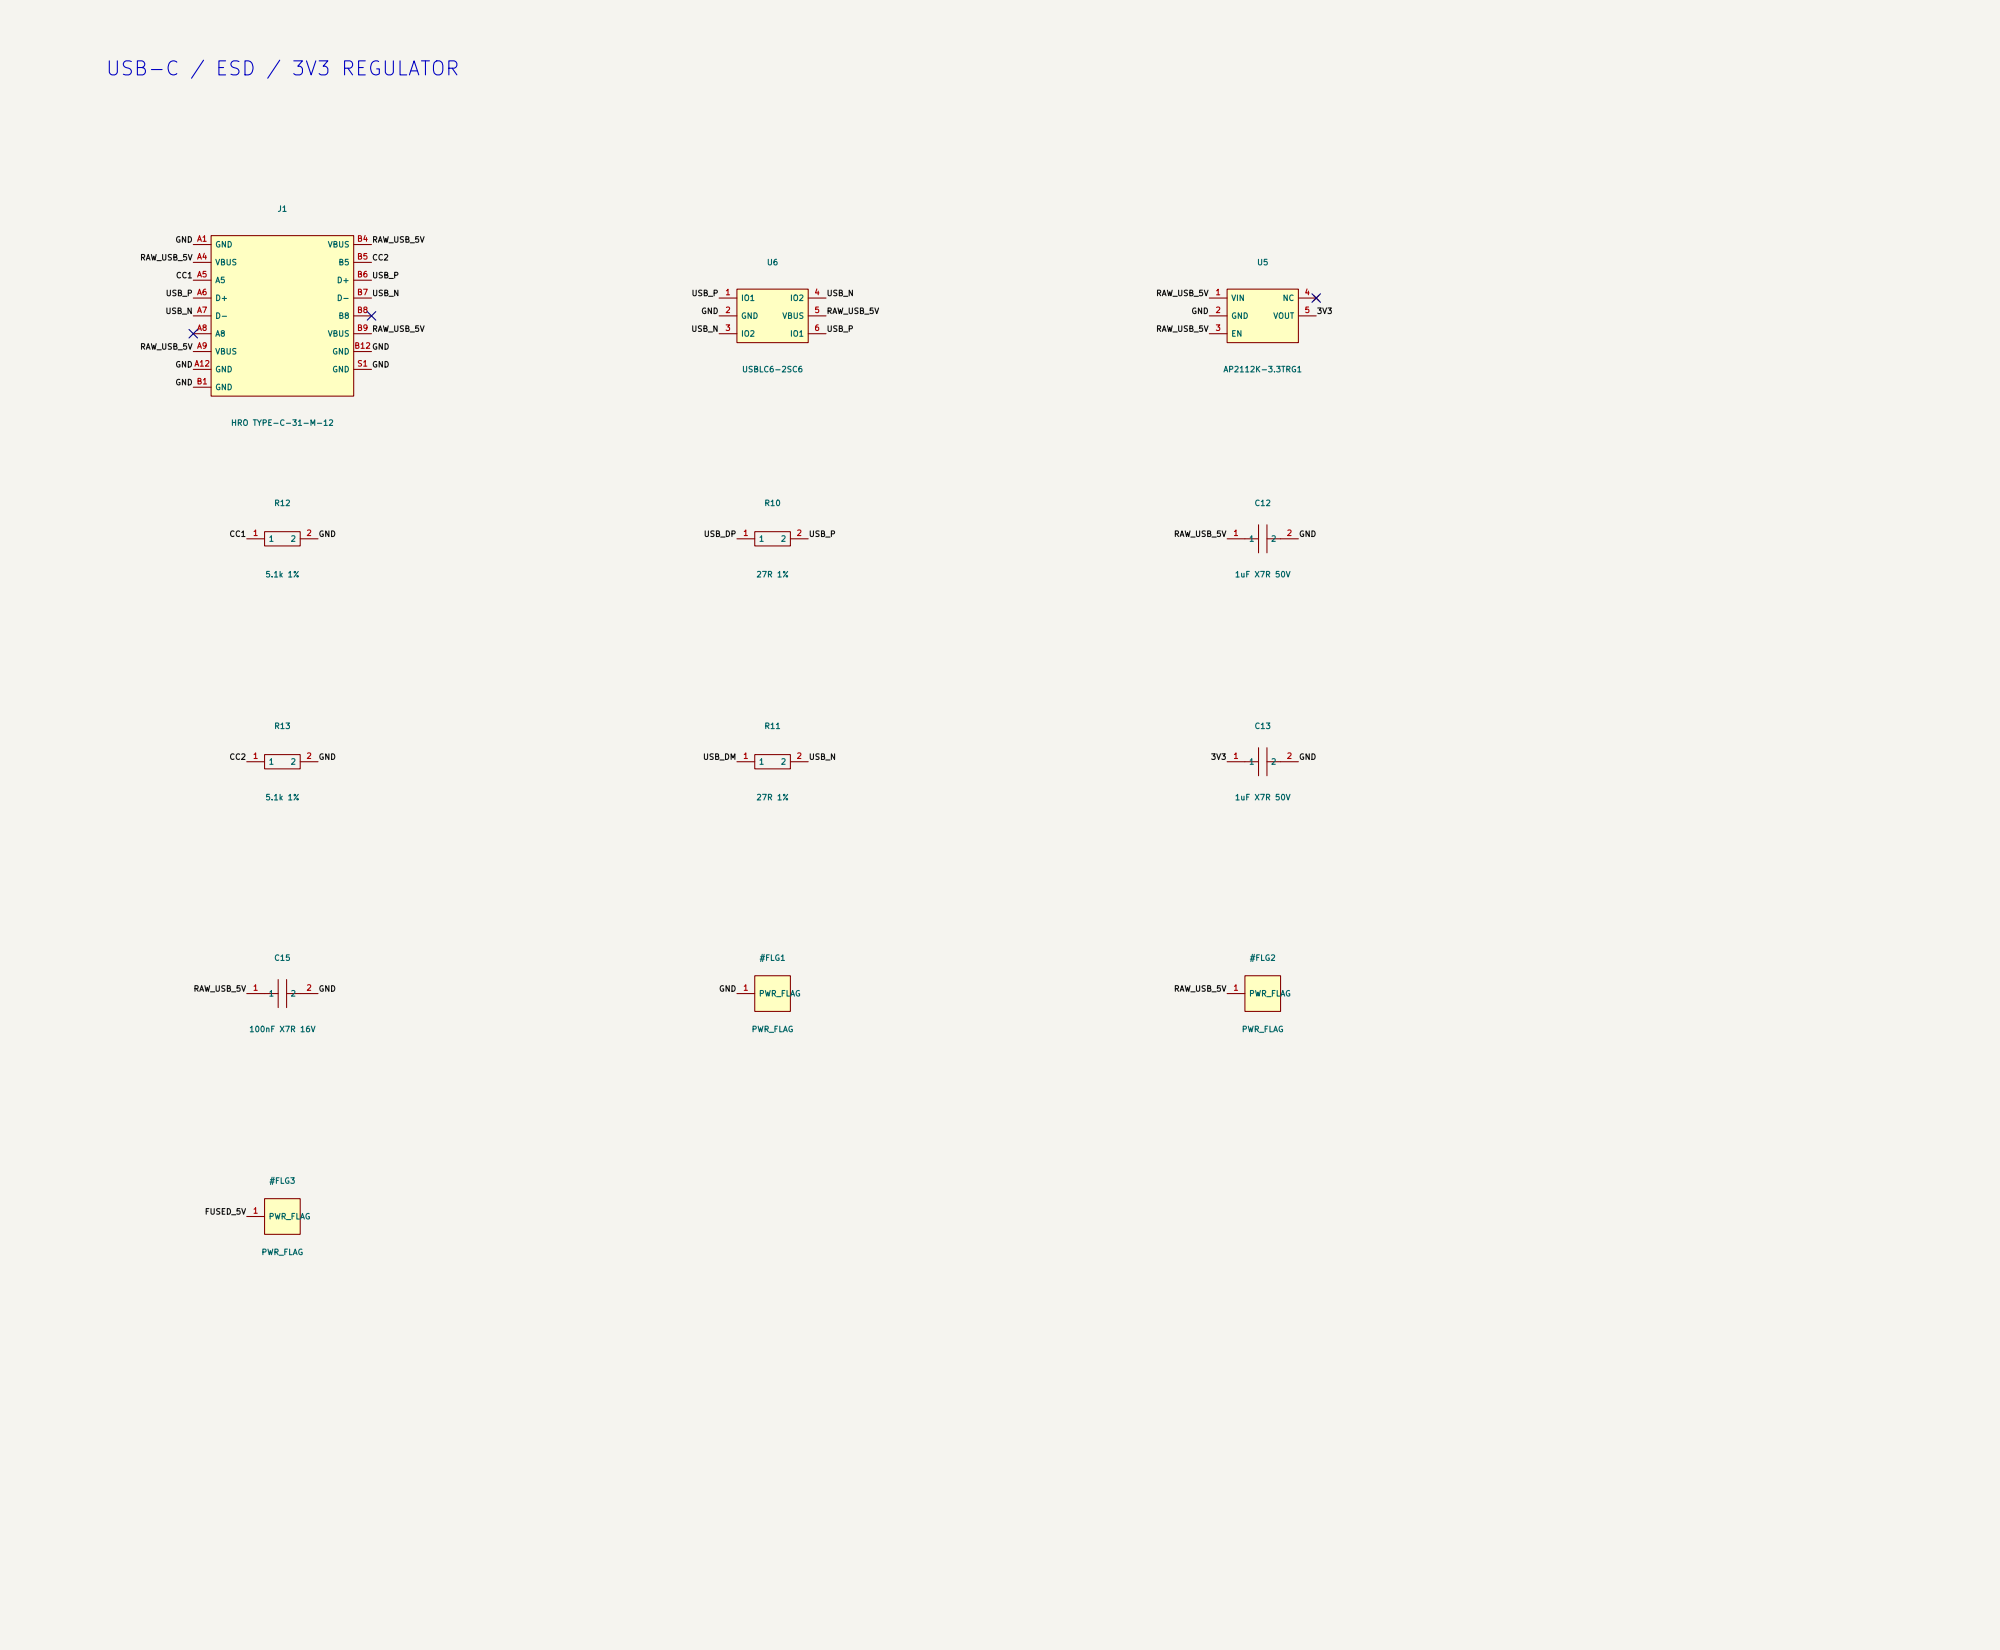
[picture p63: page 3]

1 | 2 | 3 | 4 | 5 | 6 | 7 | 8 | 9 | 10 | 11 | 12 | 13 | 14 | 15 | 16 | 17 | 18 | 19 | 20 | 21 | 22 | 23 1 | 2 | 3 | 4 | 5 | 6 | 7 | 8 | 9 | 10 | 11 | 12 | 13 | 14 | 15 | 16 | 17 | 18 | 19 | 20 | 21 | 22 | 23 ABCDEFGHIJKLMNOPQRSTUVW | ABCDEFGHIJKLMNOPQRSTUVW Date: 2026-11-09
22uF 10V X5R 1 1 | 2 2

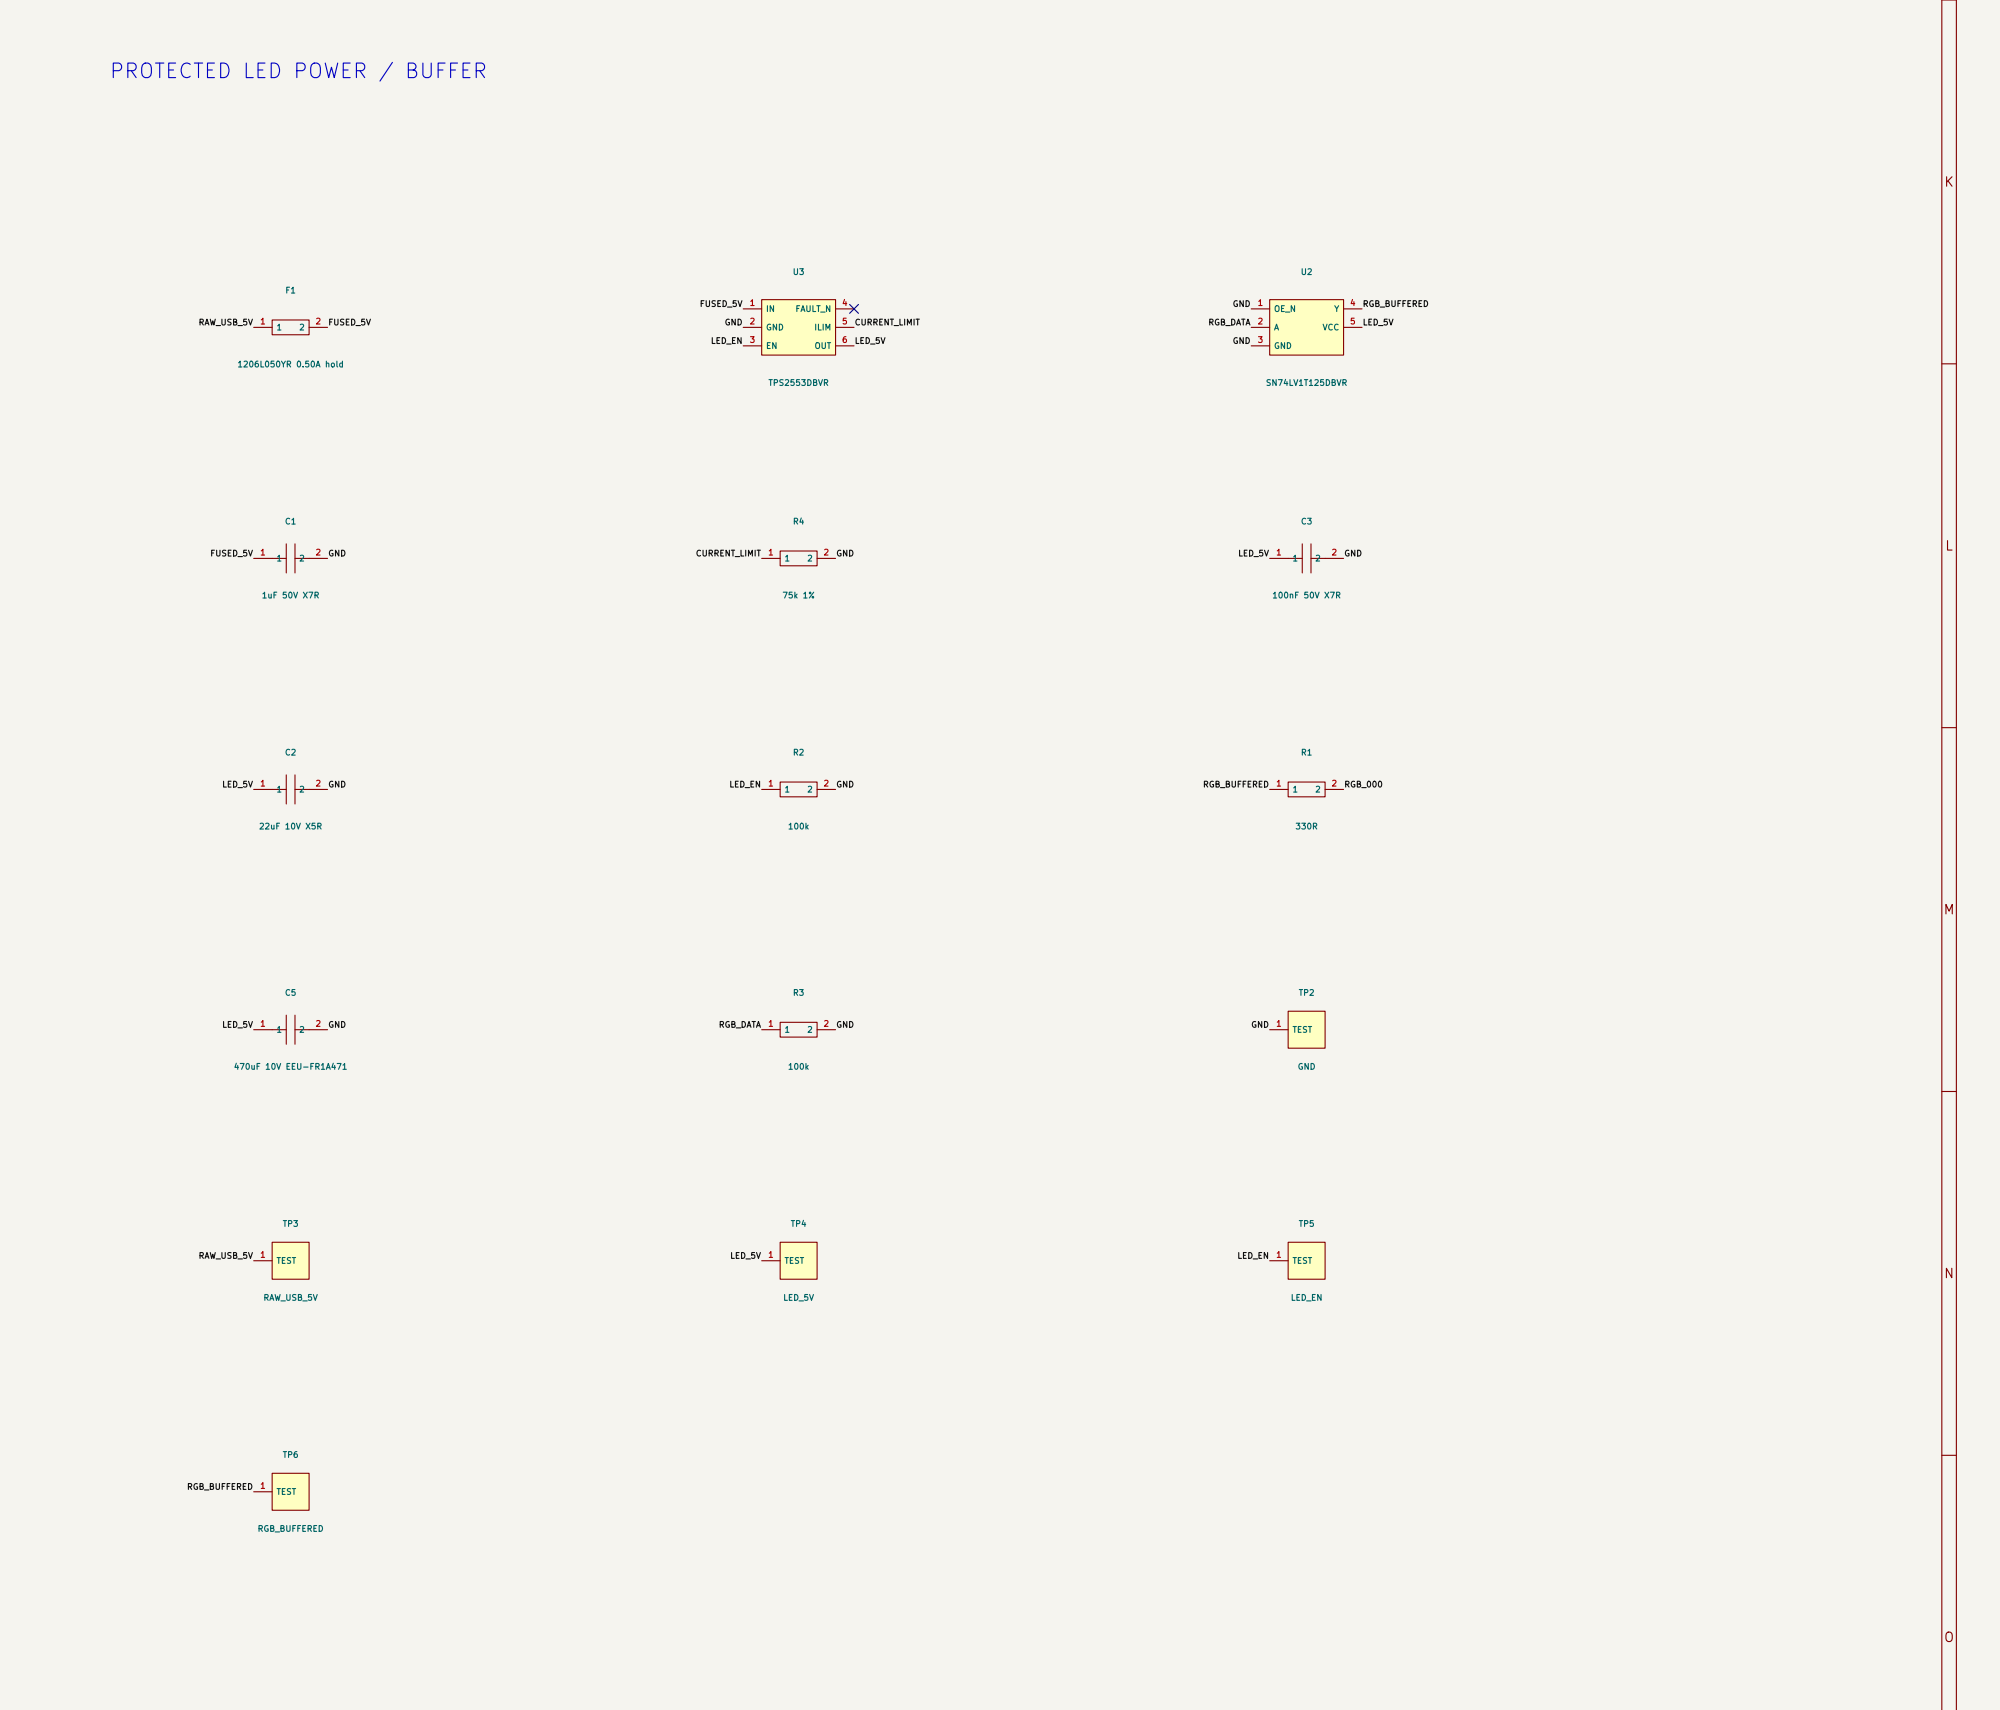
[picture p64: page 4]
