68mschmitt/cleavboard/designs/embedded-rp2040/docs/Cleaver-Embedded-schematic.pdf

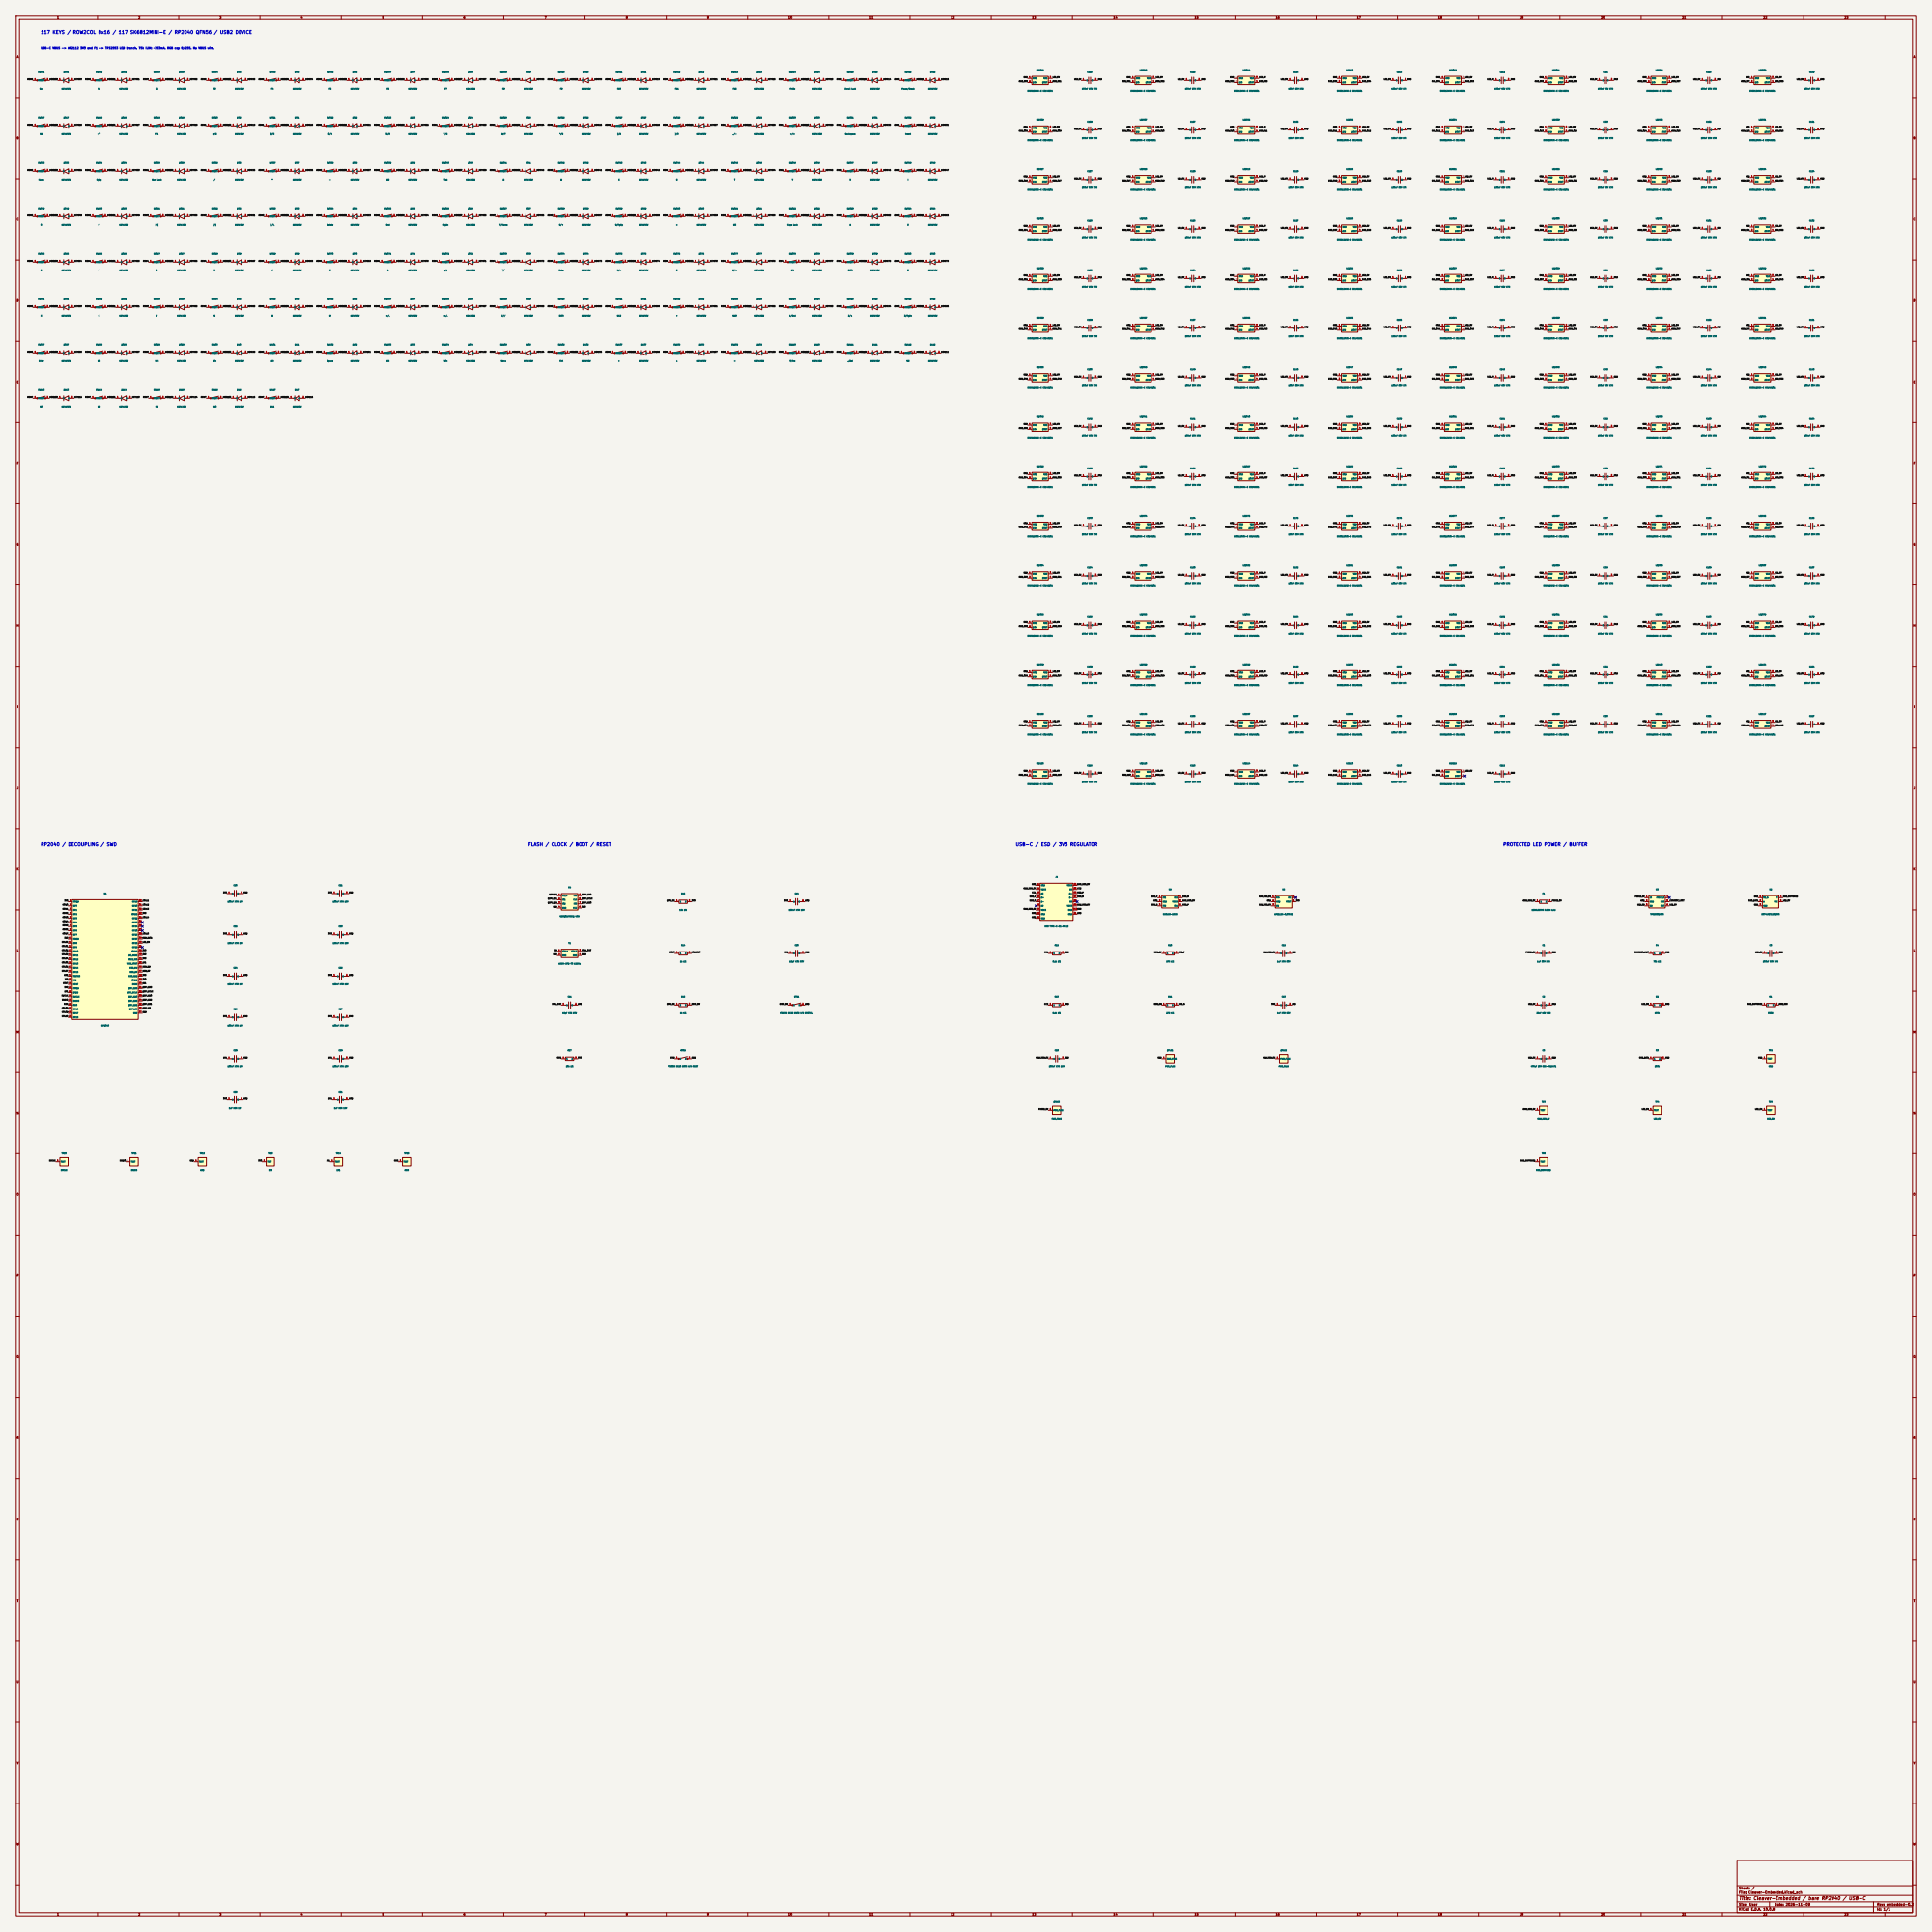
[picture p65: page 1]

USB-C VBUS -> AP2112 3V3 and F1 -> TPS2553 LED branch. 75k ILIM: ~353mA. RGB cap 8/255. No VBUS wire. 117 KEYS / ROW2COL 8x16 / 117 SK6812MINI-E / RP2040 QFN56 / USB2 DEVICE

Sheet: /
File: Cleaver-Embedded.kicad_sch
Title: Cleaver-Embedded / bare RP2040 / USB-C
