68mschmitt/cleavboard/(list of files, drawings)

Other design files:
designs/module-rp2040/manufacturing/rev0.8/checks/placement/Cleaver.dsn
