68mschmitt/cleavboard/designs/module-rp2040/Cleaver.kicad_pcb

## KiCad design designs/module-rp2040/Cleaver.kicad_pcb (2026-11-13)

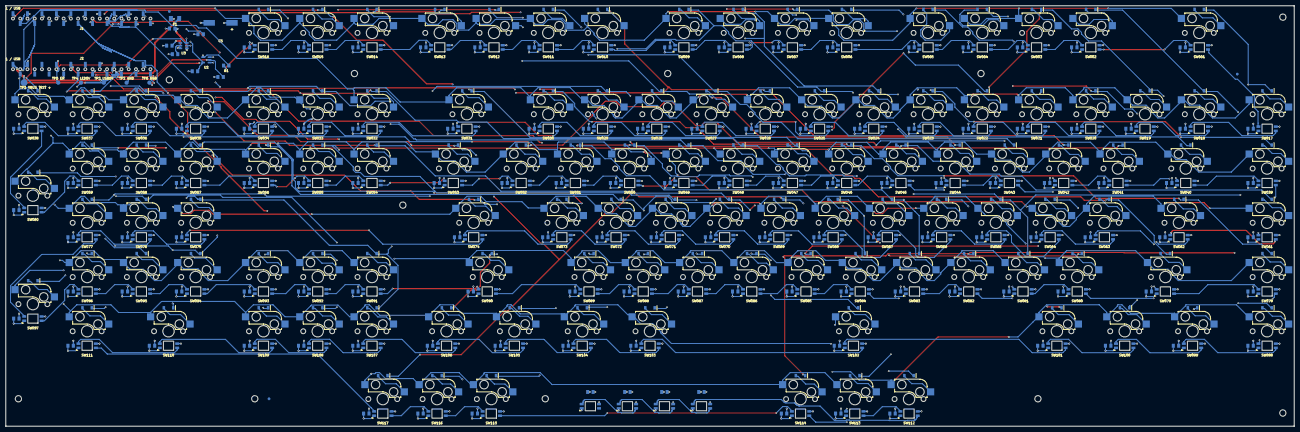
[picture p66: board Cleaver.kicad_pcb from below]

Board: 4 copper layers, 452.4 x 147.6 mm, 511 parts (498 on the bottom side), 270 nets.

Parts:
C1: 1uF 50V X7R; C_0805
C2: 22uF 10V X5R; C_0805
C3, C101, C102, C103, C104, C105, C106, C107, C108, C109, C110, C111, C112, C113, C114, C115, C116, C117, C118, C119, C120, C121, C122, C123, C124, C125, C126, C127, C128, C129, C130, C131, C132, C133, C134, C135, C136, C137, C138, C139, C140, C141, C142, C143, C144, C145, C146, C147, C148, C149, C150, C151, C152, C153, C154, C155, C156, C157, C158, C159, C160, C161, C162, C163, C164, C165, C166, C167, C168, C169, C170, C171, C172, C173, C174, C175, C176, C177, C178, C179, C180, C181, C182, C183, C184, C185, C186, C187, C188, C189, C190, C191, C192, C193, C194, C195, C196, C197, C198, C199, C200, C201, C202, C203, C204, C205, C206, C207, C208, C209, C210, C211, C212, C213, C214, C215, C216, C217, C218, C219, C220, C221: 100nF 50V X7R; C_0805
C5: 470uF 10V PCF1A471MCL1GS; C_PCF_D10
D001, D002, D003, D004, D005, D006, D007, D008, D009, D010, D011, D012, D013, D014, D015, D016, D017, D018, D019, D020, D021, D022, D023, D024, D025, D026, D027, D028, D029, D030, D031, D032, D033, D034, D035, D036, D037, D038, D039, D040, D041, D042, D043, D044, D045, D046, D047, D048, D049, D050, D051, D052, D053, D054, D055, D056, D057, D058, D059, D060, D061, D062, D063, D064, D065, D066, D067, D068, D069, D070, D071, D072, D073, D074, D075, D076, D077, D078, D079, D080, D081, D082, D083, D084, D085, D086, D087, D088, D089, D090, D091, D092, D093, D094, D095, D096, D097, D098, D099, D100, D101, D102, D103, D104, D105, D106, D107, D108, D109, D110, D111, D112, D113, D114, D115, D116, D117: 1N4148W; D_SOD123
F1: 1206L050YR 0.50A hold; PTC_1206
FID1, FID2, FID3: Fiducial
H1, H2, H3, H4, H5, H6, H7, H8, H9, H10, H11: MountingHole_M2
J1, J2: M20-7862042; Harwin_M20_7862042
LED001, LED002, LED003, LED004, LED005, LED006, LED007, LED008, LED009, LED010, LED011, LED012, LED013, LED014, LED015, LED016, LED017, LED018, LED019, LED020, LED021, LED022, LED023, LED024, LED025, LED026, LED027, LED028, LED029, LED030, LED031, LED032, LED033, LED034, LED035, LED036, LED037, LED038, LED039, LED040, LED041, LED042, LED043, LED044, LED045, LED046, LED047, LED048, LED049, LED050, LED051, LED052, LED053, LED054, LED055, LED056, LED057, LED058, LED059, LED060, LED061, LED062, LED063, LED064, LED065, LED066, LED067, LED068, LED069, LED070, LED071, LED072, LED073, LED074, LED075, LED076, LED077, LED078, LED079, LED080, LED081, LED082, LED083, LED084, LED085, LED086, LED087, LED088, LED089, LED090, LED091, LED092, LED093, LED094, LED095, LED096, LED097, LED098, LED099, LED100, LED101, LED102, LED103, LED104, LED105, LED106, LED107, LED108, LED109, LED110, LED111, LED112, LED113, LED114, LED115, LED116, LED117, LED118, LED119, LED120, LED121: SK6812MINI-E C5149201; MINI_E
LOGO1: TavianaTactical_34mm
R1: 330R; R_0805
R2, R3: 100k; R_0805
R4: 75k 1%; R_0805
SW001, SW002, SW003, SW004, SW005, SW006, SW007, SW008, SW009, SW010, SW011, SW012, SW013, SW014, SW015, SW016, SW017, SW018, SW019, SW020, SW021, SW022, SW023, SW024, SW025, SW026, SW027, SW028, SW029, SW030, SW031, SW032, SW033, SW034, SW035, SW036, SW037, SW038, SW039, SW040, SW041, SW042, SW043, SW044, SW045, SW046, SW047, SW048, SW049, SW050, SW051, SW052, SW053, SW054, SW055, SW056, SW057, SW058, SW059, SW060, SW061, SW062, SW063, SW064, SW065, SW066, SW067, SW068, SW069, SW070, SW071, SW072, SW073, SW074, SW075, SW076, SW077, SW078, SW079, SW080, SW081, SW082, SW083, SW084, SW085, SW086, SW087, SW088, SW089, SW090, SW091, SW092, SW093, SW094, SW095, SW096, SW097, SW098, SW099, SW100, SW101, SW102, SW103, SW104, SW105, SW106, SW107, SW108, SW109, SW110, SW111, SW112, SW113, SW114, SW115, SW116, SW117: CPG151101S11-16; HanElectricity_CPG151101S11-16
TP1: USB VBUS TEST +5V; WirePad
TP2: GND; TestPad
TP3: RAW_USB_5V; TestPad
TP4: LED_5V; TestPad
TP5: LED_EN; TestPad
TP6: RGB_BUFFERED; TestPad
U1: Waveshare RP2040-Plus 4MB; Waveshare_RP2040_Plus
U2: SN74LV1T125DBVR; LV1T125
U3: TPS2553DBVR; TPS2553

Connections:
/COL00: D001.1, D017.1, D033.1, D049.1, D065.1, D081.1, D097.1, D113.1, J1.11
/COL01: D002.1, D018.1, D034.1, D050.1, D066.1, D082.1, D098.1, D114.1, J1.12
/COL02: D003.1, D019.1, D035.1, D051.1, D067.1, D083.1, D099.1, D115.1, J1.14
/COL03: D004.1, D020.1, D036.1, D052.1, D068.1, D084.1, D100.1, D116.1, J1.15
/COL04: D005.1, D021.1, D037.1, D053.1, D069.1, D085.1, D101.1, D117.1, J1.16
/COL05: D006.1, D022.1, D038.1, D054.1, D070.1, D086.1, D102.1, J1.17
/COL06: D007.1, D023.1, D039.1, D055.1, D071.1, D087.1, D103.1, J1.19
/COL07: D008.1, D024.1, D040.1, D056.1, D072.1, D088.1, D104.1, J1.20
/COL08: D009.1, D025.1, D041.1, D057.1, D073.1, D089.1, D105.1, J2.20
/COL09: D010.1, D026.1, D042.1, D058.1, D074.1, D090.1, D106.1, J2.19
/COL10: D011.1, D027.1, D043.1, D059.1, D075.1, D091.1, D107.1, J2.17
/COL11: D012.1, D028.1, D044.1, D060.1, D076.1, D092.1, D108.1, J2.16
/COL12: D013.1, D029.1, D045.1, D061.1, D077.1, D093.1, D109.1, J2.15
/COL13: D014.1, D030.1, D046.1, D062.1, D078.1, D094.1, D110.1, J2.14
/COL14: D015.1, D031.1, D047.1, D063.1, D079.1, D095.1, D111.1, J2.12
/COL15: D016.1, D032.1, D048.1, D064.1, D080.1, D096.1, D112.1, J2.10
/CURRENT_LIMIT: R4.1, U3.5
/FUSED_5V: C1.1, F1.2, U3.1
/GND: C1.2, C2.2, C3.2, C5.2, C101.2, C102.2, C103.2, C104.2, C105.2, C106.2, C107.2, C108.2, C109.2, C110.2, C111.2, C112.2, C113.2, C114.2, C115.2, C116.2, C117.2, C118.2, C119.2, C120.2, C121.2, C122.2, C123.2, C124.2, C125.2, C126.2, C127.2, C128.2, C129.2, C130.2, C131.2, C132.2, C133.2, C134.2, C135.2, C136.2, C137.2, C138.2, C139.2, C140.2, C141.2, C142.2, C143.2, C144.2, C145.2, C146.2, C147.2, C148.2, C149.2, C150.2, C151.2, C152.2, C153.2, C154.2, C155.2, C156.2, C157.2, C158.2, C159.2, C160.2, C161.2, C162.2, C163.2, C164.2, C165.2, C166.2, C167.2, C168.2, C169.2, C170.2, C171.2, C172.2, C173.2, C174.2, C175.2, C176.2, C177.2, C178.2, C179.2, C180.2, C181.2, C182.2, C183.2, C184.2, C185.2, C186.2, C187.2, C188.2, C189.2, C190.2, C191.2, C192.2, C193.2, C194.2, C195.2, C196.2, C197.2, C198.2, C199.2, C200.2, C201.2, C202.2, C203.2, C204.2, C205.2, C206.2, C207.2, C208.2, C209.2, C210.2, C211.2, C212.2, C213.2, C214.2, C215.2, C216.2, C217.2, C218.2, C219.2, C220.2, C221.2, J1.3, J1.8, J1.13, J1.18, J2.3, J2.8, J2.13, J2.18, LED001.1, LED002.1, LED003.1, LED004.1, LED005.1, LED006.1, LED007.1, LED008.1, LED009.1, LED010.1, LED011.1, LED012.1, LED013.1, LED014.1, LED015.1, LED016.1, LED017.1, LED018.1, LED019.1, LED020.1, LED021.1, LED022.1, LED023.1, LED024.1, LED025.1, LED026.1, LED027.1, LED028.1, LED029.1, LED030.1, LED031.1, LED032.1, LED033.1, LED034.1, LED035.1, LED036.1, LED037.1, LED038.1, LED039.1, LED040.1, LED041.1, LED042.1, LED043.1, LED044.1, LED045.1, LED046.1, LED047.1, LED048.1, LED049.1, LED050.1, LED051.1, LED052.1, LED053.1, LED054.1, LED055.1, LED056.1, LED057.1, LED058.1, LED059.1, LED060.1, LED061.1, LED062.1, LED063.1, LED064.1, LED065.1, LED066.1, LED067.1, LED068.1, LED069.1, LED070.1, LED071.1, LED072.1, LED073.1, LED074.1, LED075.1, LED076.1, LED077.1, LED078.1, LED079.1, LED080.1, LED081.1, LED082.1, LED083.1, LED084.1, LED085.1, LED086.1, LED087.1, LED088.1, LED089.1, LED090.1, LED091.1, LED092.1, LED093.1, LED094.1, LED095.1, LED096.1, LED097.1, LED098.1, LED099.1, LED100.1, LED101.1, LED102.1, LED103.1, LED104.1, LED105.1, LED106.1, LED107.1, LED108.1, LED109.1, LED110.1, LED111.1, LED112.1, LED113.1, LED114.1, LED115.1, LED116.1, LED117.1, LED118.1, LED119.1, LED120.1, LED121.1, R2.2, R3.2, R4.2, TP2.1, U2.1, U2.3, U3.2
/KEY000: D001.2, SW001.2
/KEY001: D002.2, SW002.2
/KEY002: D003.2, SW003.2
/KEY003: D004.2, SW004.2
/KEY004: D005.2, SW005.2
/KEY005: D006.2, SW006.2
/KEY006: D007.2, SW007.2
/KEY007: D008.2, SW008.2
/KEY008: D009.2, SW009.2
/KEY009: D010.2, SW010.2
/KEY010: D011.2, SW011.2
/KEY011: D012.2, SW012.2
/KEY012: D013.2, SW013.2
/KEY013: D014.2, SW014.2
/KEY014: D015.2, SW015.2
/KEY015: D016.2, SW016.2
/KEY016: D017.2, SW017.2
/KEY017: D018.2, SW018.2
/KEY018: D019.2, SW019.2
/KEY019: D020.2, SW020.2
/KEY020: D021.2, SW021.2
/KEY021: D022.2, SW022.2
/KEY022: D023.2, SW023.2
/KEY023: D024.2, SW024.2
/KEY024: D025.2, SW025.2
/KEY025: D026.2, SW026.2
/KEY026: D027.2, SW027.2
/KEY027: D028.2, SW028.2
/KEY028: D029.2, SW029.2
/KEY029: D030.2, SW030.2
/KEY030: D031.2, SW031.2
/KEY031: D032.2, SW032.2
/KEY032: D033.2, SW033.2
/KEY033: D034.2, SW034.2
/KEY034: D035.2, SW035.2
/KEY035: D036.2, SW036.2
/KEY036: D037.2, SW037.2
/KEY037: D038.2, SW038.2
/KEY038: D039.2, SW039.2
/KEY039: D040.2, SW040.2
/KEY040: D041.2, SW041.2
/KEY041: D042.2, SW042.2
/KEY042: D043.2, SW043.2
/KEY043: D044.2, SW044.2
/KEY044: D045.2, SW045.2
/KEY045: D046.2, SW046.2
/KEY046: D047.2, SW047.2
/KEY047: D048.2, SW048.2
/KEY048: D049.2, SW049.2
/KEY049: D050.2, SW050.2
/KEY050: D051.2, SW051.2
/KEY051: D052.2, SW052.2
/KEY052: D053.2, SW053.2
/KEY053: D054.2, SW054.2
/KEY054: D055.2, SW055.2
/KEY055: D056.2, SW056.2
/KEY056: D057.2, SW057.2
/KEY057: D058.2, SW058.2
/KEY058: D059.2, SW059.2
/KEY059: D060.2, SW060.2
/KEY060: D061.2, SW061.2
/KEY061: D062.2, SW062.2
/KEY062: D063.2, SW063.2
/KEY063: D064.2, SW064.2
/KEY064: D065.2, SW065.2
/KEY065: D066.2, SW066.2
/KEY066: D067.2, SW067.2
/KEY067: D068.2, SW068.2
/KEY068: D069.2, SW069.2
/KEY069: D070.2, SW070.2
/KEY070: D071.2, SW071.2
/KEY071: D072.2, SW072.2
/KEY072: D073.2, SW073.2
/KEY073: D074.2, SW074.2
/KEY074: D075.2, SW075.2
/KEY075: D076.2, SW076.2
/KEY076: D077.2, SW077.2
/KEY077: D078.2, SW078.2
/KEY078: D079.2, SW079.2
/KEY079: D080.2, SW080.2
/KEY080: D081.2, SW081.2
/KEY081: D082.2, SW082.2
/KEY082: D083.2, SW083.2
/KEY083: D084.2, SW084.2
/KEY084: D085.2, SW085.2
/KEY085: D086.2, SW086.2
/KEY086: D087.2, SW087.2
/KEY087: D088.2, SW088.2
/KEY088: D089.2, SW089.2
/KEY089: D090.2, SW090.2
/KEY090: D091.2, SW091.2
/KEY091: D092.2, SW092.2
/KEY092: D093.2, SW093.2
/KEY093: D094.2, SW094.2
/KEY094: D095.2, SW095.2
/KEY095: D096.2, SW096.2
/KEY096: D097.2, SW097.2
/KEY097: D098.2, SW098.2
/KEY098: D099.2, SW099.2
/KEY099: D100.2, SW100.2
/KEY100: D101.2, SW101.2
/KEY101: D102.2, SW102.2
/KEY102: D103.2, SW103.2
/KEY103: D104.2, SW104.2
/KEY104: D105.2, SW105.2
/KEY105: D106.2, SW106.2
/KEY106: D107.2, SW107.2
/KEY107: D108.2, SW108.2
/KEY108: D109.2, SW109.2
/KEY109: D110.2, SW110.2
/KEY110: D111.2, SW111.2
/KEY111: D112.2, SW112.2
/KEY112: D113.2, SW113.2
/KEY113: D114.2, SW114.2
/KEY114: D115.2, SW115.2
/KEY115: D116.2, SW116.2
/KEY116: D117.2, SW117.2
/LED_5V: C2.1, C3.1, C5.1, C101.1, C102.1, C103.1, C104.1, C105.1, C106.1, C107.1, C108.1, C109.1, C110.1, C111.1, C112.1, C113.1, C114.1, C115.1, C116.1, C117.1, C118.1, C119.1, C120.1, C121.1, C122.1, C123.1, C124.1, C125.1, C126.1, C127.1, C128.1, C129.1, C130.1, C131.1, C132.1, C133.1, C134.1, C135.1, C136.1, C137.1, C138.1, C139.1, C140.1, C141.1, C142.1, C143.1, C144.1, C145.1, C146.1, C147.1, C148.1, C149.1, C150.1, C151.1, C152.1, C153.1, C154.1, C155.1, C156.1, C157.1, C158.1, C159.1, C160.1, C161.1, C162.1, C163.1, C164.1, C165.1, C166.1, C167.1, C168.1, C169.1, C170.1, C171.1, C172.1, C173.1, C174.1, C175.1, C176.1, C177.1, C178.1, C179.1, C180.1, C181.1, C182.1, C183.1, C184.1, C185.1, C186.1, C187.1, C188.1, C189.1, C190.1, C191.1, C192.1, C193.1, C194.1, C195.1, C196.1, C197.1, C198.1, C199.1, C200.1, C201.1, C202.1, C203.1, C204.1, C205.1, C206.1, C207.1, C208.1, C209.1, C210.1, C211.1, C212.1, C213.1, C214.1, C215.1, C216.1, C217.1, C218.1, C219.1, C220.1, C221.1, LED001.3, LED002.3, LED003.3, LED004.3, LED005.3, LED006.3, LED007.3, LED008.3, LED009.3, LED010.3, LED011.3, LED012.3, LED013.3, LED014.3, LED015.3, LED016.3, LED017.3, LED018.3, LED019.3, LED020.3, LED021.3, LED022.3, LED023.3, LED024.3, LED025.3, LED026.3, LED027.3, LED028.3, LED029.3, LED030.3, LED031.3, LED032.3, LED033.3, LED034.3, LED035.3, LED036.3, LED037.3, LED038.3, LED039.3, LED040.3, LED041.3, LED042.3, LED043.3, LED044.3, LED045.3, LED046.3, LED047.3, LED048.3, LED049.3, LED050.3, LED051.3, LED052.3, LED053.3, LED054.3, LED055.3, LED056.3, LED057.3, LED058.3, LED059.3, LED060.3, LED061.3, LED062.3, LED063.3, LED064.3, LED065.3, LED066.3, LED067.3, LED068.3, LED069.3, LED070.3, LED071.3, LED072.3, LED073.3, LED074.3, LED075.3, LED076.3, LED077.3, LED078.3, LED079.3, LED080.3, LED081.3, LED082.3, LED083.3, LED084.3, LED085.3, LED086.3, LED087.3, LED088.3, LED089.3, LED090.3, LED091.3, LED092.3, LED093.3, LED094.3, LED095.3, LED096.3, LED097.3, LED098.3, LED099.3, LED100.3, LED101.3, LED102.3, LED103.3, LED104.3, LED105.3, LED106.3, LED107.3, LED108.3, LED109.3, LED110.3, LED111.3, LED112.3, LED113.3, LED114.3, LED115.3, LED116.3, LED117.3, LED118.3, LED119.3, LED120.3, LED121.3, TP4.1, U2.5, U3.6
/LED_EN: J2.7, R2.1, TP5.1, U3.3
/RAW_USB_5V: F1.1, J2.1, TP1.1, TP3.1
/RGB_000: LED016.2, R1.2
/RGB_001: LED015.2, LED016.4
/RGB_002: LED014.2, LED015.4
/RGB_003: LED013.2, LED014.4
/RGB_004: LED012.2, LED013.4
/RGB_005: LED011.2, LED012.4
/RGB_006: LED010.2, LED011.4
/RGB_007: LED009.2, LED010.4
/RGB_008: LED008.2, LED009.4
/RGB_009: LED007.2, LED008.4
/RGB_010: LED006.2, LED007.4
/RGB_011: LED005.2, LED006.4
/RGB_012: LED004.2, LED005.4
/RGB_013: LED003.2, LED004.4
/RGB_014: LED002.2, LED003.4
/RGB_015: LED001.2, LED002.4
/RGB_016: LED001.4, LED017.2
/RGB_017: LED017.4, LED018.2
/RGB_018: LED018.4, LED019.2
/RGB_019: LED019.4, LED020.2
/RGB_020: LED020.4, LED021.2
/RGB_021: LED021.4, LED022.2
/RGB_022: LED022.4, LED023.2
/RGB_023: LED023.4, LED024.2
/RGB_024: LED024.4, LED025.2
/RGB_025: LED025.4, LED026.2
/RGB_026: LED026.4, LED027.2
/RGB_027: LED027.4, LED028.2
/RGB_028: LED028.4, LED029.2
/RGB_029: LED029.4, LED030.2
/RGB_030: LED030.4, LED031.2
/RGB_031: LED031.4, LED032.2
/RGB_032: LED032.4, LED033.2
/RGB_033: LED033.4, LED034.2
/RGB_034: LED034.4, LED035.2
/RGB_035: LED035.4, LED036.2
/RGB_036: LED036.4, LED037.2
/RGB_037: LED037.4, LED038.2
/RGB_038: LED038.4, LED060.2
/RGB_039: LED059.2, LED060.4
/RGB_040: LED058.2, LED059.4
/RGB_041: LED057.2, LED058.4
/RGB_042: LED056.2, LED057.4
/RGB_043: LED055.2, LED056.4
/RGB_044: LED054.2, LED055.4
/RGB_045: LED053.2, LED054.4
/RGB_046: LED052.2, LED053.4
/RGB_047: LED051.2, LED052.4
/RGB_048: LED050.2, LED051.4
/RGB_049: LED049.2, LED050.4
/RGB_050: LED048.2, LED049.4
/RGB_051: LED047.2, LED048.4
/RGB_052: LED046.2, LED047.4
/RGB_053: LED045.2, LED046.4
/RGB_054: LED044.2, LED045.4
/RGB_055: LED043.2, LED044.4
/RGB_056: LED042.2, LED043.4
/RGB_057: LED041.2, LED042.4
/RGB_058: LED040.2, LED041.4
/RGB_059: LED039.2, LED040.4
/RGB_060: LED039.4, LED061.2
/RGB_061: LED061.4, LED062.2
/RGB_062: LED062.4, LED063.2
/RGB_063: LED063.4, LED064.2
/RGB_064: LED064.4, LED065.2
/RGB_065: LED065.4, LED066.2
/RGB_066: LED066.4, LED067.2
/RGB_067: LED067.4, LED068.2
/RGB_068: LED068.4, LED069.2
/RGB_069: LED069.4, LED070.2
/RGB_070: LED070.4, LED071.2
/RGB_071: LED071.4, LED072.2
/RGB_072: LED072.4, LED073.2
/RGB_073: LED073.4, LED074.2
/RGB_074: LED074.4, LED075.2
/RGB_075: LED075.4, LED076.2
/RGB_076: LED076.4, LED077.2
/RGB_077: LED077.4, LED097.2
/RGB_078: LED096.2, LED097.4
/RGB_079: LED095.2, LED096.4
/RGB_080: LED094.2, LED095.4
/RGB_081: LED093.2, LED094.4
/RGB_082: LED092.2, LED093.4
/RGB_083: LED091.2, LED092.4
/RGB_084: LED090.2, LED091.4
/RGB_085: LED089.2, LED090.4
/RGB_086: LED088.2, LED089.4
/RGB_087: LED087.2, LED088.4
/RGB_088: LED086.2, LED087.4
/RGB_089: LED085.2, LED086.4
/RGB_090: LED084.2, LED085.4
/RGB_091: LED083.2, LED084.4
/RGB_092: LED082.2, LED083.4
/RGB_093: LED081.2, LED082.4
/RGB_094: LED080.2, LED081.4
/RGB_095: LED079.2, LED080.4
/RGB_096: LED078.2, LED079.4
/RGB_097: LED078.4, LED098.2
/RGB_098: LED098.4, LED099.2
/RGB_099: LED099.4, LED100.2
/RGB_100: LED100.4, LED101.2
/RGB_101: LED101.4, LED102.2
/RGB_102: LED102.4, LED103.2
/RGB_103: LED103.4, LED104.2
/RGB_104: LED104.4, LED105.2
/RGB_105: LED105.4, LED106.2
/RGB_106: LED106.4, LED107.2
/RGB_107: LED107.4, LED108.2
/RGB_108: LED108.4, LED109.2
/RGB_109: LED109.4, LED110.2
/RGB_110: LED110.4, LED111.2
/RGB_111: LED111.4, LED117.2
/RGB_112: LED116.2, LED117.4
/RGB_113: LED115.2, LED116.4
/RGB_114: LED114.2, LED115.4
/RGB_115: LED113.2, LED114.4
/RGB_116: LED112.2, LED113.4
/RGB_117: LED112.4, LED118.2
/RGB_118: LED118.4, LED119.2
/RGB_119: LED119.4, LED120.2
/RGB_120: LED120.4, LED121.2
/RGB_BUFFERED: R1.1, TP6.1, U2.4
/RGB_DATA: J2.9, R3.1, U2.2
/ROW0: J1.1, SW001.1, SW002.1, SW003.1, SW004.1, SW005.1, SW006.1, SW007.1, SW008.1, SW009.1, SW010.1, SW011.1, SW012.1, SW013.1, SW014.1, SW015.1, SW016.1
/ROW1: J1.2, SW017.1, SW018.1, SW019.1, SW020.1, SW021.1, SW022.1, SW023.1, SW024.1, SW025.1, SW026.1, SW027.1, SW028.1, SW029.1, SW030.1, SW031.1, SW032.1
/ROW2: J1.4, SW033.1, SW034.1, SW035.1, SW036.1, SW037.1, SW038.1, SW039.1, SW040.1, SW041.1, SW042.1, SW043.1, SW044.1, SW045.1, SW046.1, SW047.1, SW048.1
/ROW3: J1.5, SW049.1, SW050.1, SW051.1, SW052.1, SW053.1, SW054.1, SW055.1, SW056.1, SW057.1, SW058.1, SW059.1, SW060.1, SW061.1, SW062.1, SW063.1, SW064.1
/ROW4: J1.6, SW065.1, SW066.1, SW067.1, SW068.1, SW069.1, SW070.1, SW071.1, SW072.1, SW073.1, SW074.1, SW075.1, SW076.1, SW077.1, SW078.1, SW079.1, SW080.1
/ROW5: J1.7, SW081.1, SW082.1, SW083.1, SW084.1, SW085.1, SW086.1, SW087.1, SW088.1, SW089.1, SW090.1, SW091.1, SW092.1, SW093.1, SW094.1, SW095.1, SW096.1
/ROW6: J1.9, SW097.1, SW098.1, SW099.1, SW100.1, SW101.1, SW102.1, SW103.1, SW104.1, SW105.1, SW106.1, SW107.1, SW108.1, SW109.1, SW110.1, SW111.1, SW112.1
/ROW7: J1.10, SW113.1, SW114.1, SW115.1, SW116.1, SW117.1
