68mschmitt/cleavboard/designs/module-rp2040/source/assembly_parts.py

"""Purchasing identities for the populated underside, checked 2026-11-10.

Manufacturer codes are authoritative, not interchangeable package-name matches.
Catalog listings establish sourcing support, not reserved inventory or DFM approval.
"""
PARTS = {
    'MX': ('HanElectricity', 'CPG151101S11-16', 'C41430893', 'SMD MX socket 14.5x5.9mm'),
    'D_SOD123': ('Semtech', '1N4148W', 'C81598', 'SOD-123'),
    'MINI_E': ('OPSCO Optoelectronics', 'SK6812MINI-E', 'C5149201', 'Reverse-mount 3.2x2.8mm'),
    '100nF 50V X7R': ('YAGEO', 'CC0805KRX7R9BB104', 'C49678', '0805'),
    '1uF 50V X7R': ('Samsung Electro-Mechanics', 'CL21B105KBFNNNE', 'C28323', '0805'),
    '22uF 10V X5R': ('Samsung Electro-Mechanics', 'CL21A226MPQNNNE', 'C29277', '0805'),
    '330R': ('UNI-ROYAL', '0805W8F3300T5E', 'C17630', '0805 1%'),
    '100k': ('UNI-ROYAL', '0805W8F1003T5E', 'C149504', '0805 1%'),
    '75k 1%': ('UNI-ROYAL', '0805W8F7502T5E', 'C17819', '0805 1%'),
    'PTC_1206': ('Littelfuse', '1206L050YR', 'C163512', '1206'),
    'LV1T125': ('Texas Instruments', 'SN74LV1T125DBVR', 'C473338', 'SOT-23-5'),
    'TPS2553': ('Texas Instruments', 'TPS2553DBVR', 'C55266', 'SOT-23-6'),
    'C_PCF_D10': ('Nichicon', 'PCF1A471MCL1GS', 'C3275369', 'SMD D10x10mm polymer'),
    'Harwin_M20_7862042': ('Harwin', 'M20-7862042', 'C5379059', 'SMD 1x20 P2.54 bottom entry'),
}
USER_ASSEMBLED = {'Waveshare_RP2040_Plus', 'WirePad', 'TestPad'}


def purchase(part):
    if part['kind'] in USER_ASSEMBLED:
        return None
    return PARTS.get(part['kind']) or PARTS[part['value']]


def fields(part):
    if part['kind'] == 'PowerFlag':
        return {}
    identity = purchase(part)
    result = dict(zip(('Manufacturer', 'MPN', 'LCSC', 'Package'), identity)) if identity else {}
    if 'key_label' in part:
        result['Key'] = part['key_label']
    return result
