68mschmitt/cleavboard/(commit log)

2026-11-08 first pcb pass
    [Cleaver.kicad_pcb, Cleaver.kicad_sch, key_matrix.csv]
2026-11-08 3d rendering components
    [Cleaver.kicad_pcb]
2026-11-09 Complete rev0.4 underside assembly, mounting and manufacturing package
    [BOM-JLCPCB.csv, BOM.csv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]
2026-11-09 Add clearance-aware trace simplification with junction regression checks
    [clean_routing.py]
2026-11-09 Clean trace jogs and regenerate verified routing and manufacturing outputs
    [Cleaver-B_Cu.gbl, Cleaver-B_Mask.gbs, Cleaver-B_Paste.gbp, Cleaver-B_Silkscreen.gbo, Cleaver-Edge_Cuts.gm1, Cleaver-F_Cu.gtl, Cleaver-F_Mask.gts, Cleaver-F_Paste.gtp]
2026-11-09 pcb review
2026-11-09 Stl tester
    [Cleaver-PCB-1-left.stl, Cleaver-PCB-2-middle-left.stl, Cleaver-PCB-3-middle-right.stl, Cleaver-PCB-4-right.stl, Cleaver.stl]
2026-11-10 Add embedded RP2040 design with underside assembly and clean routing
    Keep the module-based design intact and document both hardware variants. Include embedded-0.2 KiCad sources, local libraries, reproducible routing, BOM, Vial firmware, before/after review images, and independent validation tools and evidence.
    [BOM.csv, Cleaver-Embedded.kicad_pcb, Cleaver-Embedded.kicad_sch, key_matrix.csv, legacy-base.kicad_pcb]
2026-11-10 Complete revision 0.5 hardware, manufacturing and firmware releases
    Include bottom-only SMT assembly and current sourcing, validated routing and manufacturing exports, default and Vial firmware builds, single-color devboard variant, Taviana artwork and embedded-design deliverables. Remove obsolete loose Gerbers and record the KiCad local-history snapshot.
    [BOM-JLCPCB.csv, BOM.csv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]
2026-11-11 kicad org
2026-11-12 lots of work
    [BOM-JLCPCB.csv, BOM.csv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]
2026-11-12 Showcase rev0.6 keyboard with assembled CAD rendering
2026-11-13 Add rev0.7 controller sockets and corrected PnP rotations
    Replace direct-soldered controller pads with underside Harwin SMT sockets and NPTH pin entries. Add socket-support case ribs, selectable shims, models, fabrication exports, sourcing evidence, and validation reports.
    Apply JLCPCB catalog rotation corrections: U2 +90 degrees counterclockwise and all 117 switch sockets +180 degrees. Preserve PCB geometry, placement coordinates, firmware, and historical release packages.
    Validation: 55 tests pass, clean ERC/DRC and schematic parity, exact copper regeneration, and verified SHA-256 manifest. Supplier DFM/placement approval and physical mating remain release gates.
    [BOM-JLCPCB.csv, BOM.csv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]
2026-11-13 Add rev0.8 illuminated modular logo and matching case
    [BOM-JLCPCB.csv, BOM.csv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]
2026-11-13 Add rev0.9 two-inch illuminated badge and refreshed showcase
    [BOM-JLCPCB.csv, BOM.csv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]
